benwys/SparrowHawk/hardware/Frame-5in/renders/render_top.png

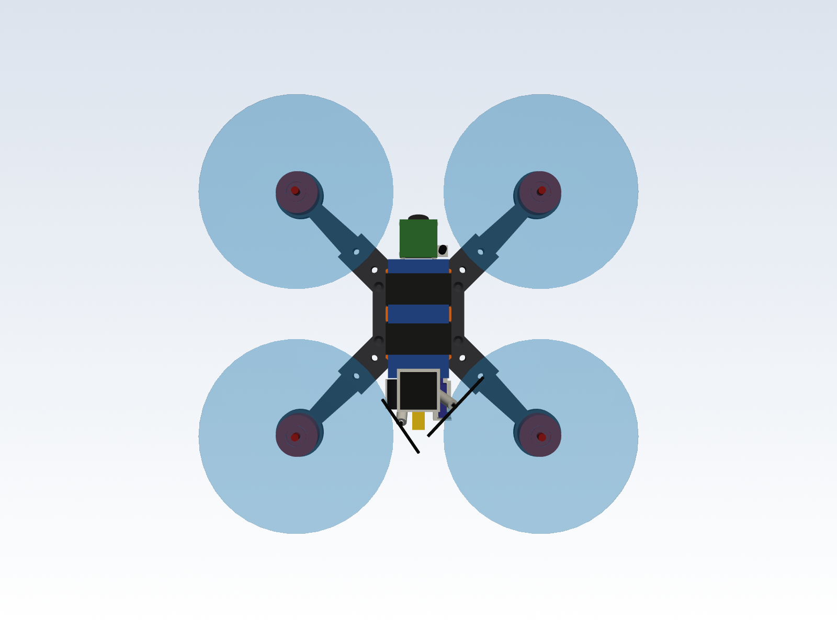
hardware/Frame-5in/renders/render_top.png
