benwys/SparrowHawk/hardware/Frame-5in/renders/render_iso.png

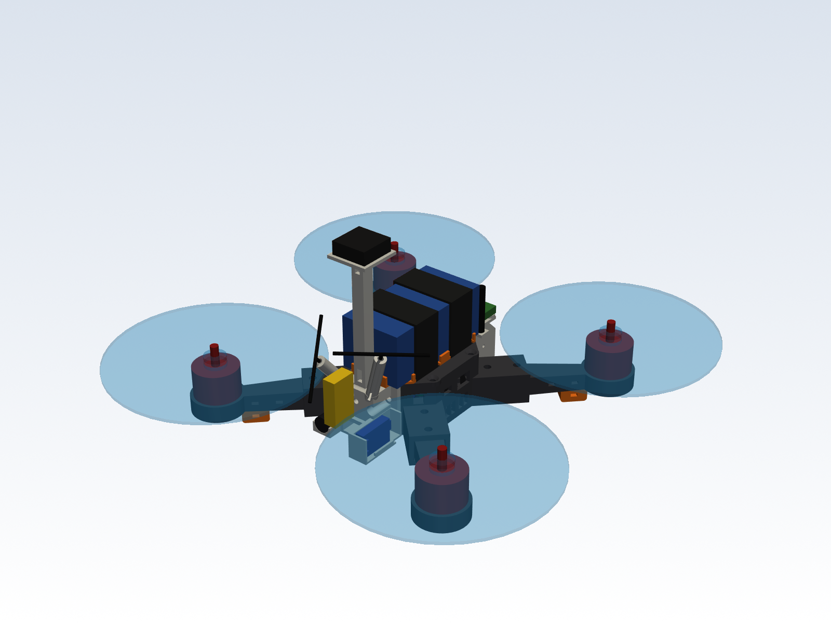
hardware/Frame-5in/renders/render_iso.png
