benwys/SparrowHawk/hardware/Sparrow-III/README.md

# Sparrow-III

Projekt KiCad: **Flight Controller.kicad_pro**.

- [Dokumentacja i stan prac](../../docs/Sparrow-III/README.md)
- [Backlog](../../docs/Sparrow-III/BACKLOG.md)
- [Raport kontroli](../../docs/Sparrow-III/REVIEW.md)
- [Skrypty](../../tools/Sparrow-III/README.md)

Biblioteki są lokalne w `Libraries/`; tabele używają `${KIPRJMOD}`.
Etap: placement, przed pełnym routingiem.

[Wspólna próba trasowania](attempts/placement-closure-20260912/Flight%20Controller.kicad_pro) jest osobnym projektem z miedzią. Główny placement pozostaje bez routingu.
