benwys/SparrowHawk/hardware/Sparrow-III/Production/paczka-report.md

# Pakiet produkcyjny — Flight_Controller-III-order-20261003

Status: **clear** (błędy: 0, ostrzeżenia: 1, informacje: 1).

Źródło: `/tmp/claude-1000/-home-benio-Desktop-SparrowHawk/64d008f5-8a54-4878-97ff-b0f477662982/scratchpad/cand` / `Flight Controller.kicad_pcb` + `Flight Controller.kicad_sch`; KiCad 10.0.6; rewizja: III-order-20261003

Paczka nie jest zgodą na zamówienie. Przed zamówieniem obejrzyj warstwy i obroty w podglądzie producenta i przejrzyj otwarte punkty.

## Ostrzeżenia

- [jlcpcb] montaż na spodzie: obroty i położenie elementów strony Bottom sprawdź w podglądzie producenta

## Informacje

- [assembly] na płytce, ale poza BOM: H_MNT1, H_MNT2, H_MNT3, H_MNT4, JP_BOOT0, J_BAT1, J_RX1, J_SWD1, J_VTX2, TP_IMU_INT_0, TP_VBAT_ADC_0 — nie trafią do montażu

## Ograniczenia

- brak zarejestrowanych

## Pliki

- `assembly/Flight_Controller-III-order-20261003-assembly-bottom.pdf`
- `assembly/Flight_Controller-III-order-20261003-assembly-top.pdf`
- `assembly/Flight_Controller-III-order-20261003-bom.csv`
- `assembly/Flight_Controller-III-order-20261003-pos.csv`
- `assembly/jlcpcb/Flight_Controller-III-order-20261003-bom-jlcpcb.csv`
- `assembly/jlcpcb/Flight_Controller-III-order-20261003-cpl-jlcpcb.csv`
- `checks/bom-flat.csv`
- `checks/drc.json`
- `checks/erc.json`
- `checks/netlist.net`
- `checks/stats.json`
- `fab/Flight_Controller-III-order-20261003-gerbers.zip`
- `fab/Flight_Controller-III-order-20261003.d356`
- `fab/gerber/Flight Controller-B_Cu.gbl`
- `fab/gerber/Flight Controller-B_Mask.gbs`
- `fab/gerber/Flight Controller-B_Paste.gbp`
- `fab/gerber/Flight Controller-B_Silkscreen.gbo`
- `fab/gerber/Flight Controller-Edge_Cuts.gm1`
- `fab/gerber/Flight Controller-F_Cu.gtl`
- `fab/gerber/Flight Controller-F_Mask.gts`
- `fab/gerber/Flight Controller-F_Paste.gtp`
- `fab/gerber/Flight Controller-F_Silkscreen.gto`
- `fab/gerber/Flight Controller-In1_Cu.g1`
- `fab/gerber/Flight Controller-In2_Cu.g2`
- `fab/gerber/Flight Controller-NPTH-drl_map.pdf`
- `fab/gerber/Flight Controller-NPTH.drl`
- `fab/gerber/Flight Controller-PTH-drl_map.pdf`
- `fab/gerber/Flight Controller-PTH.drl`
- `fab/gerber/Flight Controller-job.gbrjob`
- `mech/Flight_Controller-III-order-20261003.step`
- `preview/Flight_Controller-III-order-20261003-bottom.png`
- `preview/Flight_Controller-III-order-20261003-top.png`

Pełne dane: `manifest.json`; polecenia i ich wyjście: `logs/`.
