benwys/SparrowHawk/hardware/Sparrow-III/attempts/placement-closure-20260912/README.md

# Wspólna próba trasowania Sparrow-III

Otwórz **Flight Controller.kicad_pro**. To odebrana lokalna próba z miedzią z 12.09.2026; główny projekt dwa poziomy wyżej pozostaje nieroutowany. Biblioteki i tabele są lokalne.

Wynik: 47/47 wymaganych grup połączeń, 0 nieoczekiwanych DRC, 0 parity. Pozostaje 47 jawnych portów i 101 niepołączonych pozycji poza zakresem próby. Nie jest to kompletny routing produkcyjny.

[Raport i kontrole](../../../../docs/Sparrow-III/review/placement-closure-20260912/REPORT.md) · [Skrypty odtworzenia](../../../../tools/Sparrow-III/placement-closure-20260912/README.md)
