benwys/SparrowHawk/hardware/ESC-MicoAir-AM32-55A/MicoAir_AM32_4in1_55A.png

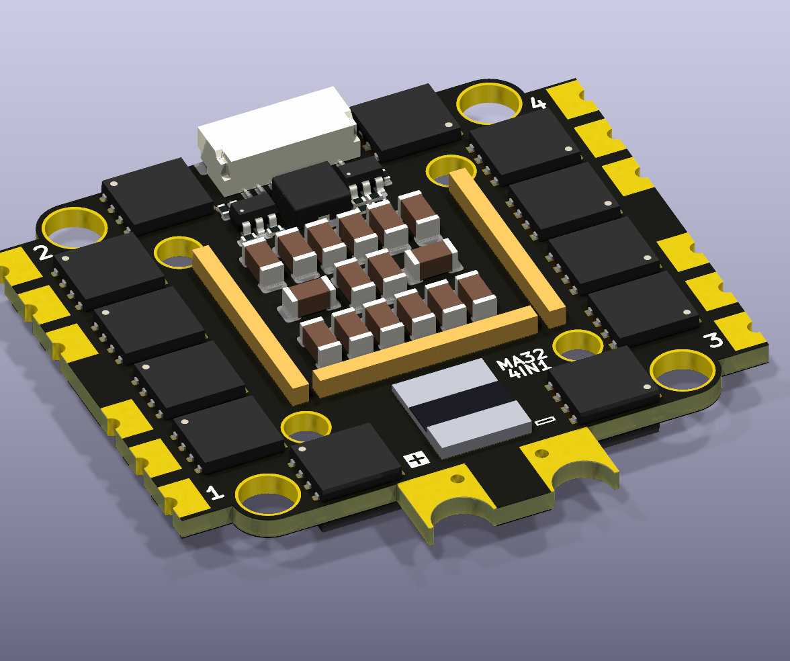
hardware/ESC-MicoAir-AM32-55A/MicoAir_AM32_4in1_55A.png
