benwys/SparrowHawk/hardware/Frame-5in/renders/render_bottom.png

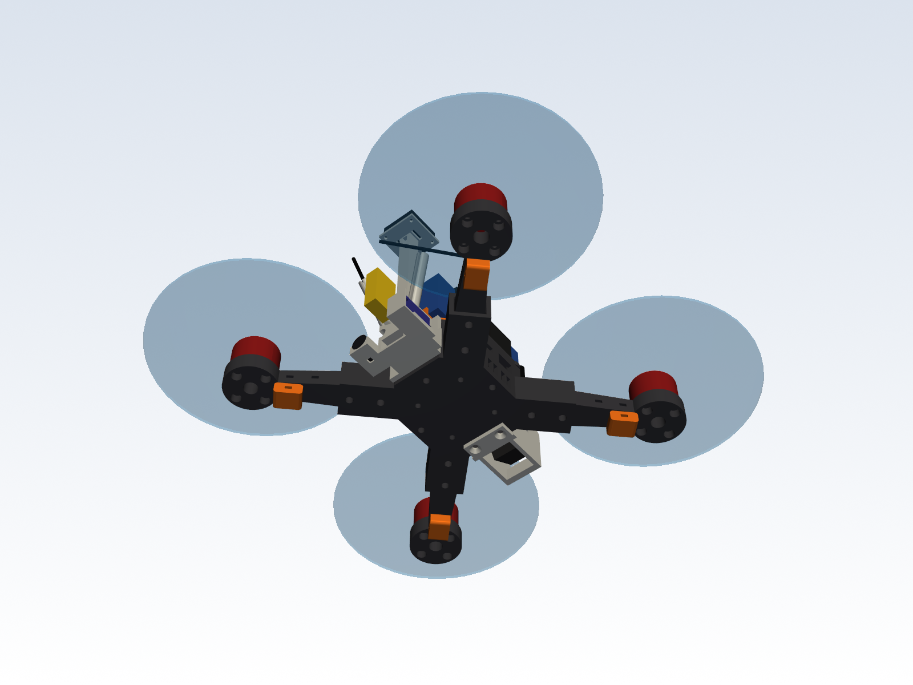
hardware/Frame-5in/renders/render_bottom.png
