benwys/SparrowHawk/hardware/Frame-5in/renders/render_front.png

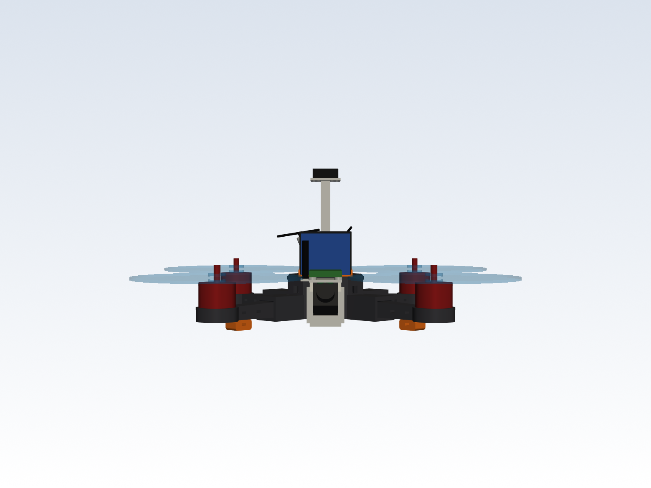
hardware/Frame-5in/renders/render_front.png
