benwys/SparrowHawk/hardware/Frame-5in/renders/render_open.png

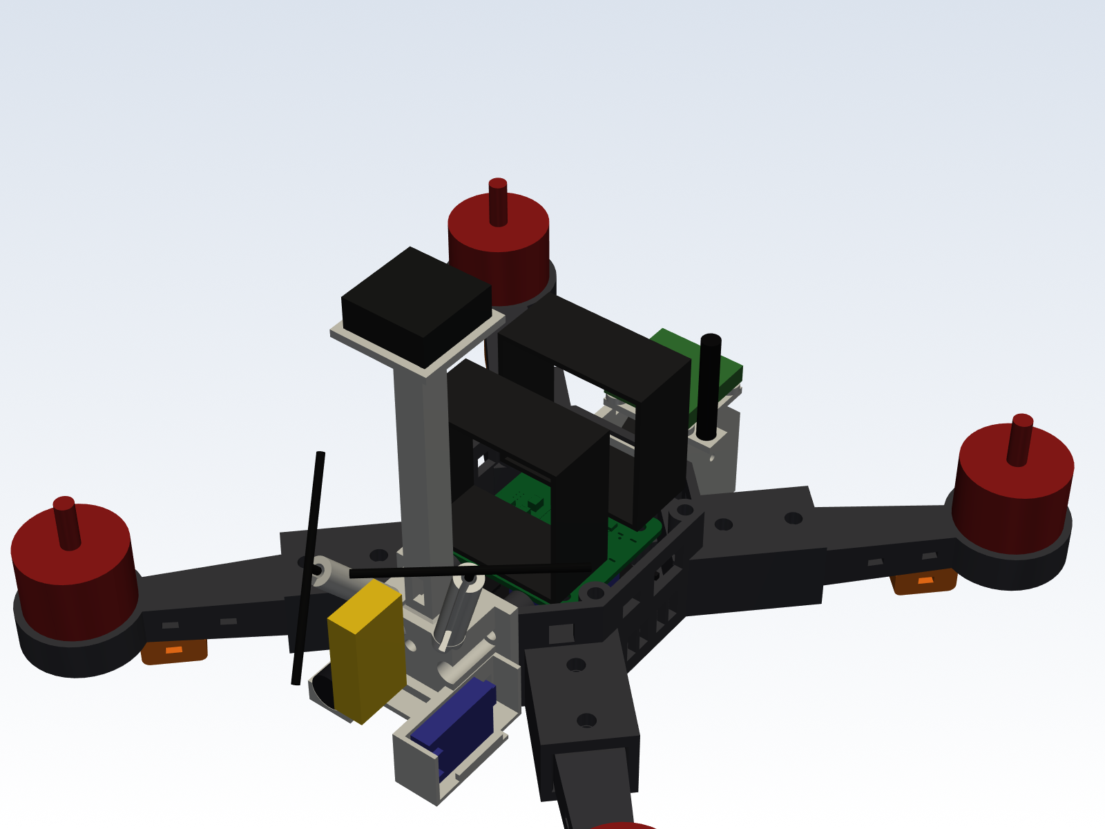
hardware/Frame-5in/renders/render_open.png
