benwys/SparrowHawk/docs/BOM.csv

Reference | Value | Footprint | MPN | Manufacturer | Voltage | Note | Quantity | LCSC
C_3V3_BULK1 | 10uF | Capacitor_SMD:C_0603_1608Metric | CL10A106MO8NQNC | Samsung Electro-Mechanics | 16V | 10uF +/-20%, X5R, 16V, 0603; supplemental bulk. Replaces TDK C1608X5R1C106M080AB (JLC stock 4, 2026-10-03). | 1 | C92487
C_5V_BULK1 | 10uF | Capacitor_SMD:C_0603_1608Metric | CL10A106MO8NQNC | Samsung Electro-Mechanics | 16V | 10uF +/-20%, X5R, 16V, 0603; supplemental bulk. Replaces TDK C1608X5R1C106M080AB (JLC stock 4, 2026-10-03). | 1 | C92487
C_B1 | 47uF | SparrowHawk:CP_Elec_6.3x5.8 | EEE-FT1H470AP | Panasonic | 50V | C_B1 + C_B5 parallel: 94uF / 50V, ESR approx. 340mOhm; 6.3x5.8mm each | 1 | C92059
C_B5 | 47uF | SparrowHawk:CP_Elec_6.3x5.8 | EEE-FT1H470AP | Panasonic | 50V | Parallel with C_B1: 94uF / 50V total, nominal parallel ESR 340mOhm, case height 5.8 +/-0.3mm | 1 | C92059
C_BARO1 | 100nF | Capacitor_SMD:C_0402_1005Metric | GRM155R71H104KE14D | Murata | 50V | 100nF +/-10%, X7R, 50V, 0402. Manufacturer reference sheet archived in docs/Datasheets; nominal value is not a measured effective capacitance. | 1 | C77020
C_BARO2 | 100nF | Capacitor_SMD:C_0402_1005Metric | GRM155R71H104KE14D | Murata | 50V | 100nF +/-10%, X7R, 50V, 0402. Manufacturer reference sheet archived in docs/Datasheets; nominal value is not a measured effective capacitance. | 1 | C77020
C_BUCK_BOOT1 | 100nF | Capacitor_SMD:C_0402_1005Metric | GRM155R71H104KE14D | Murata | 50V | 100nF +/-10%, X7R, 50V, 0402. Manufacturer reference sheet archived in docs/Datasheets; nominal value is not a measured effective capacitance. | 1 | C77020
C_BUCK_IN1 | 4.7uF | Capacitor_SMD:C_1210_3225Metric | C3225X7S2A475KT000N | TDK | 100V | 4.7uF +/-10%, X7S, 100V, 1210; buck input. Same TDK C3225 X7S 100V product under the older ordering code (JLC stock). | 1 | C342614
C_BUCK_IN2 | 4.7uF | Capacitor_SMD:C_1210_3225Metric | C3225X7S2A475KT000N | TDK | 100V | 4.7uF +/-10%, X7S, 100V, 1210; buck input. Same TDK C3225 X7S 100V product under the older ordering code (JLC stock). | 1 | C342614
C_BUCK_IN3 | 100nF | Capacitor_SMD:C_0603_1608Metric | GRM188R72A104KA35D | Murata | 100V | 100nF +/-10%, X7R, 100V, 0603; local high-frequency VIN bypass. | 1 | C77058
C_BUCK_OUT1 | 100uF | Capacitor_SMD:C_1210_3225Metric | EMK325ABJ107MM-T | Taiyo Yuden | 16V | 100uF +/-20%, X5R, 16V, 1210; buck output. 16V rating keeps more capacitance at 5V bias than the 10V TDK it replaces; LMR14030 SNVSA81B 7.2.2.4 sets only minimum COUT. | 1 | C394395
C_BUCK_SS1 | 22nF | Capacitor_SMD:C_0402_1005Metric | GRM155R71C223KA01D | Murata | 16V | 22nF +/-10%, X7R, 16V, 0402; soft-start timing. | 1 | C77010
C_CURR_F1 | 1uF | Capacitor_SMD:C_0402_1005Metric | C0402C105K4PACTU | KEMET | 16V | 1uF +/-10%, X5R, 16V, 0402. Selected in-stock procurement part; qualify ADC settling and VDDA noise on prototype. | 1 | C172740
C_FLASH1 | 100nF | Capacitor_SMD:C_0402_1005Metric | GRM155R71H104KE14D | Murata | 50V | 100nF +/-10%, X7R, 50V, 0402. Manufacturer reference sheet archived in docs/Datasheets; nominal value is not a measured effective capacitance. | 1 | C77020
C_HSE1 | 12pF | Capacitor_SMD:C_0402_1005Metric | GRM1555C1H120GA01D | Murata | 50V | 12pF +/-2%, C0G/NP0, 50V, 0402. Prototype starting loads; effective CL=6pF+stray; verify startup margin/frequency/drive with actual crystal. | 1 | C161527
C_HSE2 | 12pF | Capacitor_SMD:C_0402_1005Metric | GRM1555C1H120GA01D | Murata | 50V | 12pF +/-2%, C0G/NP0, 50V, 0402. Prototype starting loads; effective CL=6pF+stray; verify startup margin/frequency/drive with actual crystal. | 1 | C161527
C_IMU_VDD1 | 2.2uF | Capacitor_SMD:C_0402_1005Metric | GRM155R61C225KE11D | Murata | 16V | 2.2uF +/-10%, X5R, 16V, 0402; local IMU decoupling; nominal capacitance is not guaranteed biased capacitance. | 1 | C88944
C_IMU_VDD2 | 100nF | Capacitor_SMD:C_0402_1005Metric | GRM155R71H104KE14D | Murata | 50V | 100nF +/-10%, X7R, 50V, 0402. Manufacturer reference sheet archived in docs/Datasheets; nominal value is not a measured effective capacitance. | 1 | C77020
C_IMU_VIO1 | 100nF | Capacitor_SMD:C_0402_1005Metric | GRM155R71H104KE14D | Murata | 50V | 100nF +/-10%, X7R, 50V, 0402. Manufacturer reference sheet archived in docs/Datasheets; nominal value is not a measured effective capacitance. | 1 | C77020
C_IMU_VIO2 | 10nF | Capacitor_SMD:C_0402_1005Metric | GRM155R71C103KA01D | Murata | 16V | 10nF +/-10%, X7R, 16V, 0402; IMU VDDIO high-frequency decoupling. | 1 | C85735
C_LDO_IN1 | 2.2uF | Capacitor_SMD:C_0603_1608Metric | GRM188Z71E225KE43D | Murata | 25V | 2.2uF +/-10%, X7R, 25V, 0603; LDO in/out. TLV755P SBVS320D requires >0.47uF effective. Replaces TDK X7S (not at JLC). | 1 | C415535
C_LDO_OUT1 | 2.2uF | Capacitor_SMD:C_0603_1608Metric | GRM188Z71E225KE43D | Murata | 25V | 2.2uF +/-10%, X7R, 25V, 0603; LDO in/out. TLV755P SBVS320D requires >0.47uF effective. Replaces TDK X7S (not at JLC). | 1 | C415535
C_MAG_BULK1 | 22uF | Capacitor_SMD:C_0805_2012Metric | CL21A226MOQNNNE | Samsung Electro-Mechanics | 16V | 22uF +/-20%, X5R, 16V, 0805; LIS2MDL local bulk. | 1 | C98190
C_MAG_SET1 | 220nF | Capacitor_SMD:C_0402_1005Metric | CL05B224KO5NNNC | Samsung Electro-Mechanics | 16V | 220nF +/-10%, X7R, 16V, 0402; LIS2MDL C1 set/reset capacitor. JLC basic part. | 1 | C16772
C_MAG_VDD1 | 100nF | Capacitor_SMD:C_0402_1005Metric | GRM155R71H104KE14D | Murata | 50V | 100nF +/-10%, X7R, 50V, 0402. Manufacturer reference sheet archived in docs/Datasheets; nominal value is not a measured effective capacitance. | 1 | C77020
C_MAG_VIO1 | 100nF | Capacitor_SMD:C_0402_1005Metric | GRM155R71H104KE14D | Murata | 50V | 100nF +/-10%, X7R, 50V, 0402. Manufacturer reference sheet archived in docs/Datasheets; nominal value is not a measured effective capacitance. | 1 | C77020
C_NRST1 | 100nF | Capacitor_SMD:C_0402_1005Metric | GRM155R71H104KE14D | Murata | 50V | 100nF +/-10%, X7R, 50V, 0402. Manufacturer reference sheet archived in docs/Datasheets; nominal value is not a measured effective capacitance. | 1 | C77020
C_VBAT_ADC1 | 100nF | Capacitor_SMD:C_0402_1005Metric | GRM155R71H104KE14D | Murata | 50V | 100nF +/-10%, X7R, 50V, 0402. Manufacturer reference sheet archived in docs/Datasheets; nominal value is not a measured effective capacitance. | 1 | C77020
C_VCAP1 | 4.7uF | Capacitor_SMD:C_0805_2012Metric | CL21B475KPFNNNE | Samsung Electro-Mechanics | 10V | 4.7uF +/-10%, X7R, 10V, 0805; VCAP. Branch ESR set by R_VCAP_ESR1 0.15R (DS11853 table 19: 0.1-0.2 ohm). | 1 | C87998
C_VDD1 | 100nF | Capacitor_SMD:C_0402_1005Metric | GRM155R71H104KE14D | Murata | 50V | 100nF +/-10%, X7R, 50V, 0402. Manufacturer reference sheet archived in docs/Datasheets; nominal value is not a measured effective capacitance. | 1 | C77020
C_VDD2 | 100nF | Capacitor_SMD:C_0402_1005Metric | GRM155R71H104KE14D | Murata | 50V | 100nF +/-10%, X7R, 50V, 0402. Manufacturer reference sheet archived in docs/Datasheets; nominal value is not a measured effective capacitance. | 1 | C77020
C_VDD3 | 100nF | Capacitor_SMD:C_0402_1005Metric | GRM155R71H104KE14D | Murata | 50V | 100nF +/-10%, X7R, 50V, 0402. Manufacturer reference sheet archived in docs/Datasheets; nominal value is not a measured effective capacitance. | 1 | C77020
C_VDD4 | 100nF | Capacitor_SMD:C_0402_1005Metric | GRM155R71H104KE14D | Murata | 50V | 100nF +/-10%, X7R, 50V, 0402. Manufacturer reference sheet archived in docs/Datasheets; nominal value is not a measured effective capacitance. | 1 | C77020
C_VDDA1 | 1uF | Capacitor_SMD:C_0402_1005Metric | C0402C105K4PACTU | KEMET | 16V | 1uF +/-10%, X5R, 16V, 0402. Selected in-stock procurement part; qualify ADC settling and VDDA noise on prototype. | 1 | C172740
C_VDDA_HF1 | 100nF | Capacitor_SMD:C_0402_1005Metric | GRM155R71H104KE14D | Murata | 50V | 100nF +/-10%, X7R, 50V, 0402. Manufacturer reference sheet archived in docs/Datasheets; nominal value is not a measured effective capacitance. | 1 | C77020
C_VDD_BULK1 | 4.7uF | Capacitor_SMD:C_0603_1608Metric | GRM188R61C475KE11D | Murata | 16V | 4.7uF +/-10%, X5R, 16V, 0603; supplementary MCU bulk. | 1 | C77045
D_BUCK1 | STPS3H100U | SparrowHawk:D_SMB | STPS3H100U | STMicroelectronics |  | 100V / 3A; SMB; cathode pad 1 = SW, anode pad 2 = GND | 1 | C283521
D_TVS1 | SMAJ26A | Diode_SMD:D_SMA | SMAJ26A | Littelfuse |  | 4S-6S conventional LiPo only, max steady input 25.2V. Vwm=26V; Vc=42.1V at 9.5A (10/1000us). Verify VIN overshoot and surge energy; not a guaranteed 44V clamp. | 1 | C148225
D_USB_VBUS1 | PMEG2010AEH | Diode_SMD:D_SOD-123F | PMEG2010AEH,115 | Nexperia |  |  | 1 | C110921
FB_IMU1 | 600R @ 100MHz | Inductor_SMD:L_0402_1005Metric | BLM15AG601SN1D | Murata |  | 600ohm +/-25% at100MHz, 0402, rated300mA, DCR max0.52ohm. Low-current IMU branch; test rail noise. | 1 | C76884
FB_VDDA1 | 100R @ 100MHz | Inductor_SMD:L_0402_1005Metric | HCB1005KF-101T10 | TAI-TECH |  | 100ohm +/-25% at 100MHz, 0402, 1A, DCR 0.2ohm; VDDA filter. Replaces TE 1-2176742-6 (not at LCSC/JLC). | 1 | C356953
J_ESC1 | BM08B-SRSS-TB_LF__SN_ | SparrowHawk:JST_BM08B-SRSS-TB_LF__SN_ | BM08B-SRSS-TB(LF)(SN) | JST Sales |  | FC pinout fixed; custom harness must map selected ESC signals. Do not assume1:1 cable. With J_BAT input, omit ESC VBAT conductor; retain common GND. | 1 | C160394
J_GPS1 | BM06B-SRSS-TB_LF__SN_ | SparrowHawk:JST_BM06B-SRSS-TB_LF__SN_ | BM06B-SRSS-TB(LF)(SN) | JST Sales |  |  | 1 | C160392
J_USB1 | DX07S016JA1R1500 | SparrowHawk:USB_C_Receptacle_JAE_DX07S016JA1R1500 | DX07S016JA1R1500 | JAE |  |  | 1 | C3197885
LED_PWR1 | LED Green 0603 | LED_SMD:LED_0603_1608Metric | LTST-C190KGKT | Lite-On |  | 0603 green indicator; KiCad pad1=cathode, pad2=anode. Verify cathode mark during assembly. Existing1k series resistor retained; brightness at board current must be checked. | 1 | C125094
LED_STAT1 | LED Blue 0603 | LED_SMD:LED_0603_1608Metric | LTST-C190TBKT | Lite-On |  | 0603 blue indicator; KiCad pad1=cathode, pad2=anode. Verify cathode mark during assembly. Existing1k series resistor retained; brightness at board current must be checked. | 1 | C125096
LED_STAT2 | LED Red 0603 | LED_SMD:LED_0603_1608Metric | LTST-C190KRKT | Lite-On |  | 0603 red indicator; KiCad pad1=cathode, pad2=anode. Verify cathode mark during assembly. Existing1k series resistor retained; brightness at board current must be checked. | 1 | C94869
L_BUCK1 | 6.8uH | SparrowHawk:L_Vishay_IHLP-2525CZ-01 | IHLP2525CZER6R8M01 | Vishay |  | 6.8uH +/-20%; Isat typ8A at 20% L drop/25C; heat rating typ4.5A; DCR max60mohm; h<=3mm. Replaces Sunlord2.6A. Buck ILIM max6.6A; hot/start/short validation still required. System5V design budget1A. | 1 | C506575
R_BOOT0 | 10k | Resistor_SMD:R_0402_1005Metric | RC0402FR-0710KL | YAGEO |  | 0402 thick-film, +/-1%, 0.063W. Voltage/power derating applies. | 1 | C60490
R_BUCK_FB1 | 100k | Resistor_SMD:R_0402_1005Metric | RC0402FR-07100KL | YAGEO |  | 0402 thick-film, +/-1%, 0.063W. Voltage/power derating applies. | 1 | C60491
R_BUCK_FB2 | 17.8k | Resistor_SMD:R_0402_1005Metric | RC0402FR-0717K8L | YAGEO |  | 0402 thick-film, +/-1%, 0.063W. Voltage/power derating applies. | 1 | C185458
R_BUCK_RT1 | 49.9k | Resistor_SMD:R_0402_1005Metric | CR0402-FX-4992GLF | Bourns |  | 49.9k +/-1%, 0402, 0.063W; selected in-stock part for buck switching-frequency resistor. | 1 | C2076619
R_CC1 | 5.1k | Resistor_SMD:R_0402_1005Metric | RC0402FR-075K1L | YAGEO |  | 0402 thick-film, +/-1%, 0.063W. Voltage/power derating applies. | 1 | C105872
R_CC2 | 5.1k | Resistor_SMD:R_0402_1005Metric | RC0402FR-075K1L | YAGEO |  | 0402 thick-film, +/-1%, 0.063W. Voltage/power derating applies. | 1 | C105872
R_CURR_F1 | 1k | Resistor_SMD:R_0402_1005Metric | RC0402FR-071KL | YAGEO |  | 0402 thick-film, +/-1%, 0.063W. Voltage/power derating applies. | 1 | C106235
R_FLASH_CS1 | 10k | Resistor_SMD:R_0402_1005Metric | RC0402FR-0710KL | YAGEO |  | 0402 thick-film, +/-1%, 0.063W. Voltage/power derating applies. | 1 | C60490
R_FLASH_HD1 | 10k | Resistor_SMD:R_0402_1005Metric | RC0402FR-0710KL | YAGEO |  | 0402 thick-film, +/-1%, 0.063W. Voltage/power derating applies. | 1 | C60490
R_FLASH_WP1 | 10k | Resistor_SMD:R_0402_1005Metric | RC0402FR-0710KL | YAGEO |  | 0402 thick-film, +/-1%, 0.063W. Voltage/power derating applies. | 1 | C60490
R_HSE2 | 0R | Resistor_SMD:R_0402_1005Metric | ERJ-2GE0R00X | Panasonic |  | 0ohm jumper, 0402; series HSE tuning position, initially populated. | 1 | C242160
R_I2C_SCL1 | 4.7k | Resistor_SMD:R_0402_1005Metric | RC0402FR-074K7L | YAGEO |  | 0402 thick-film, +/-1%, 0.063W. Voltage/power derating applies. | 1 | C105871
R_I2C_SDA1 | 4.7k | Resistor_SMD:R_0402_1005Metric | RC0402FR-074K7L | YAGEO |  | 0402 thick-film, +/-1%, 0.063W. Voltage/power derating applies. | 1 | C105871
R_LED1 | 1k | Resistor_SMD:R_0402_1005Metric | RC0402FR-071KL | YAGEO |  | 0402 thick-film, +/-1%, 0.063W. Voltage/power derating applies. | 1 | C106235
R_LED2 | 1k | Resistor_SMD:R_0402_1005Metric | RC0402FR-071KL | YAGEO |  | 0402 thick-film, +/-1%, 0.063W. Voltage/power derating applies. | 1 | C106235
R_LED3 | 1k | Resistor_SMD:R_0402_1005Metric | RC0402FR-071KL | YAGEO |  | 0402 thick-film, +/-1%, 0.063W. Voltage/power derating applies. | 1 | C106235
R_USB_SH1 | 0R | Resistor_SMD:R_0402_1005Metric | ERJ-2GE0R00X | Panasonic |  | 0ohm jumper, 0402; direct USB shield-to-GND connection. | 1 | C242160
R_VBAT_D1 | 100k | Resistor_SMD:R_0402_1005Metric | RC0402FR-07100KL | YAGEO |  | 0402 thick-film, +/-1%, 0.063W. Voltage/power derating applies. | 1 | C60491
R_VBAT_D2 | 10k | Resistor_SMD:R_0402_1005Metric | RC0402FR-0710KL | YAGEO |  | 0402 thick-film, +/-1%, 0.063W. Voltage/power derating applies. | 1 | C60490
R_VCAP_ESR1 | 0.15R | SparrowHawk:R_0603_1608Metric | 0603WAF150LT5E | UNI-ROYAL |  | 0.15ohm +/-1%, 0.1W, 0603, TCR 800ppm/K; VCAP series ESR, branch stays within 0.1-0.2 ohm over temperature. | 1 | C45879
U_BARO1 | DPS368 | SparrowHawk:XDCR_DPS310 | DPS368XTSA1 | Infineon Technologies |  | Baro: DPS310XTSA1 discontinued at LCSC/JLC. DPS368 has the same 2.0x2.5mm LGA-8 pinout (height 1.1mm) and DPS3xx register interface; firmware must accept DPS368. | 1 | C3232508
U_BUCK1 | LMR14030SDDAR | SparrowHawk:SOIC127P600X170-9N_SparrowIII | LMR14030SDDAR | Texas Instruments |  |  | 1 | C182078
U_ESD1 | USBLC6-2SC6 | Package_TO_SOT_SMD:SOT-23-6 | USBLC6-2SC6 | STMicroelectronics |  |  | 1 | C7519
U_FLASH1 | W25Q128JVPIQ | SparrowHawk:WSON-8-1EP_6x5mm_P1.27mm_EP3.4x4.3mm | W25Q128JVPIQ | Winbond |  | Package P, WSON 6x5mm. EP pad 9 tied to GND; pinout 1-8 unchanged. | 1 | C190862
U_IMU1 | ICM-42688-P | SparrowHawk:PQFN50P300X250X97-14N | ICM-42688-P | TDK InvenSense |  |  | 1 | C1850418
U_LDO1 | TLV75533PDYDR | SparrowHawk:SOT-23-5_ThermalPad_TI_DYD0005A | TLV75533PDYDR | Texas Instruments |  | 300mA board design budget; VIN<=5.5V. Thermal pad6 to GND with short thermal vias. Qualify actual board temperature; catalog RthetaJA is not a PCB measurement. | 1 | C28642215
U_MAG1 | LIS2MDLTR | SparrowHawk:LGA-12_2x2mm_P0.5mm | LIS2MDLTR | STMicroelectronics |  | LIS2MDLTR, I2C1 address 0x1E, Betaflight LIS2MDL driver. Distributor stock unresolved on 2026-09-10; GPS compass address must differ | 1 | C919695
U_MCU1 | STM32F722RETx | Package_QFP:LQFP-64_10x10mm_P0.5mm | STM32F722RET6 | STMicroelectronics |  |  | 1 | C118207
Y_HSE1 | 8MHz | Crystal:Crystal_SMD_3225-4Pin_3.2x2.5mm | X32258MOB4SI | YXC |  | 8MHz, CL 12pF, ESR max 180ohm, +/-10ppm/+/-20ppm, 3225-4P, -40..+85C. gm_crit ~0.41mA/V < 1mA/V (STM32F722 Gm_crit_max). Replaces Abracon custom code not stocked by distributors. | 1 | C2682775
