benwys/SparrowHawk/hardware/Frame-5in/renders/render_parts.png

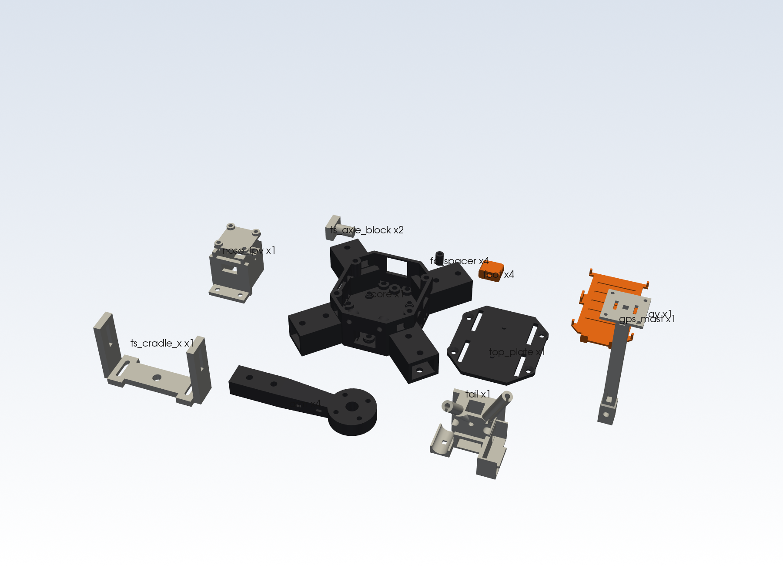
hardware/Frame-5in/renders/render_parts.png
