benwys/SparrowHawk/hardware/Sparrow-III/Production/Flight_Controller-III-order-20261003-bottom.png

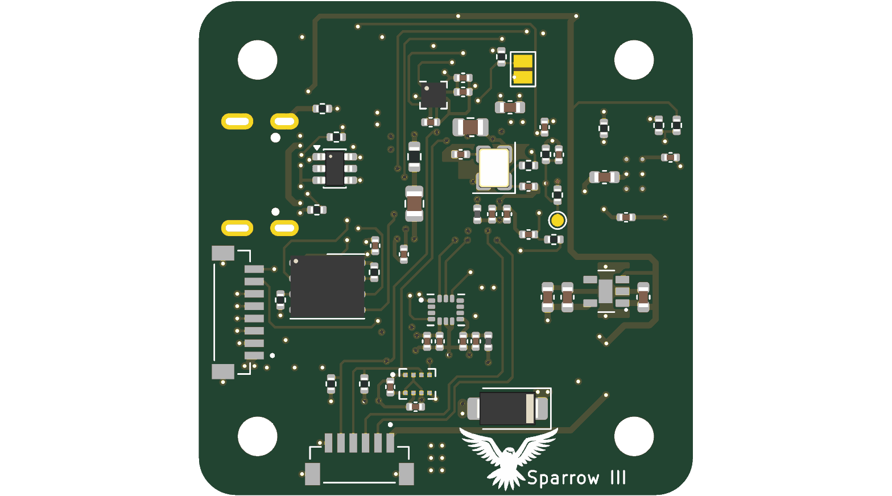
hardware/Sparrow-III/Production/Flight_Controller-III-order-20261003-bottom.png
