benwys/SparrowHawk/hardware/Frame-5in/Frame-5in_assembly.step

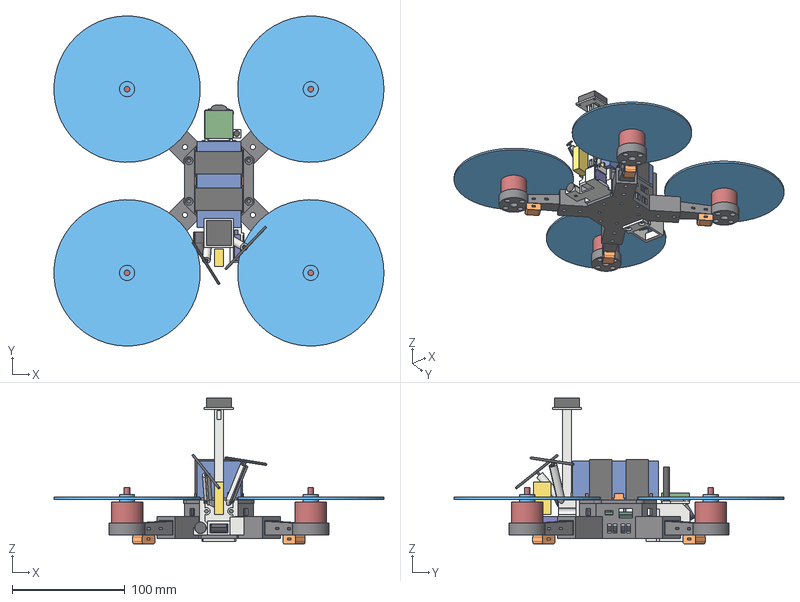
[picture p9: CAD file, 2026-10-11]
hardware/Frame-5in/Frame-5in_assembly.step
292.1 x 292.1 x 129.2 mm
core
top_plate
battery_tray
tail
arm1
foot1
arm2
foot2
arm3
foot3
arm4
foot4
fc_spacer1
fc_spacer2
fc_spacer3
fc_spacer4
nose_fpv
gps_mast
esc
fc
esc_sh_plug
motor1
prop1
motor2
prop2
motor3
prop3
motor4
prop4
battery
strap_front
strap_rear
xt60
capacitor
battery_leads
receiver
rx_sh
rx_ipex1
rx_ipex2
rx_ant_L
rx_ant_R
camera
vtx
vtx_ant
gps
