benwys/SparrowHawk/hardware/Frame-5in/step/coupon_socket_full.step

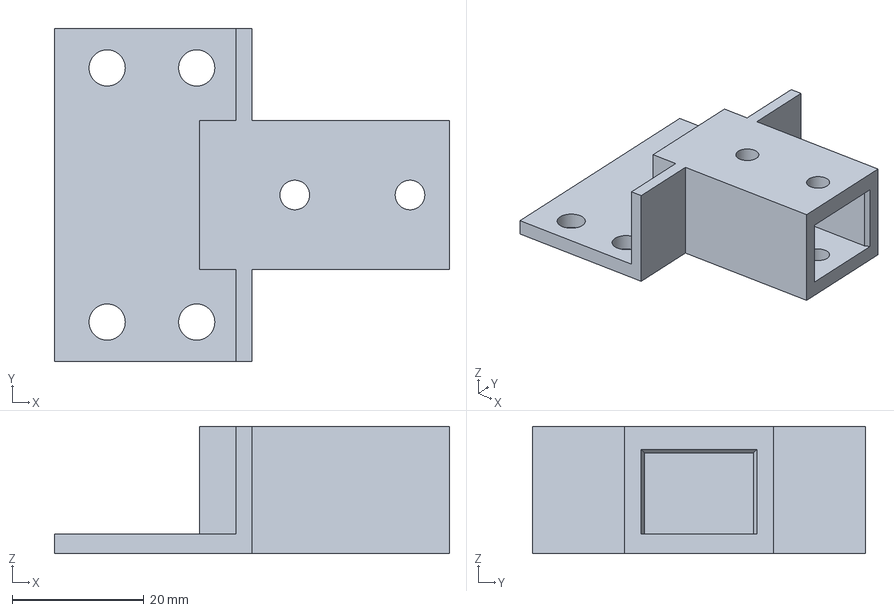
[picture p10: CAD file, 2026-10-08]
hardware/Frame-5in/step/coupon_socket_full.step
60.0 x 50.6 x 19.3 mm
