benwys/SparrowHawk/hardware/ESC-MicoAir-AM32-55A/3d/BusBar_1.2x15.9x1.5.step

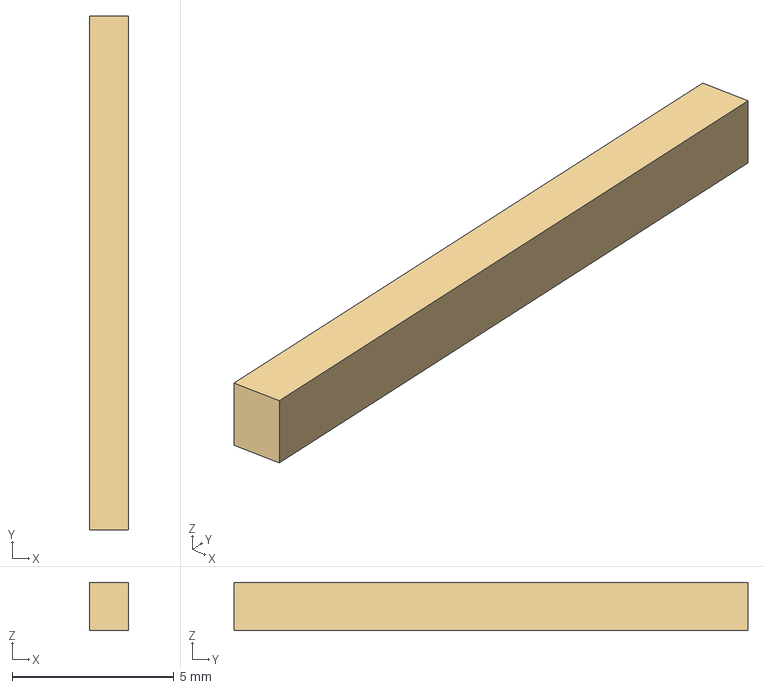
[picture p11: CAD file, 2026-10-06]
hardware/ESC-MicoAir-AM32-55A/3d/BusBar_1.2x15.9x1.5.step
1.20 x 15.9 x 1.50 mm
