benwys/SparrowHawk/hardware/ESC-MicoAir-AM32-55A/MicoAir_AM32_4in1_55A.step

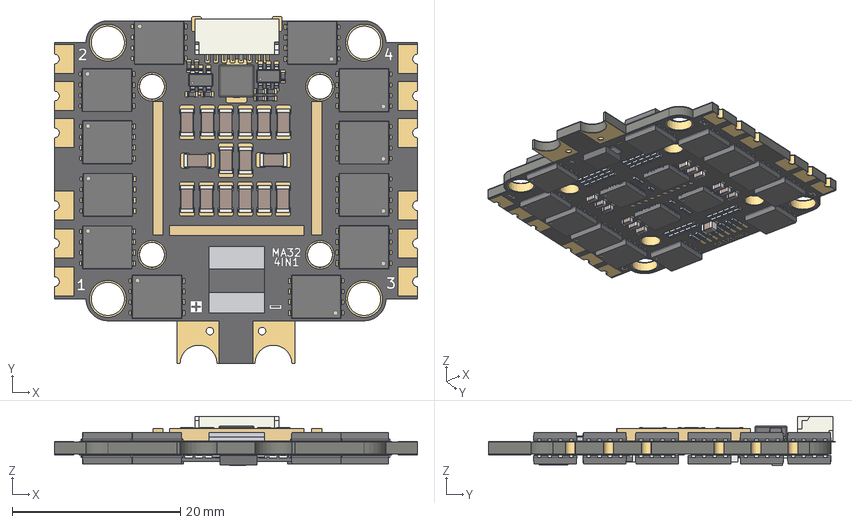
[picture p12: CAD file, 2026-10-06]
hardware/ESC-MicoAir-AM32-55A/MicoAir_AM32_4in1_55A.step
43.2 x 41.3 x 5.89 mm
C_1206_3216Metric x 16
BusBar_16.0x1.2x1.5
TDSON_8_1 x 24
BusBar_1.2x15.9x1.5 x 2
R_0402_1005Metric x 81
JST_SH_SM08B-SRSS-TB_1x08-1MP_P1.00mm_Horizontal
SOT-23-6 x 2
L_Changjiang_FXL0420
Shunt_0m25_6.6x7.9
C_0805_2012Metric
C_0603_1608Metric x 12
QFN-32-1EP_5x5mm_Pitch0.5mm x 4
TVS_SMBF
MicoAir_AM32_4in1_55A_pad
MicoAir_AM32_4in1_55A_silkscreen x 2
MicoAir_AM32_4in1_55A_soldermask x 2
MicoAir_AM32_4in1_55A_PCB
