benwys/SparrowHawk/hardware/Frame-5in/step/battery_tray.step

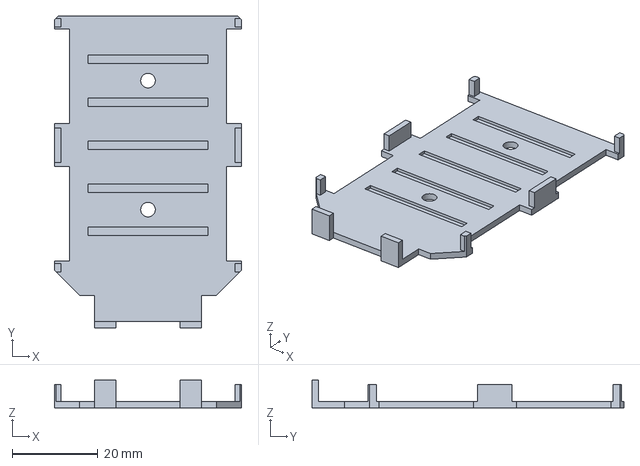
[picture p13: CAD file, 2026-10-08]
hardware/Frame-5in/step/battery_tray.step
43.5 x 72.5 x 6.50 mm
