benwys/SparrowHawk/hardware/Sparrow-II/Production/Flight Controller.step

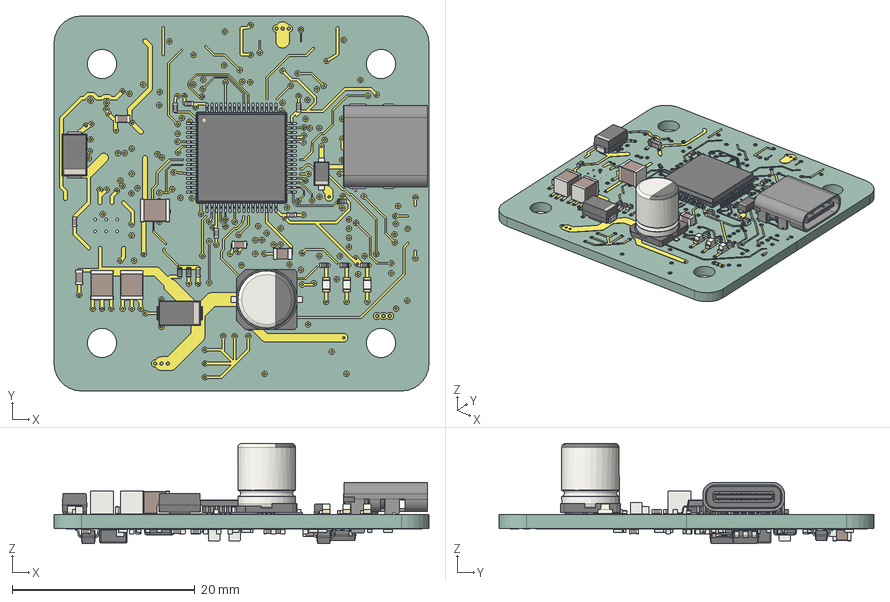
[picture p14: CAD file, 2026-08-25]
hardware/Sparrow-II/Production/Flight Controller.step
41.0 x 41.0 x 10.9 mm
C_0805_2012Metric x 4
C_0402_1005Metric x 29
LED_0603_1608Metric x 3
C_1210_3225Metric x 3
R_0402_1005Metric x 22
D_SMA x 2
D_SOD_123F
LQFP-64_10x10mm_P0.5mm
USB_C_Receptacle_GCT_USB4085
CP_Elec_63x77
C_0603_1608Metric x 5
Crystal_SMD_3225-4Pin_3.2x2.5mm x 2
SOT-23
L_0402_1005Metric x 2
SOT-23-6
SOT-23-5
a65073d4-8551-11ed-a139-00155d22e2d7_part
a650750a-8551-11ed-a139-00155d22e2d7_part
a650758c-8551-11ed-a139-00155d22e2d7_part
Flight Controller_copper
Flight Controller_via
Flight Controller_PCB
