benwys/SparrowHawk/hardware/ESC-MicoAir-AM32-55A/3d/BusBar_16.0x1.2x1.5.step

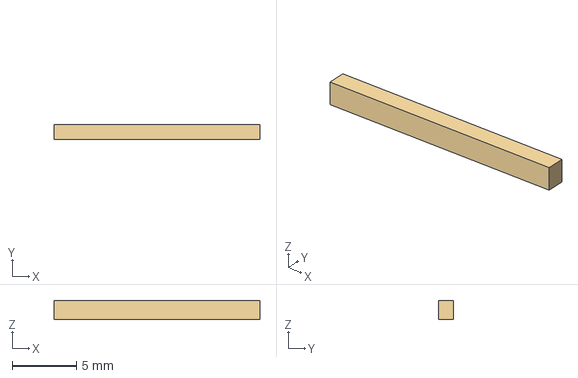
[picture p15: CAD file, 2026-10-06]
hardware/ESC-MicoAir-AM32-55A/3d/BusBar_16.0x1.2x1.5.step
16.0 x 1.20 x 1.50 mm
