benwys/SparrowHawk/hardware/Frame-5in/step/ts_cradle_x.step

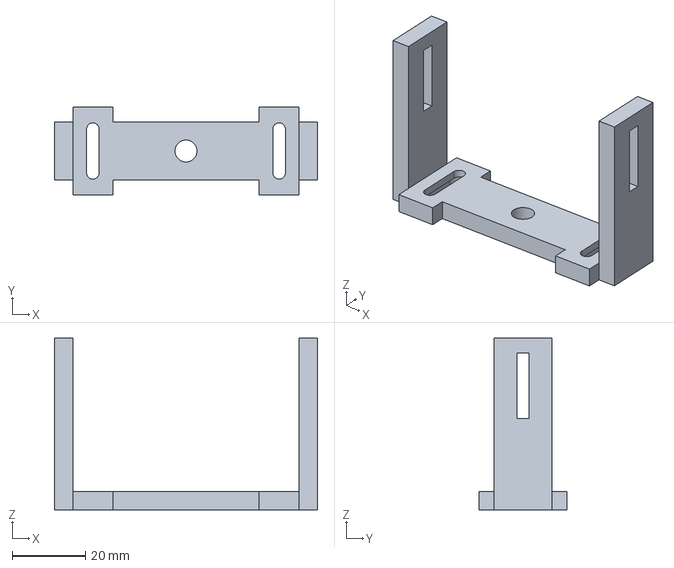
[picture p16: CAD file, 2026-10-08]
hardware/Frame-5in/step/ts_cradle_x.step
72.0 x 24.0 x 47.0 mm
