benwys/SparrowHawk/hardware/ESC-MicoAir-AM32-55A/3d/TVS_SMBF.step

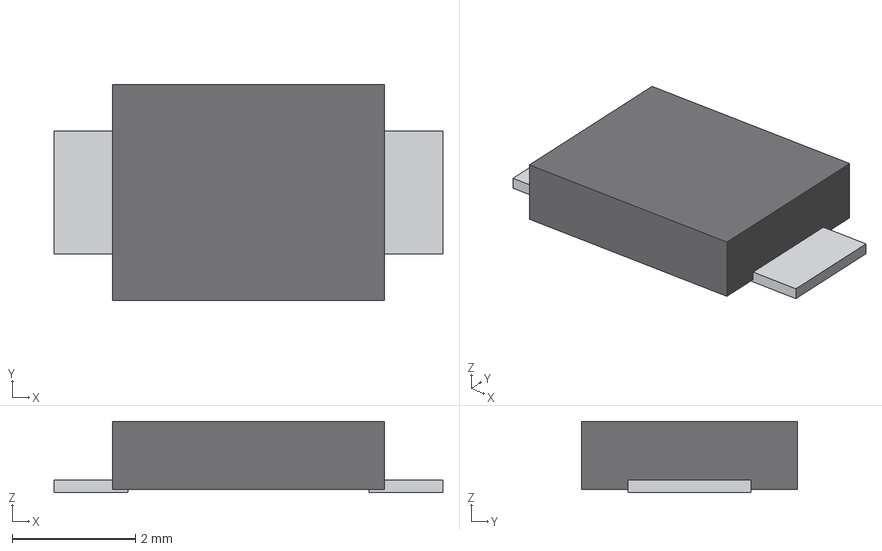
[picture p17: CAD file, 2026-10-06]
hardware/ESC-MicoAir-AM32-55A/3d/TVS_SMBF.step
6.30 x 3.50 x 1.15 mm
