benwys/SparrowHawk/hardware/Frame-5in/step/foot.step

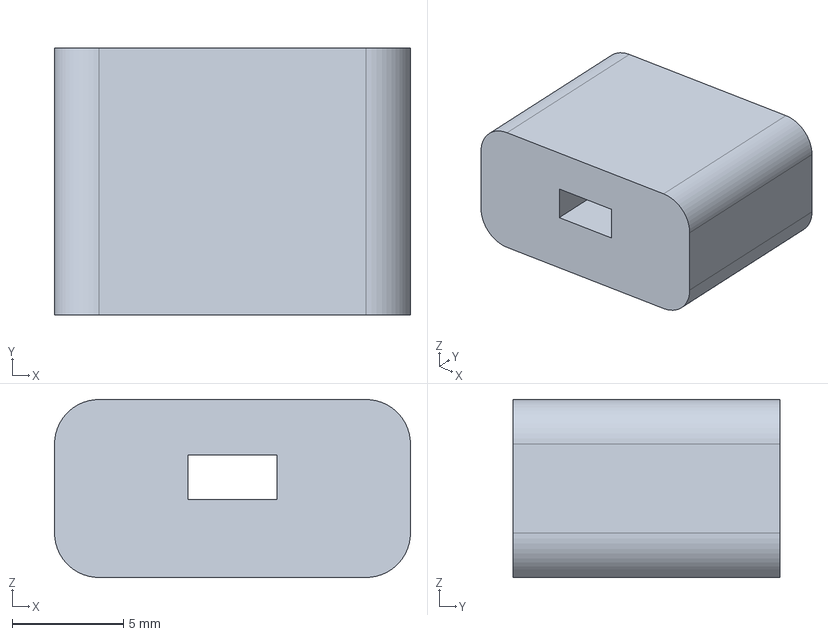
[picture p18: CAD file, 2026-10-08]
hardware/Frame-5in/step/foot.step
16.0 x 12.0 x 8.00 mm
