benwys/SparrowHawk/hardware/ESC-MicoAir-AM32-55A/3d/Shunt_0m25_6.6x7.9.step

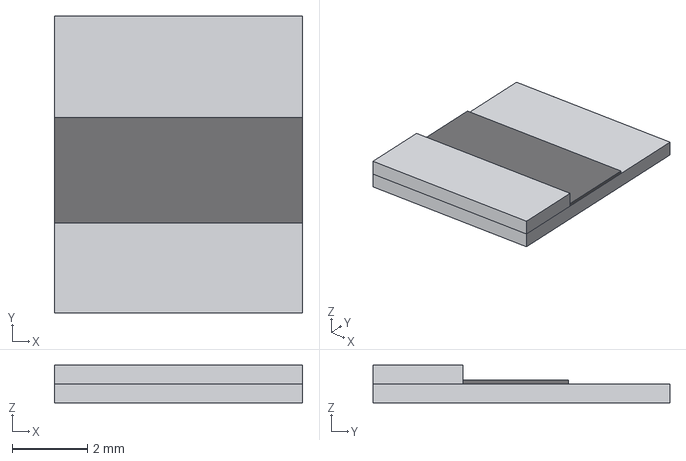
[picture p19: CAD file, 2026-10-06]
hardware/ESC-MicoAir-AM32-55A/3d/Shunt_0m25_6.6x7.9.step
6.60 x 7.90 x 1.00 mm
