benwys/SparrowHawk/hardware/Frame-5in/step/top_plate.step

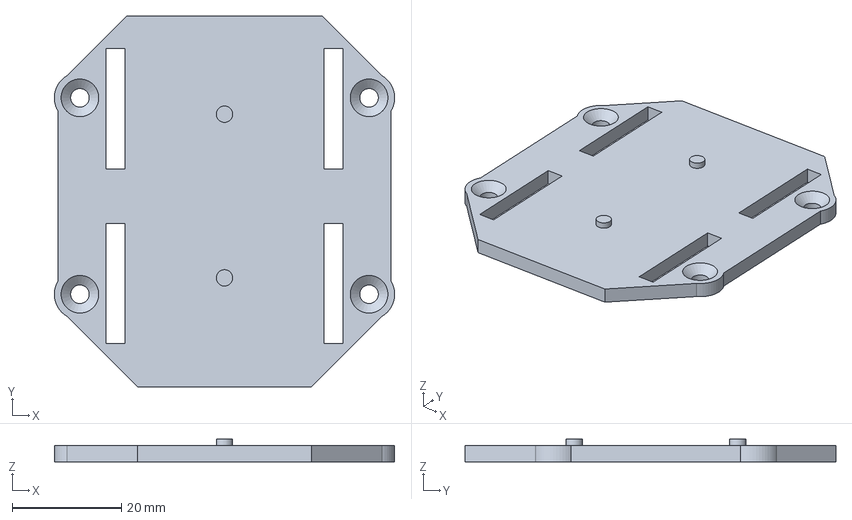
[picture p20: CAD file, 2026-10-08]
hardware/Frame-5in/step/top_plate.step
62.4 x 68.0 x 4.20 mm
