benwys/SparrowHawk/hardware/Frame-5in/step/core.step

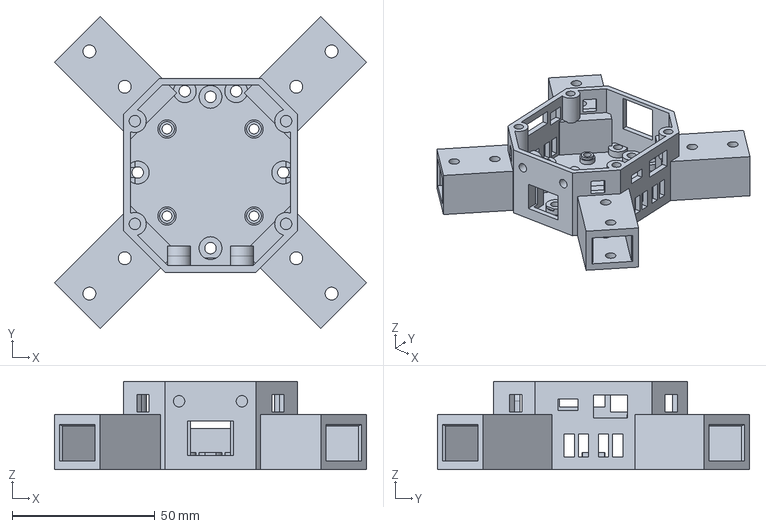
[picture p21: CAD file, 2026-10-08]
hardware/Frame-5in/step/core.step
109.3 x 109.3 x 31.0 mm
