benwys/SparrowHawk/hardware/Frame-5in/step/gps_mast_52.step

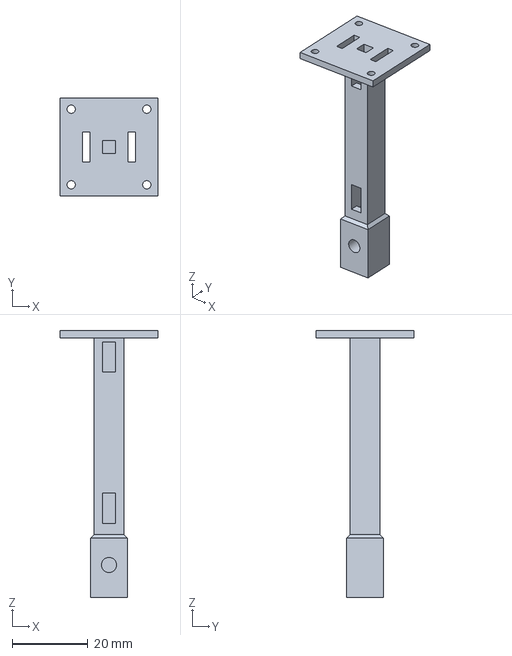
[picture p22: CAD file, 2026-10-08]
hardware/Frame-5in/step/gps_mast_52.step
26.0 x 26.0 x 70.6 mm
