benwys/SparrowHawk/hardware/Frame-5in/step/coupon_arm.step

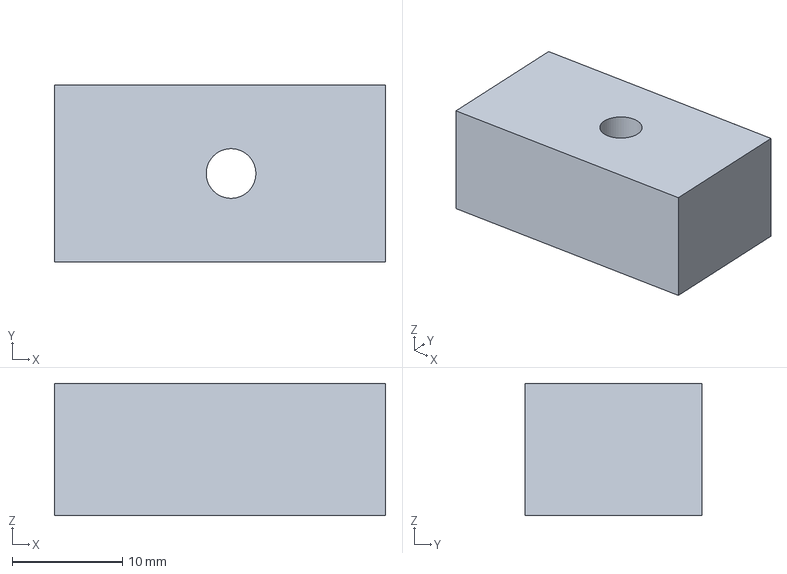
[picture p23: CAD file, 2026-10-08]
hardware/Frame-5in/step/coupon_arm.step
30.0 x 16.0 x 12.0 mm
