benwys/SparrowHawk/hardware/Frame-5in/step/gps_mast.step

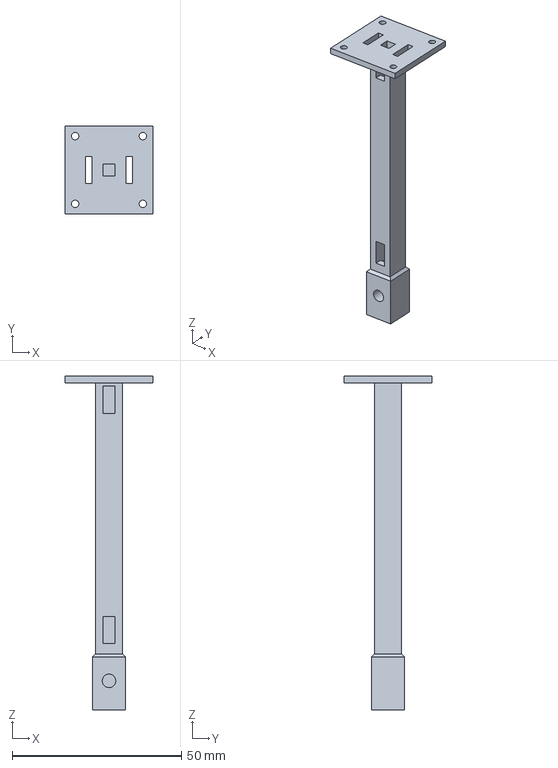
[picture p24: CAD file, 2026-10-08]
hardware/Frame-5in/step/gps_mast.step
26.0 x 26.0 x 98.6 mm
