benwys/SparrowHawk/hardware/Frame-5in/step/nose_fpv.step

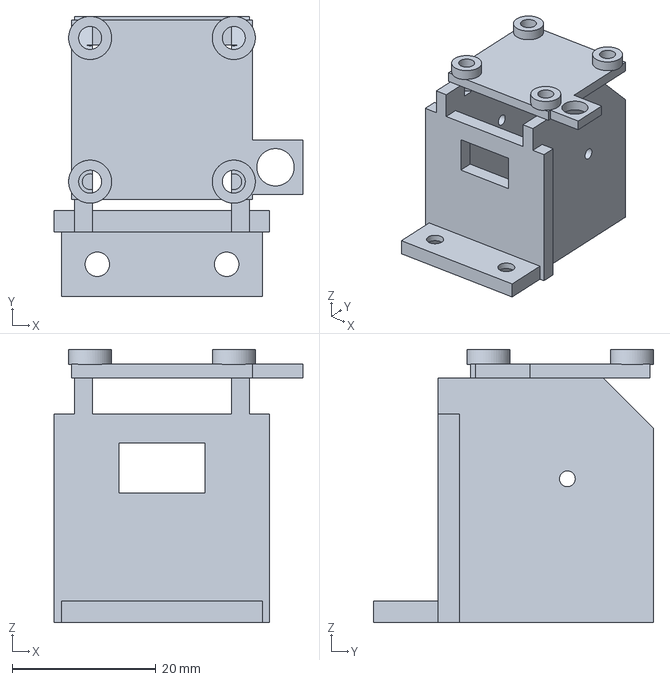
[picture p25: CAD file, 2026-10-08]
hardware/Frame-5in/step/nose_fpv.step
34.6 x 39.0 x 38.0 mm
