benwys/SparrowHawk/hardware/Frame-5in/step/arm.step

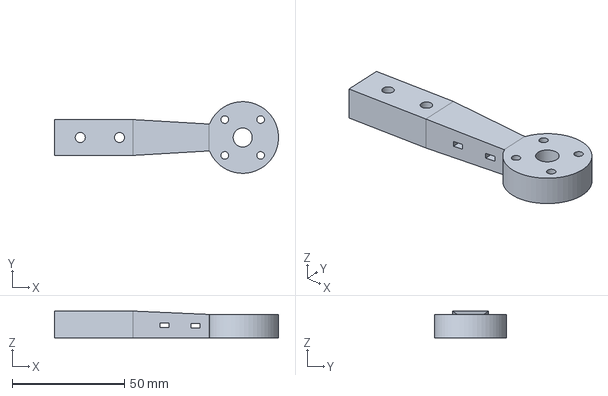
[picture p26: CAD file, 2026-10-08]
hardware/Frame-5in/step/arm.step
100.0 x 32.0 x 12.0 mm
