benwys/SparrowHawk/hardware/Frame-5in/step/coupon_stack.step

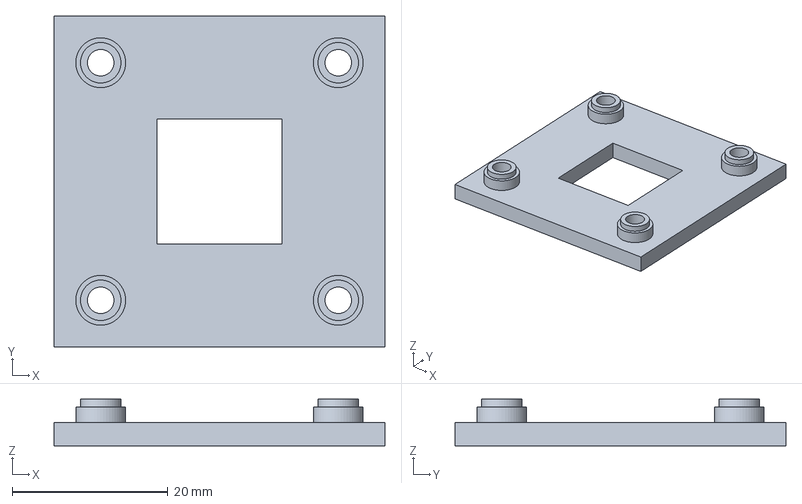
[picture p27: CAD file, 2026-10-08]
hardware/Frame-5in/step/coupon_stack.step
42.5 x 42.5 x 6.00 mm
