benwys/SparrowHawk/hardware/Frame-5in/step/coupon_socket.step

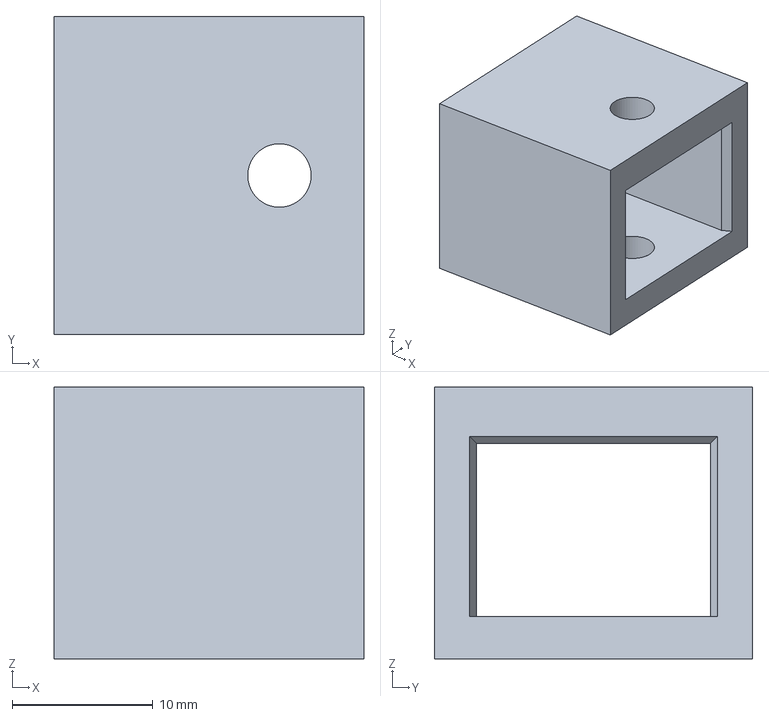
[picture p28: CAD file, 2026-10-08]
hardware/Frame-5in/step/coupon_socket.step
22.0 x 22.6 x 19.3 mm
