benwys/SparrowHawk/hardware/Frame-5in/step/ts_axle_block.step

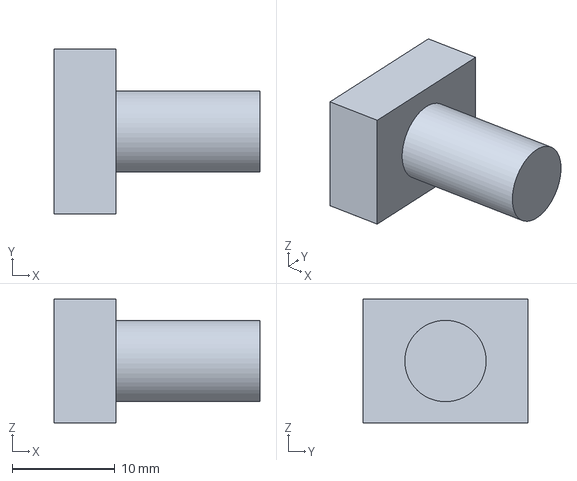
[picture p29: CAD file, 2026-10-08]
hardware/Frame-5in/step/ts_axle_block.step
20.0 x 16.0 x 12.0 mm
