benwys/SparrowHawk/hardware/Frame-5in/step/fc_spacer.step

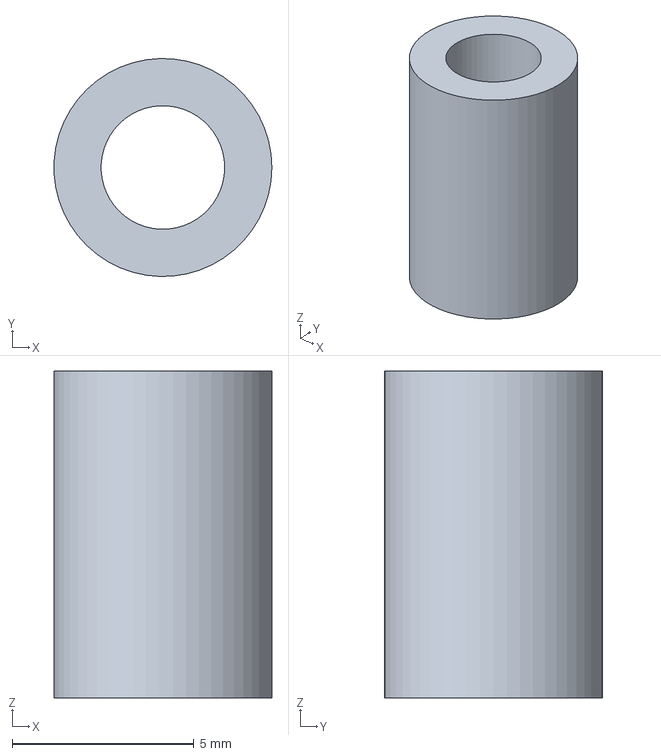
[picture p30: CAD file, 2026-10-08]
hardware/Frame-5in/step/fc_spacer.step
5.99 x 6.00 x 9.00 mm
