benwys/SparrowHawk/hardware/Frame-5in/step/ts_cradle_y.step

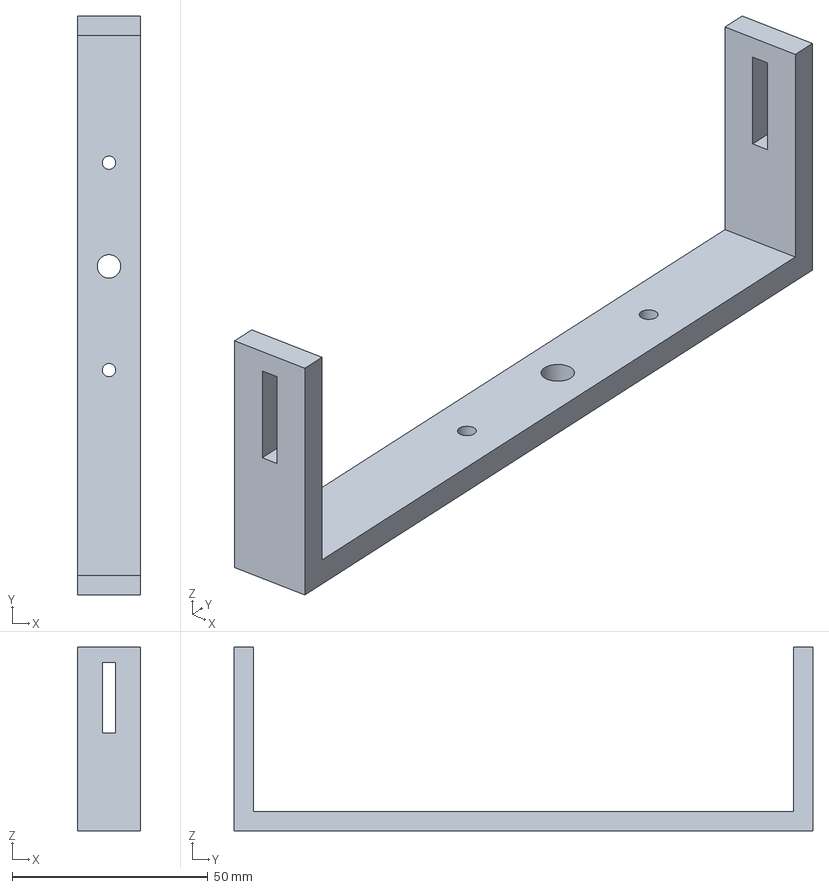
[picture p31: CAD file, 2026-10-08]
hardware/Frame-5in/step/ts_cradle_y.step
16.0 x 148.0 x 47.0 mm
