benwys/SparrowHawk/hardware/Frame-5in/step/tail.step

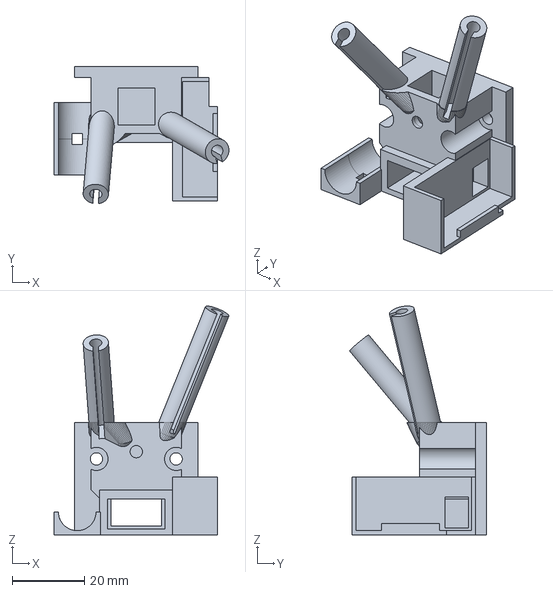
[picture p32: CAD file, 2026-10-08]
hardware/Frame-5in/step/tail.step
48.3 x 37.9 x 63.2 mm
