benwys/SparrowHawk/(list of files, cad)

Other CAD files:
hardware/Frame-5in/stl/arm.stl
hardware/Frame-5in/stl/battery_tray.stl
hardware/Frame-5in/stl/core.stl
hardware/Frame-5in/stl/coupon_arm.stl
hardware/Frame-5in/stl/coupon_socket.stl
hardware/Frame-5in/stl/coupon_socket_full.stl
hardware/Frame-5in/stl/coupon_stack.stl
hardware/Frame-5in/stl/fc_spacer.stl
hardware/Frame-5in/stl/foot.stl
hardware/Frame-5in/stl/gps_mast.stl
hardware/Frame-5in/stl/gps_mast_52.stl
hardware/Frame-5in/stl/nose_fpv.stl
hardware/Frame-5in/stl/tail.stl
hardware/Frame-5in/stl/top_plate.stl
hardware/Frame-5in/stl/ts_axle_block.stl
hardware/Frame-5in/stl/ts_cradle_x.stl
hardware/Frame-5in/stl/ts_cradle_y.stl
