benwys/SparrowHawk/hardware/Sparrow-III/Production/Flight_Controller-III-order-20261003-schematic.pdf

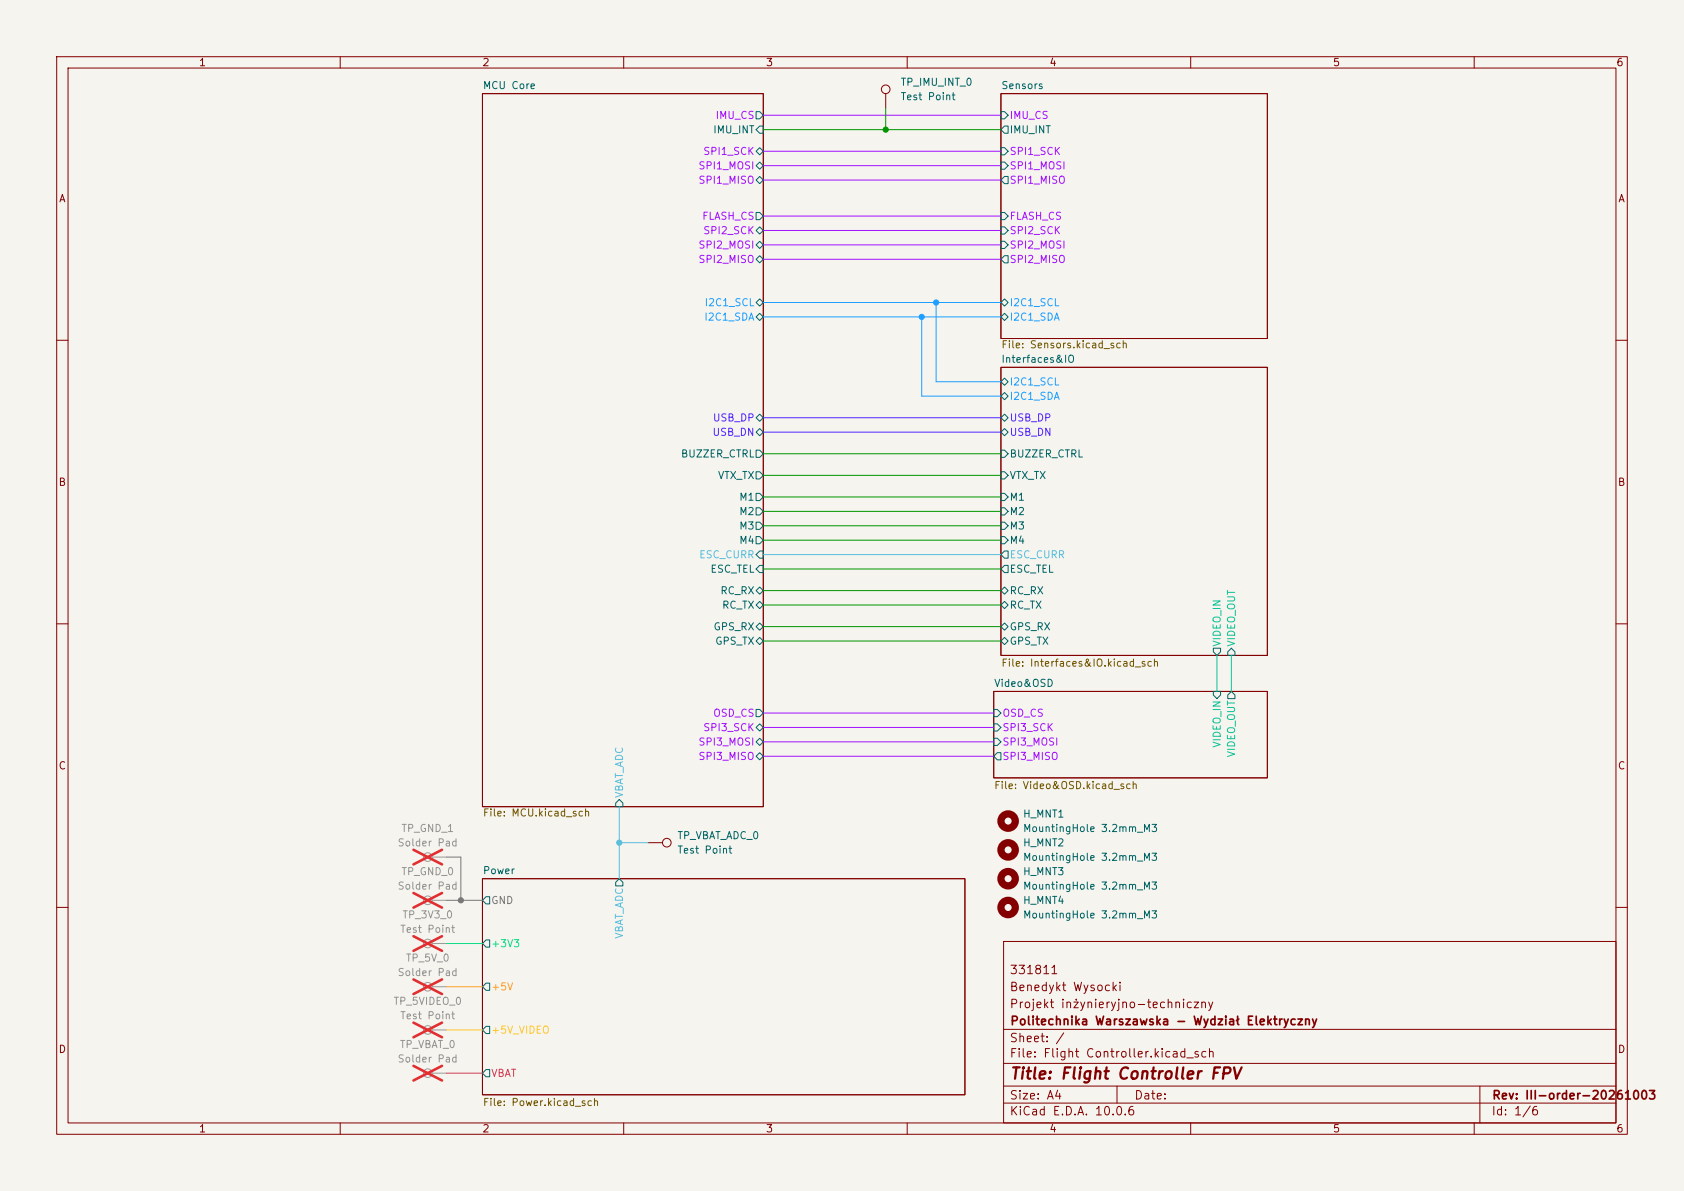
[picture p33: page 1]

File: Video&OSD.kicad_sch VBAT_ADC GND +3V3 +5V +5V_VIDEO

MountingHole 3.2mm_M3 H_MNT1 MountingHole 3.2mm_M3 H_MNT3 MountingHole 3.2mm_M3 H_MNT2 MountingHole 3.2mm_M3

Benedykt Wysocki
Projekt inżynieryjno-techniczny
Politechnika Warszawska - Wydział Elektryczny
Sheet: /
File: Flight Controller.kicad_sch
Title: Flight Controller FPV
KiCad E.D.A. 10.0.6

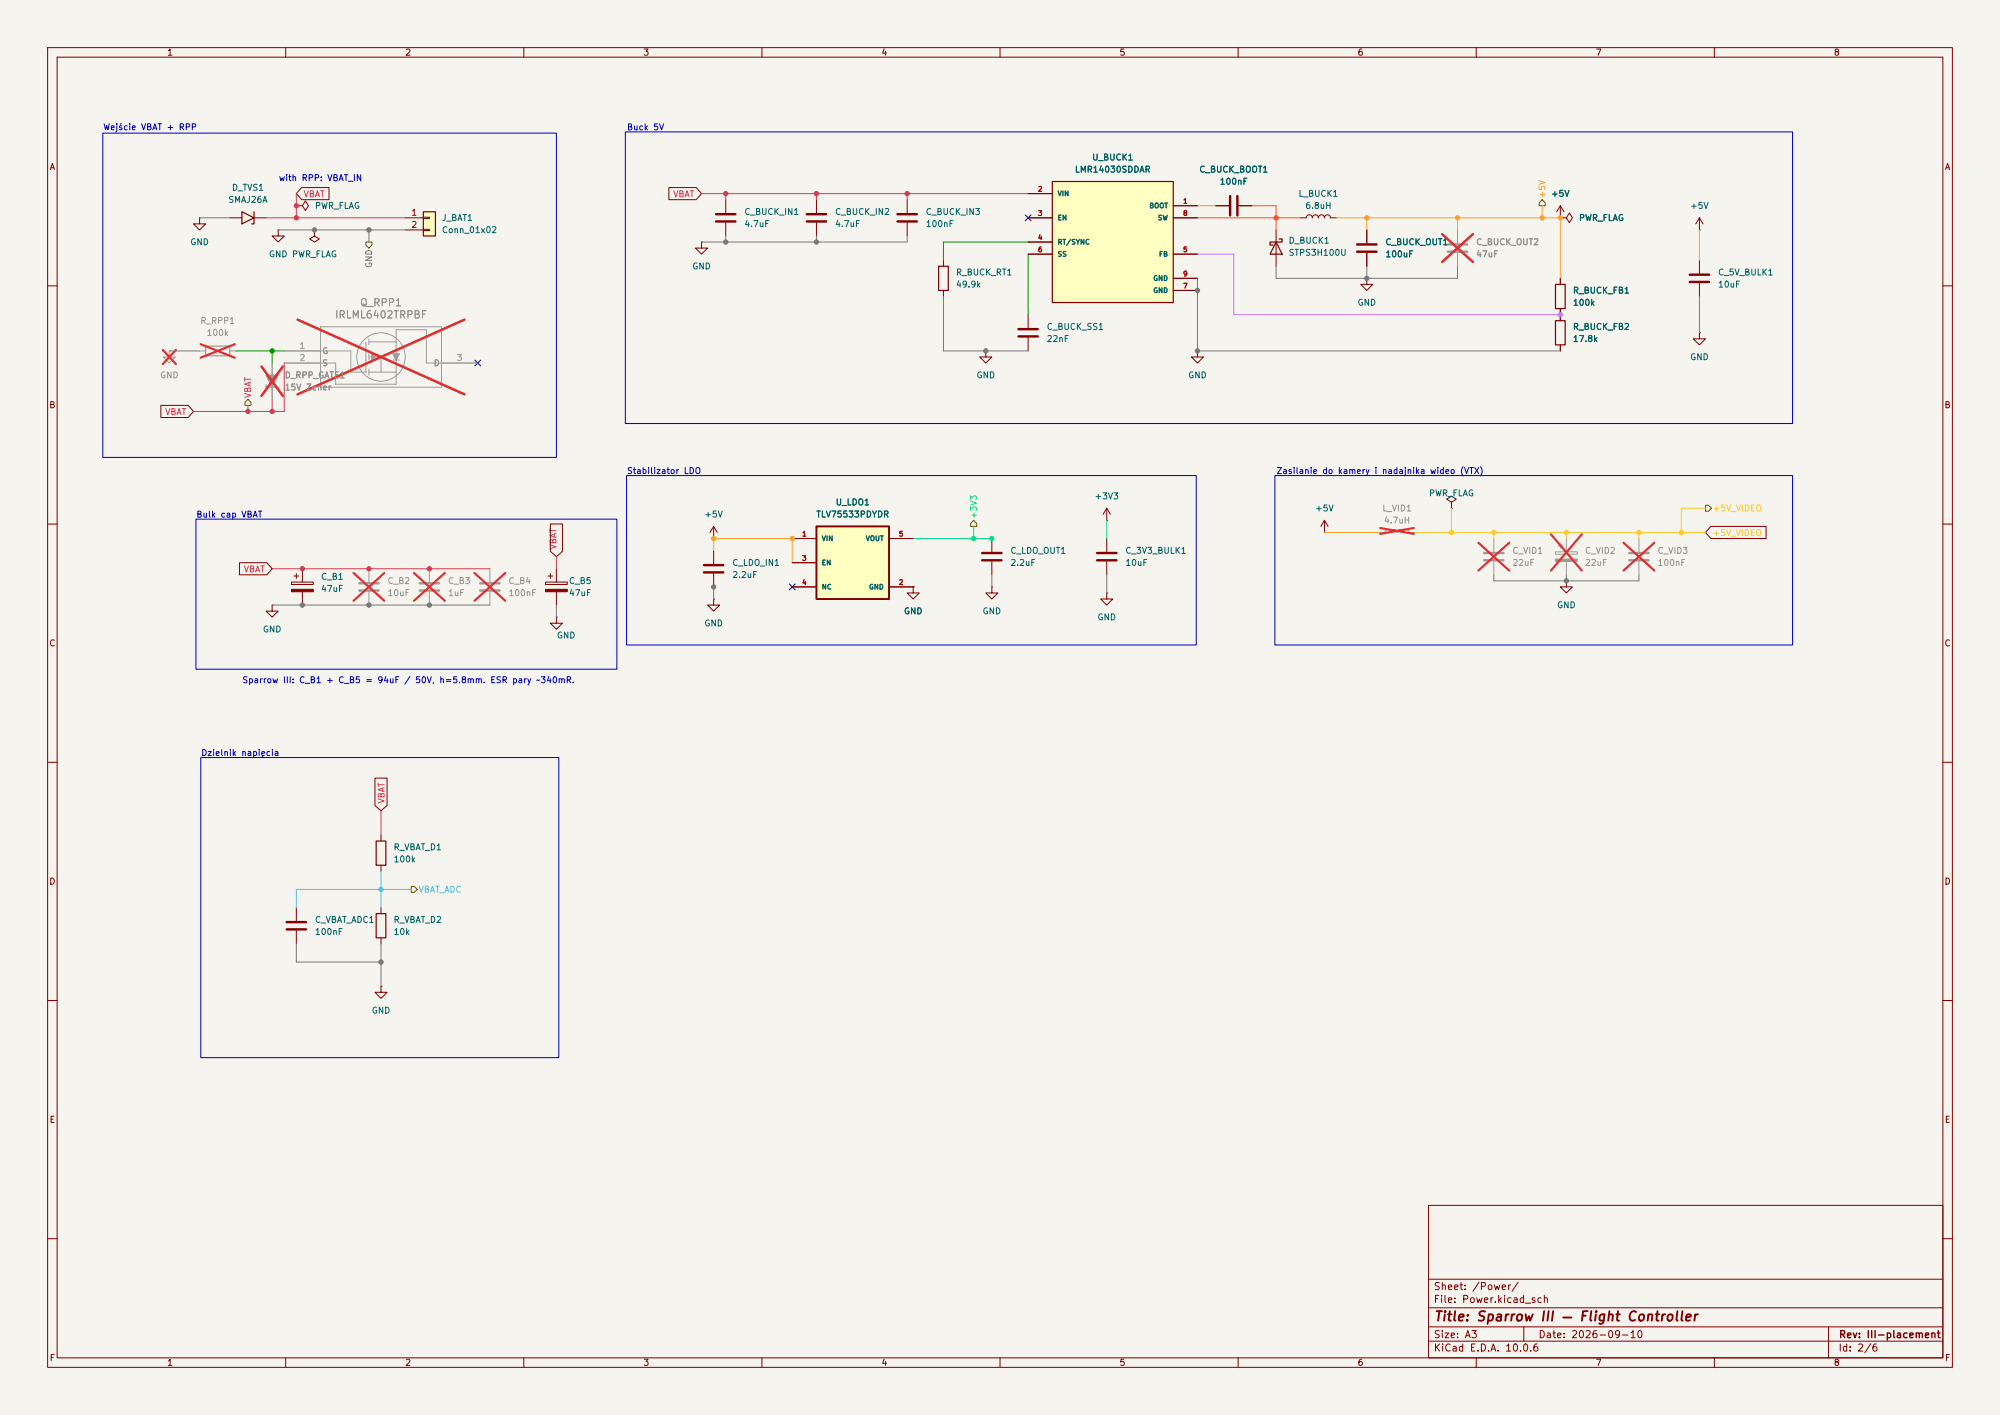
[picture p34: page 2]

Buck 5V Bulk cap VBAT Wejście VBAT + RPP

Zasilanie do kamery i nadajnika wideo (VTX) Dzielnik napięcia

Sparrow III: C_B1 + C_B5 = 94uF / 50V, h=5.8mm. ESR pary ~340mR.

Sheet: /Power/
File: Power.kicad_sch
Title: Sparrow III — Flight Controller

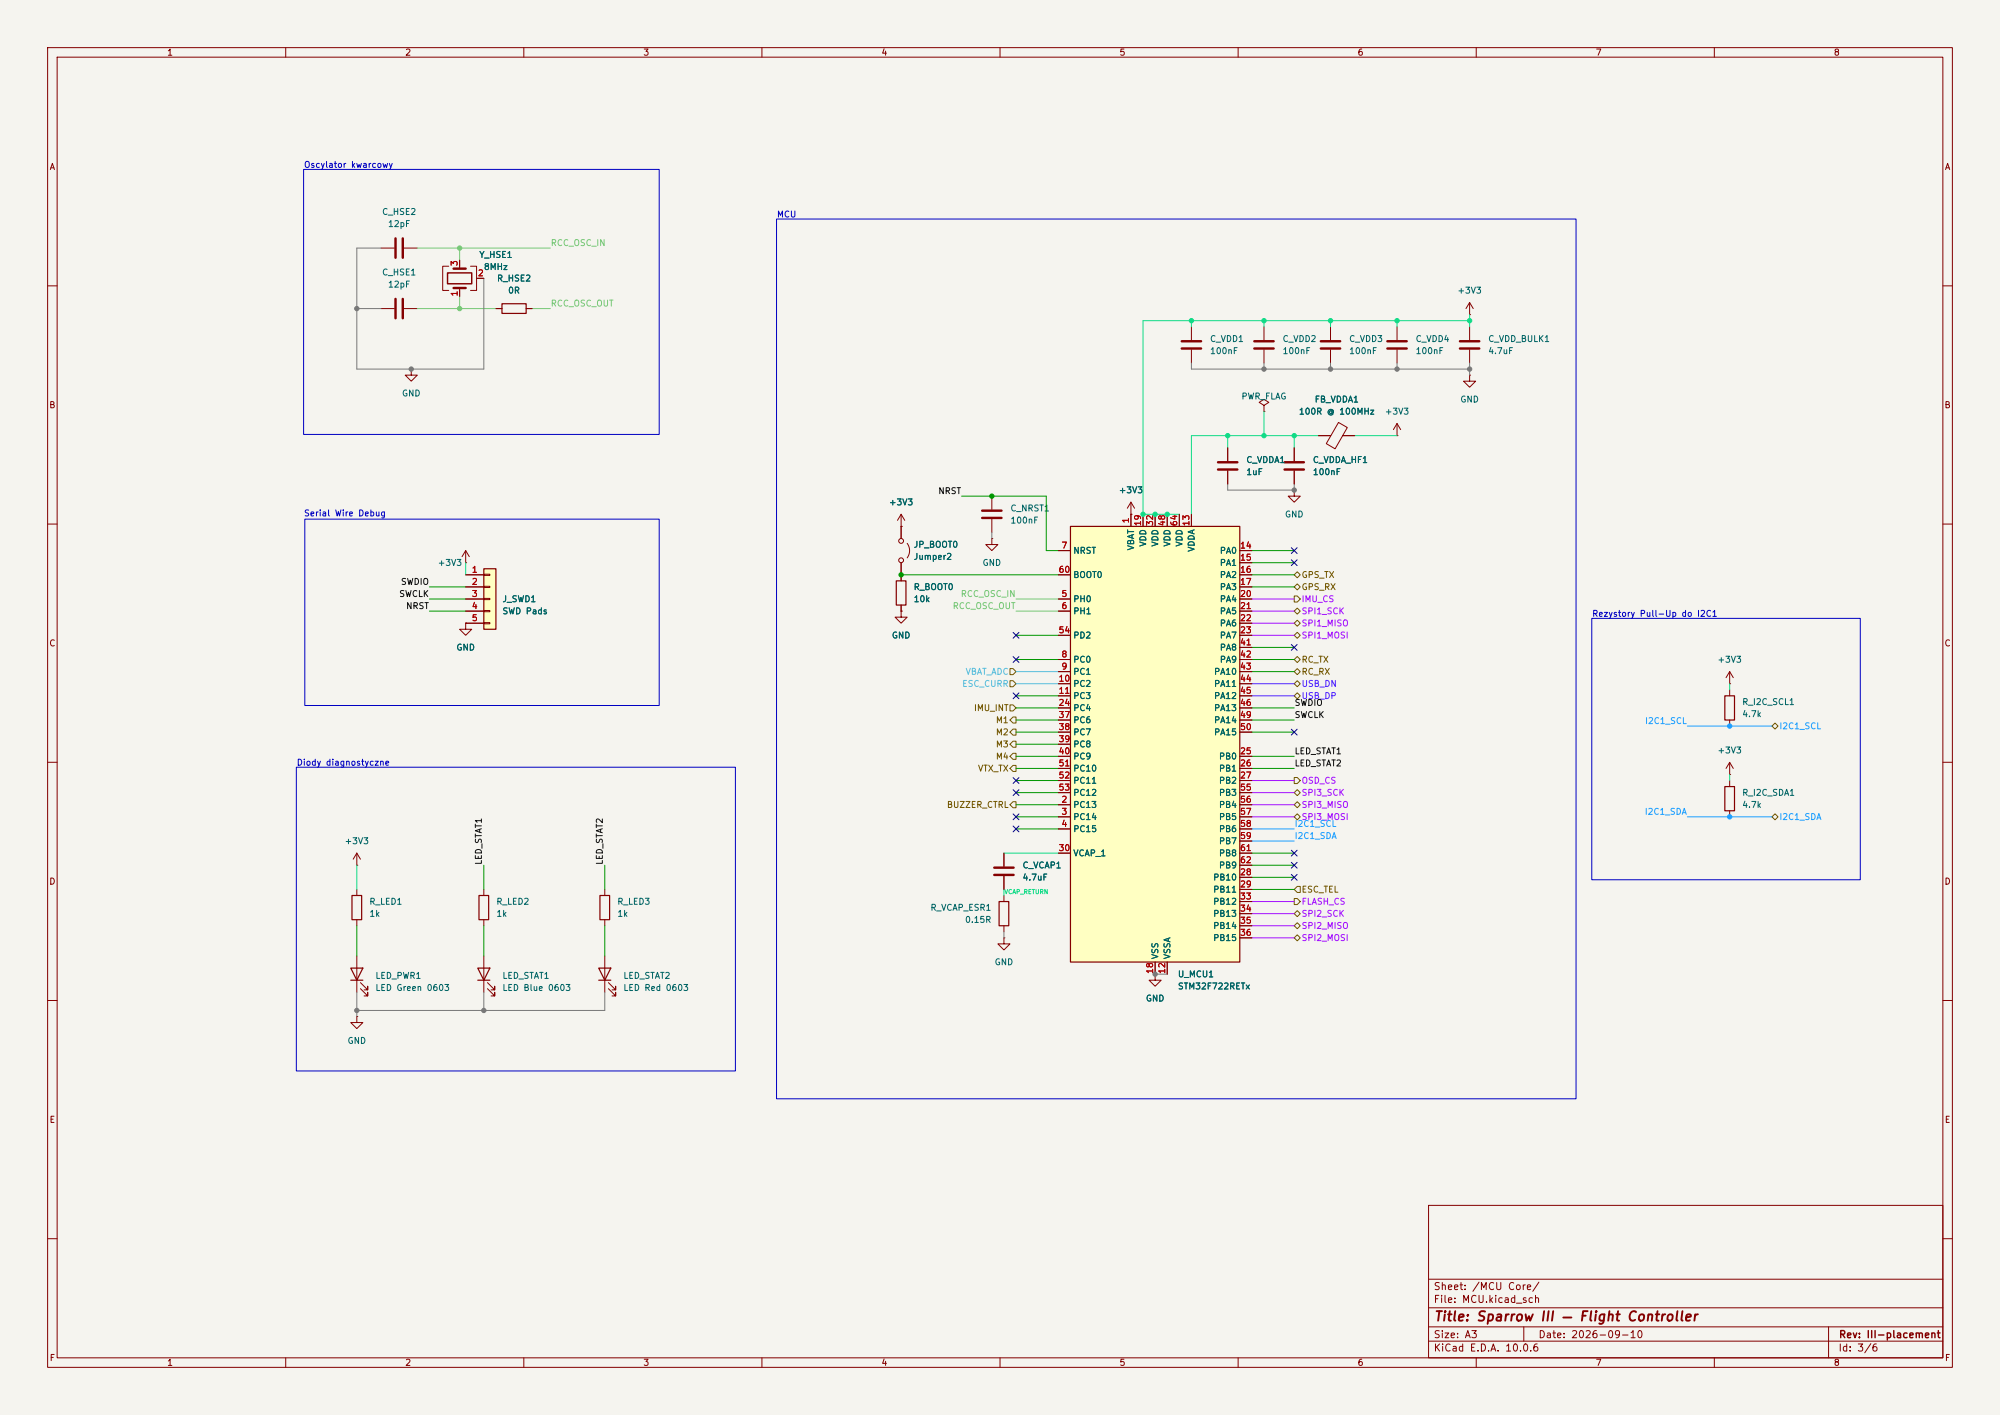
[picture p35: page 3]

Oscylator kwarcowy Serial Wire Debug

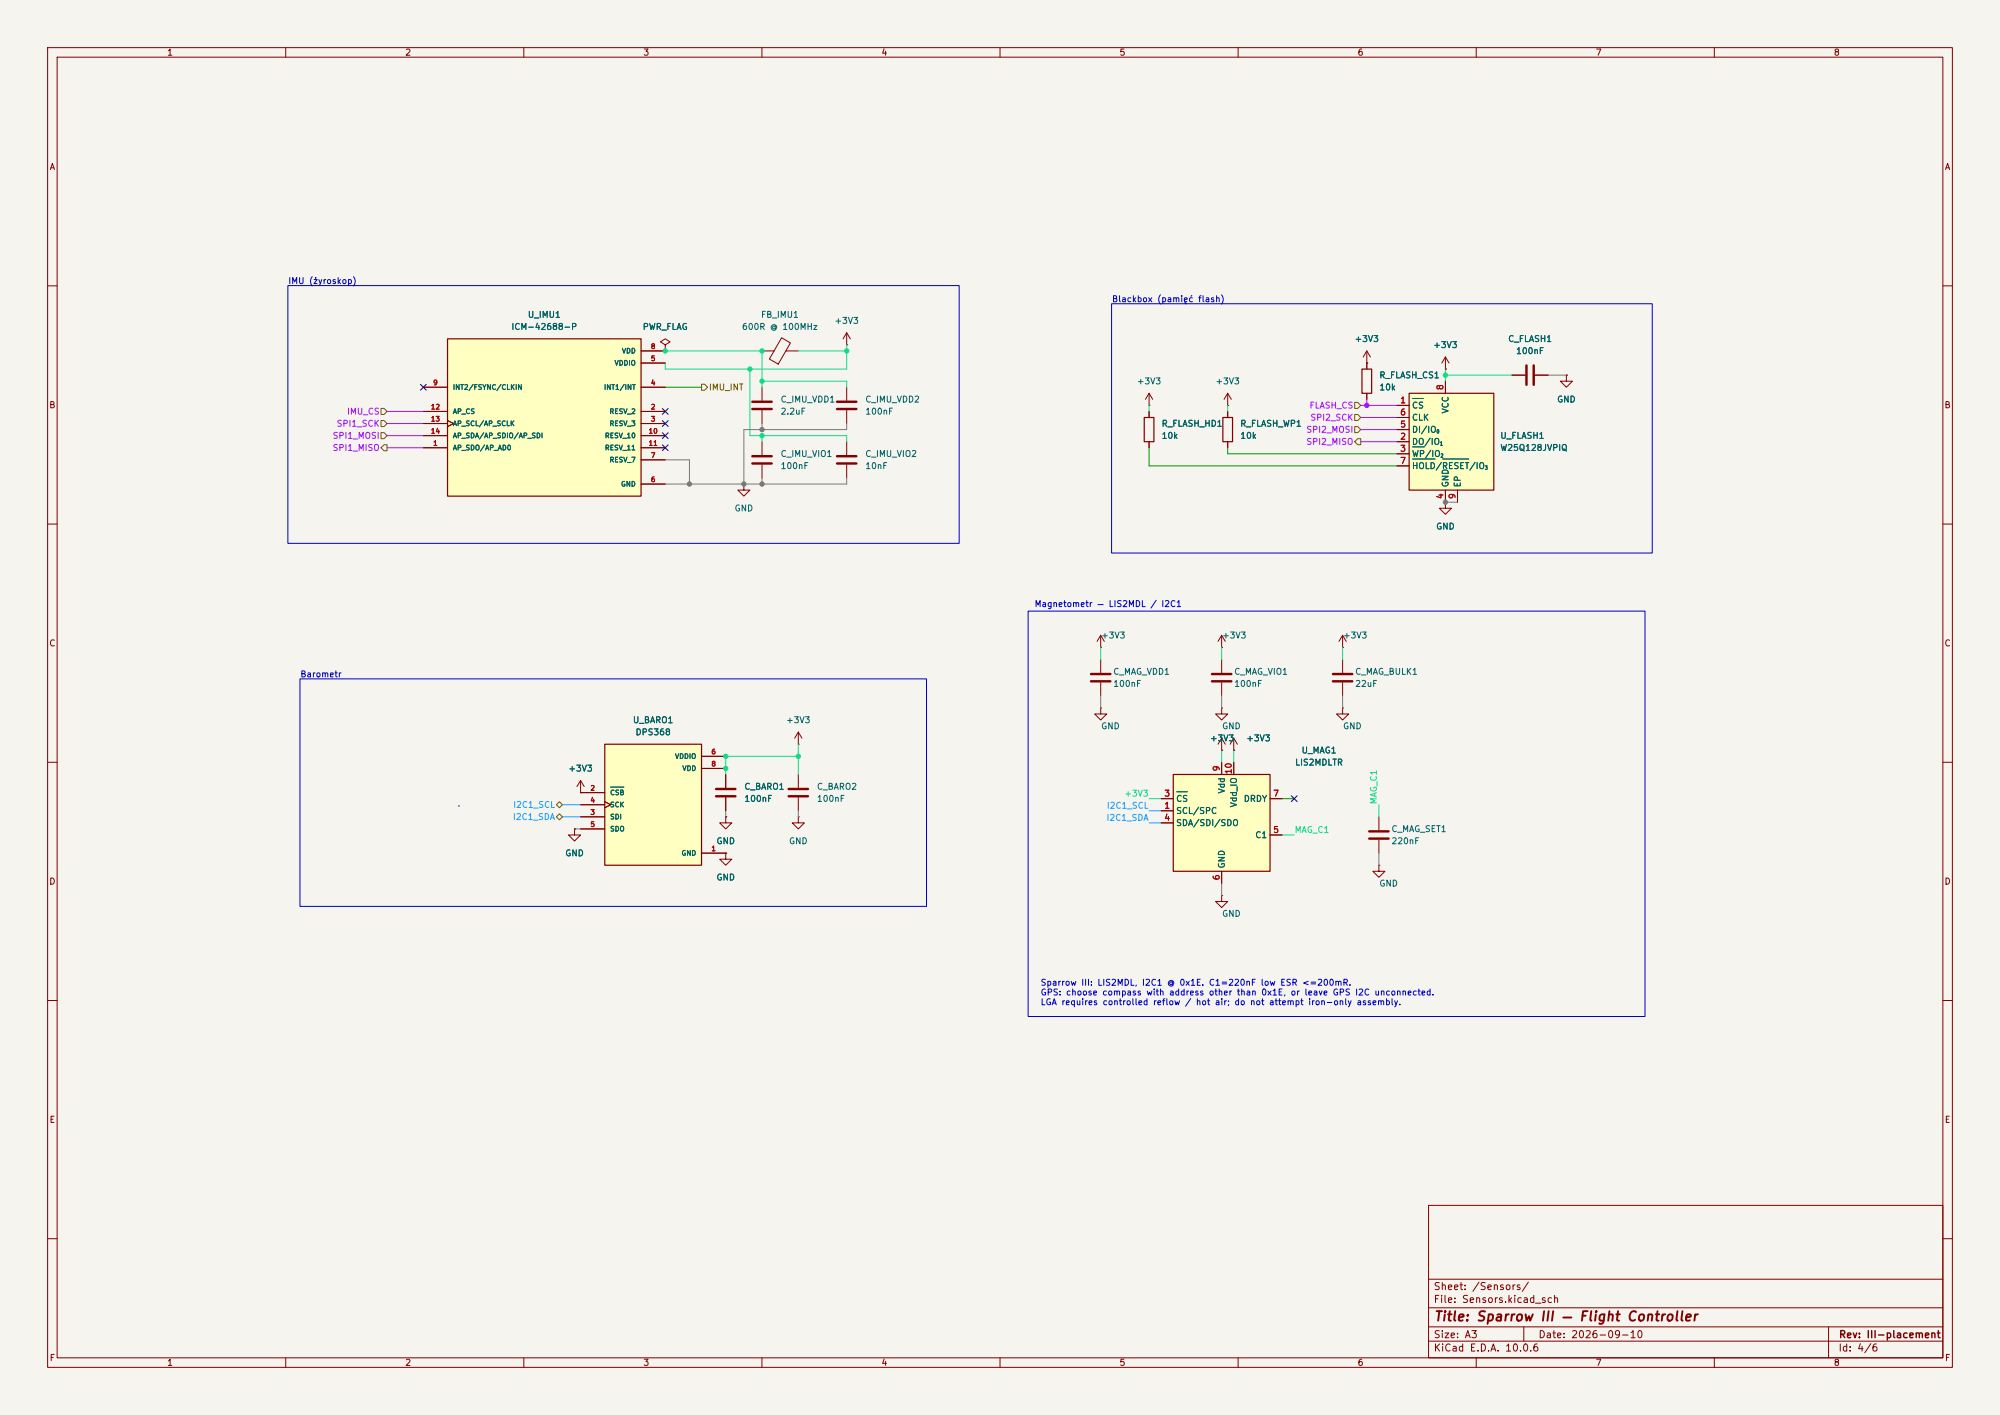
[picture p36: page 4]

4 DI/IO0 5 CLK 6 HOLD/RESET/IO3 7 VCC

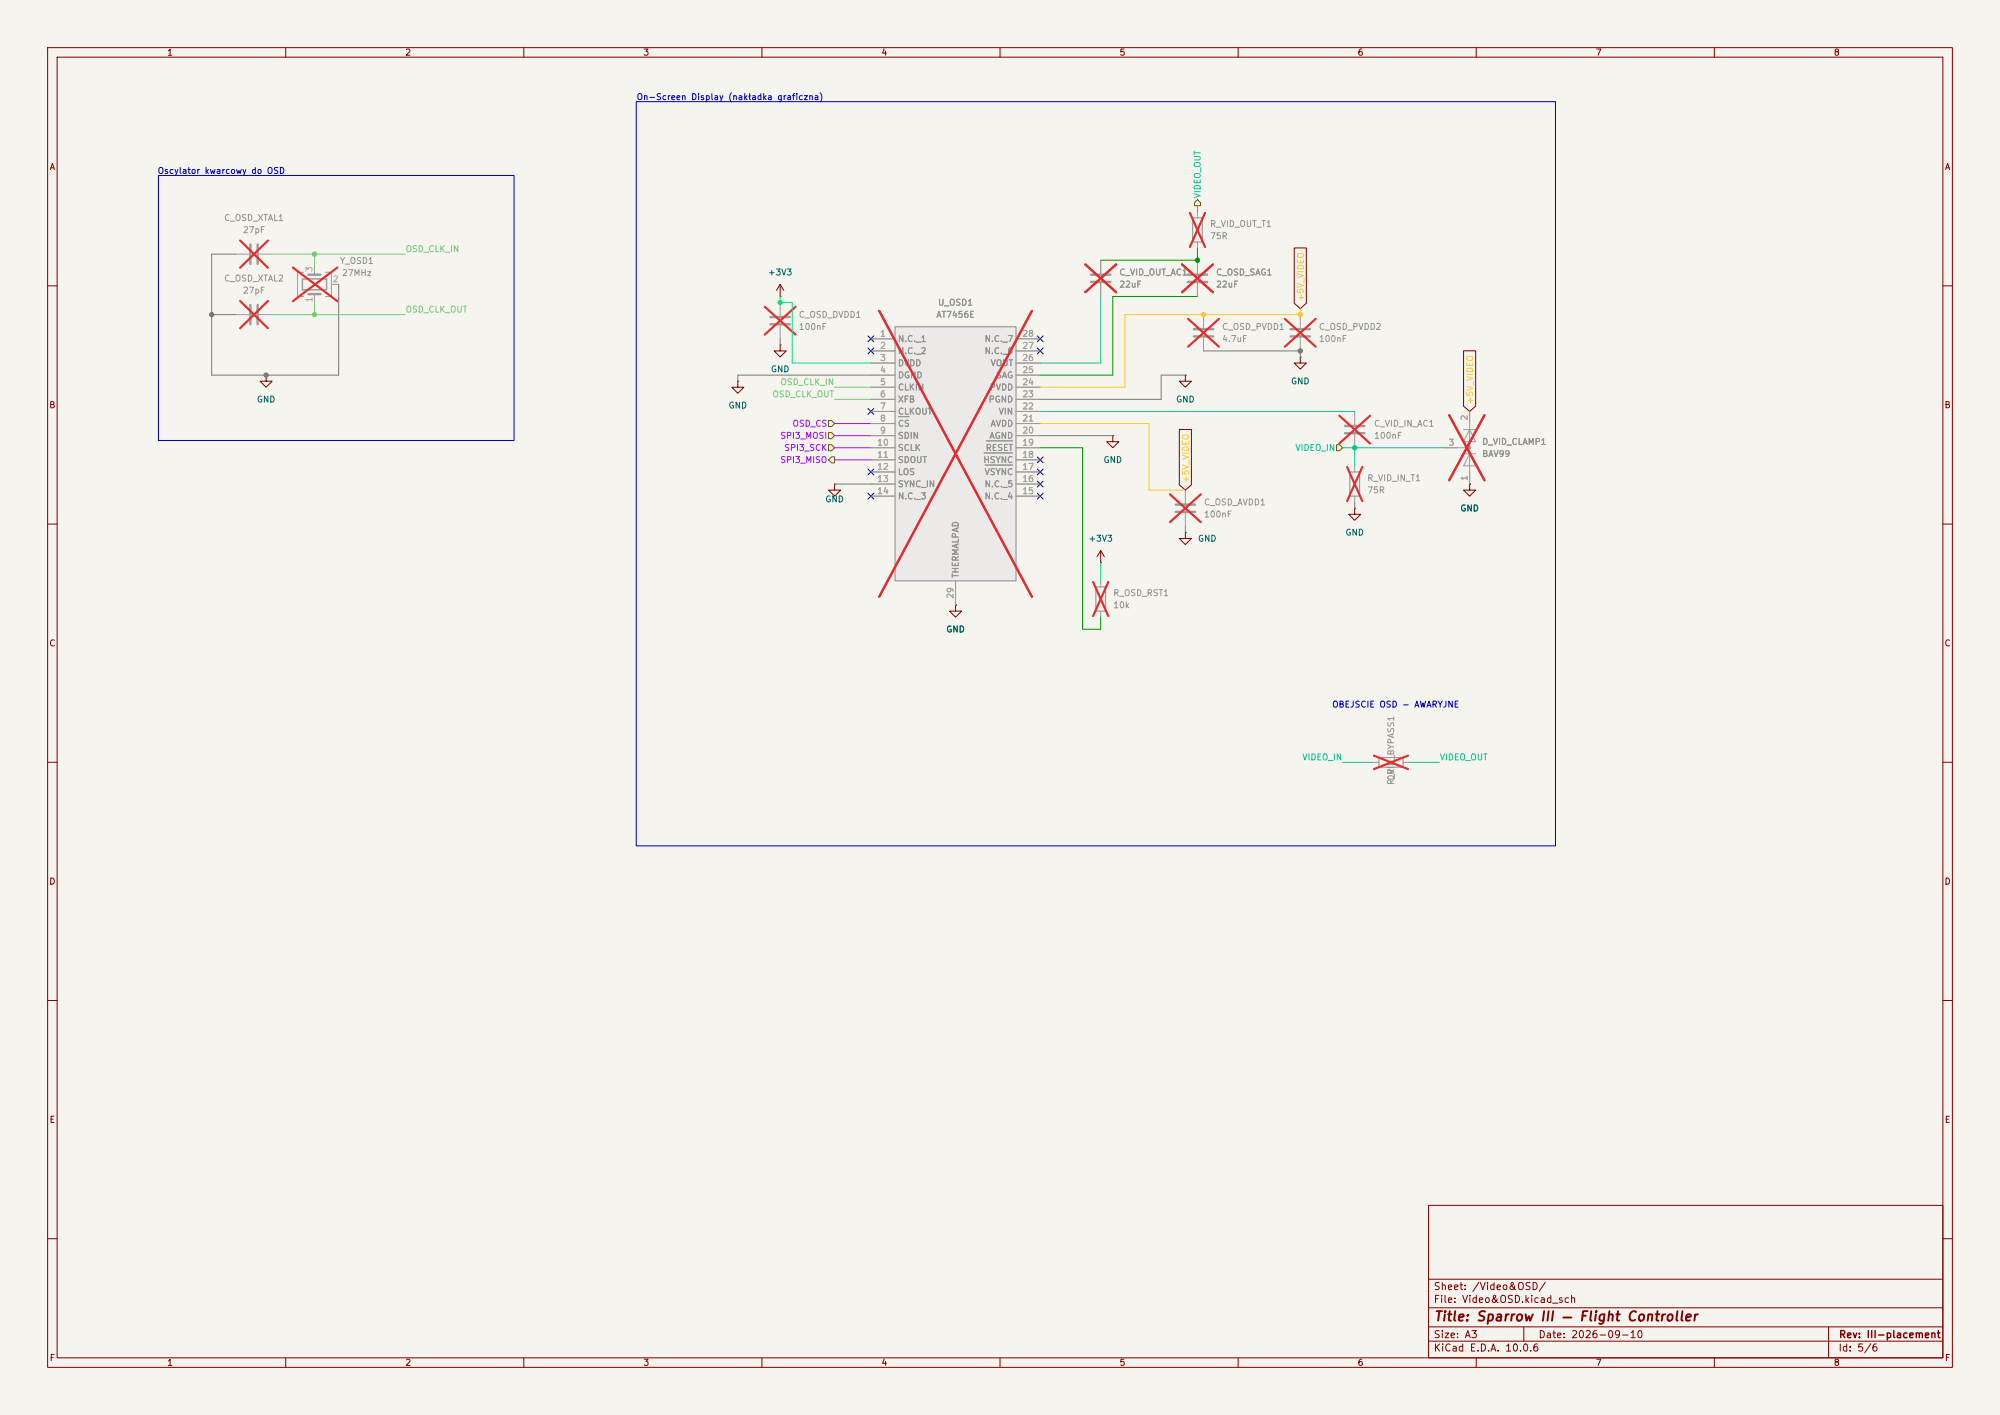
[picture p37: page 5]

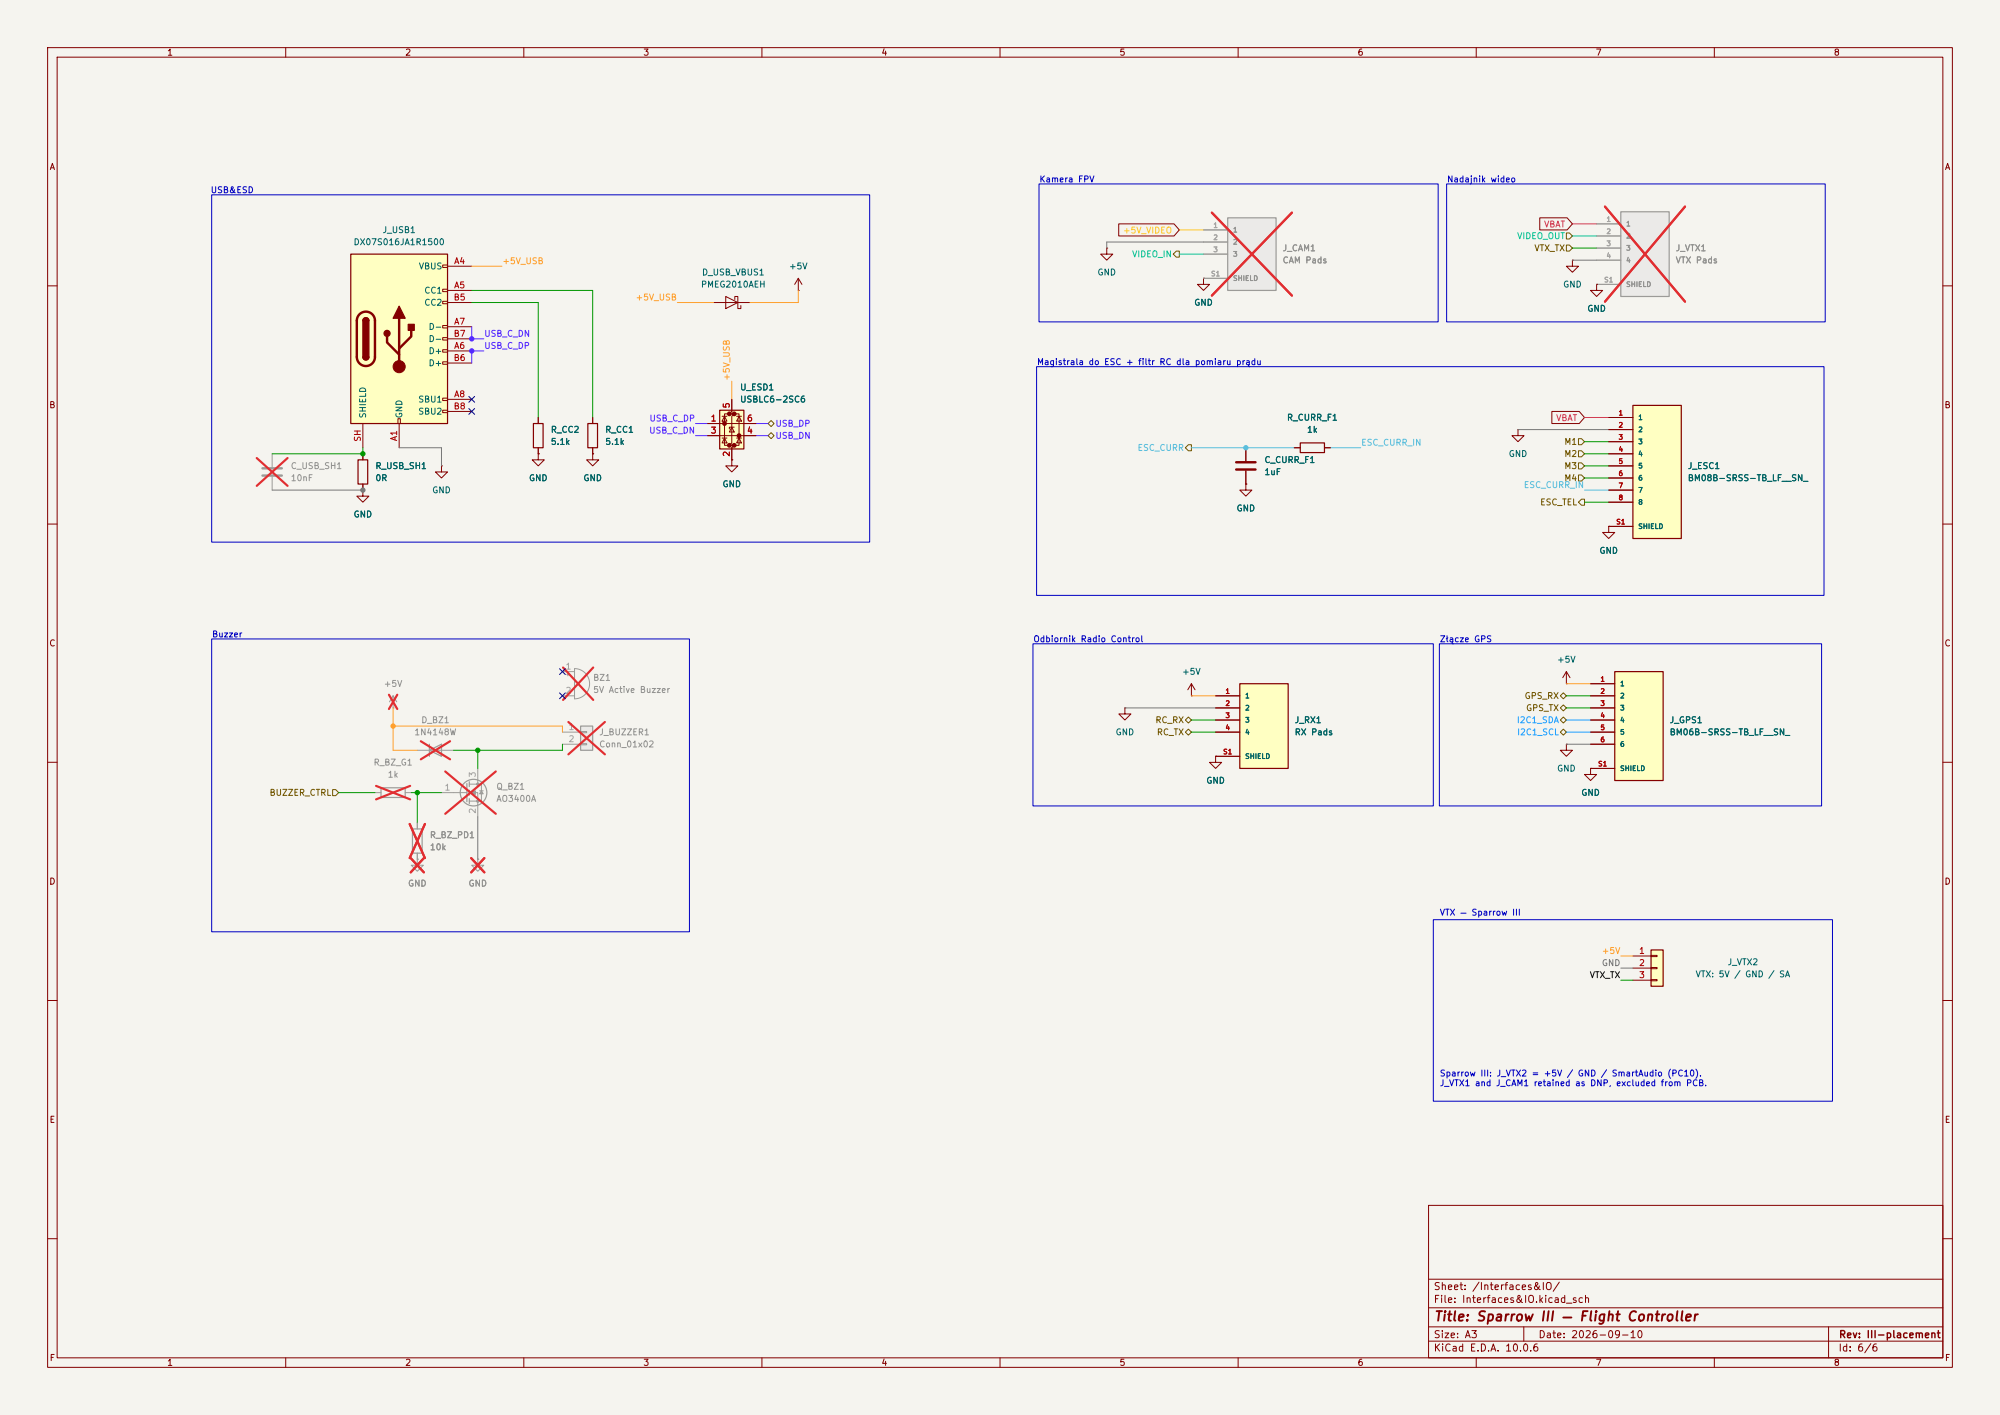
[picture p38: page 6]

Nadajnik wideo Magistrala do ESC + filtr RC dla pomiaru prądu
