benwys/SparrowHawk/hardware/Sparrow-II/Production/Flight Controller-schematic.pdf

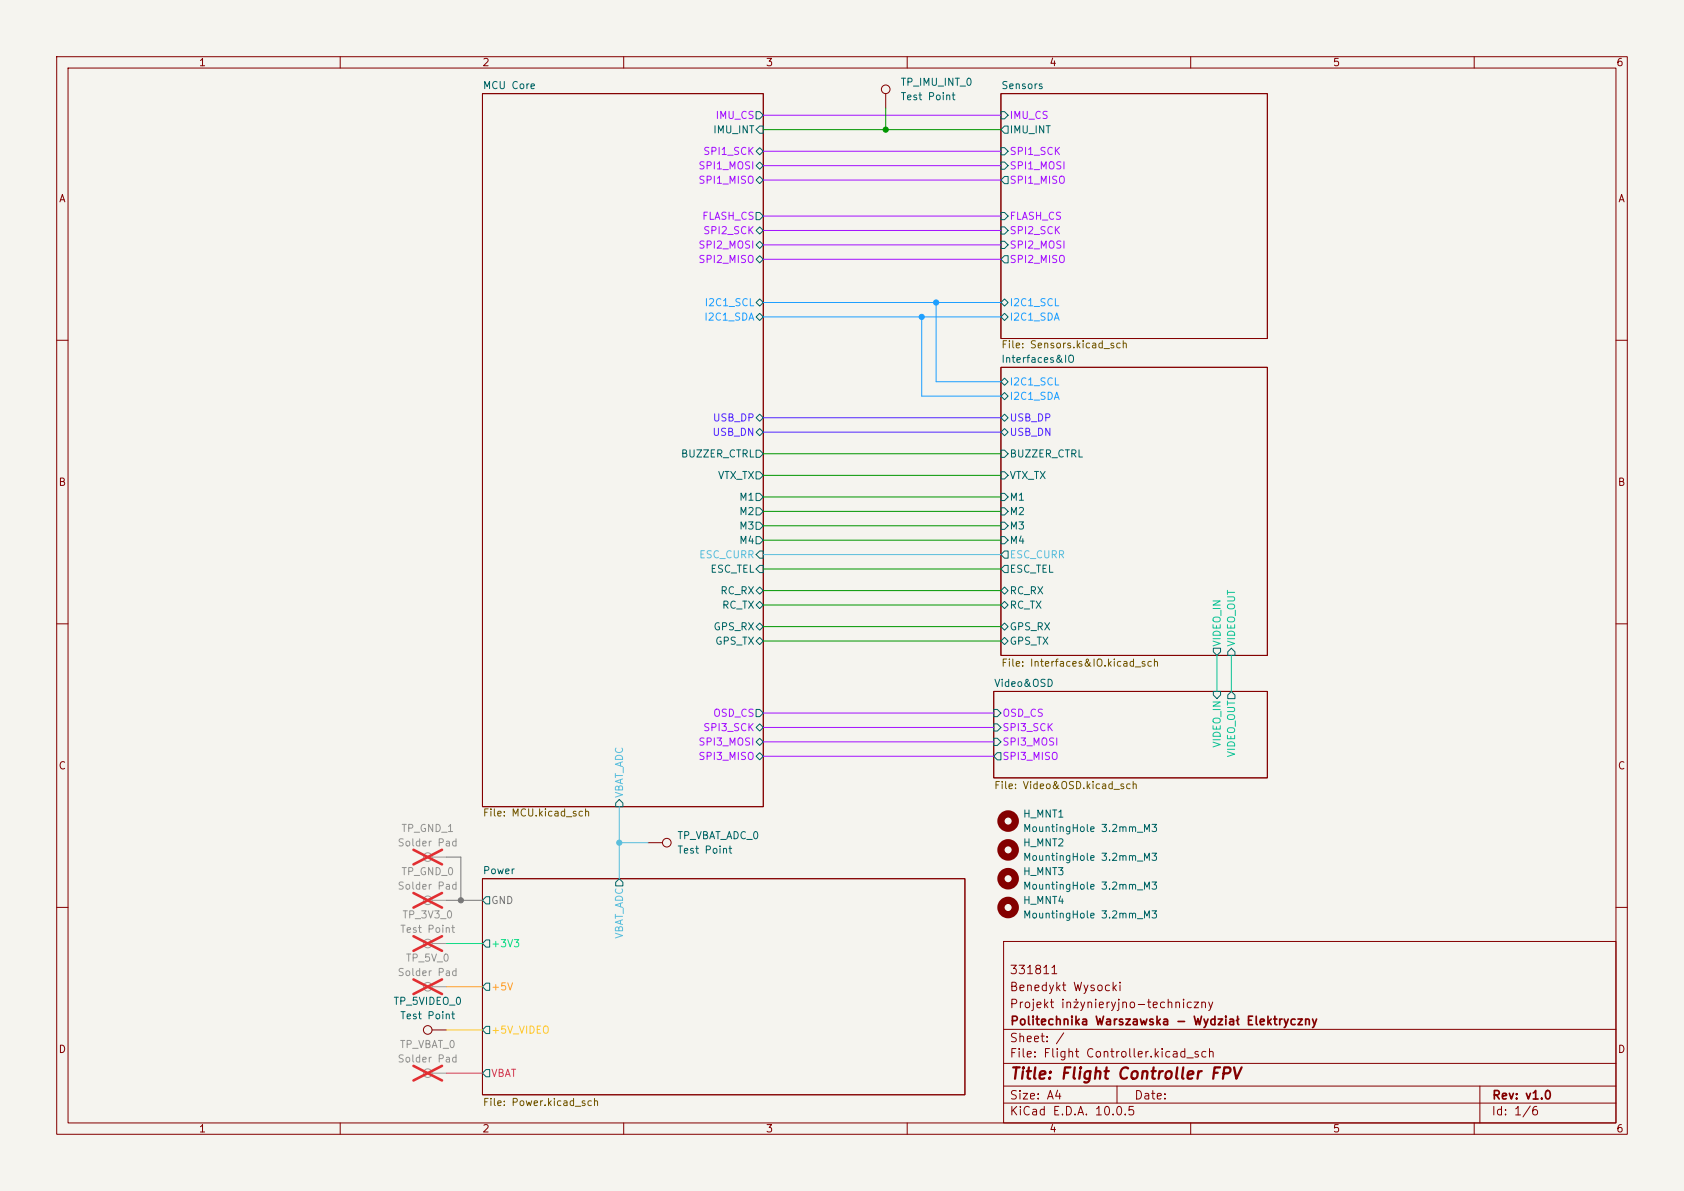
[picture p39: page 1]

File: Video&OSD.kicad_sch VBAT_ADC GND +3V3 +5V +5V_VIDEO

MountingHole 3.2mm_M3 H_MNT1 MountingHole 3.2mm_M3 H_MNT3 MountingHole 3.2mm_M3 H_MNT2 MountingHole 3.2mm_M3

Benedykt Wysocki
Projekt inżynieryjno-techniczny
Politechnika Warszawska - Wydział Elektryczny
Sheet: /
File: Flight Controller.kicad_sch
Title: Flight Controller FPV

Size: A4 | Rev: v1.0
KiCad E.D.A. 10.0.5 | Id: 1/6

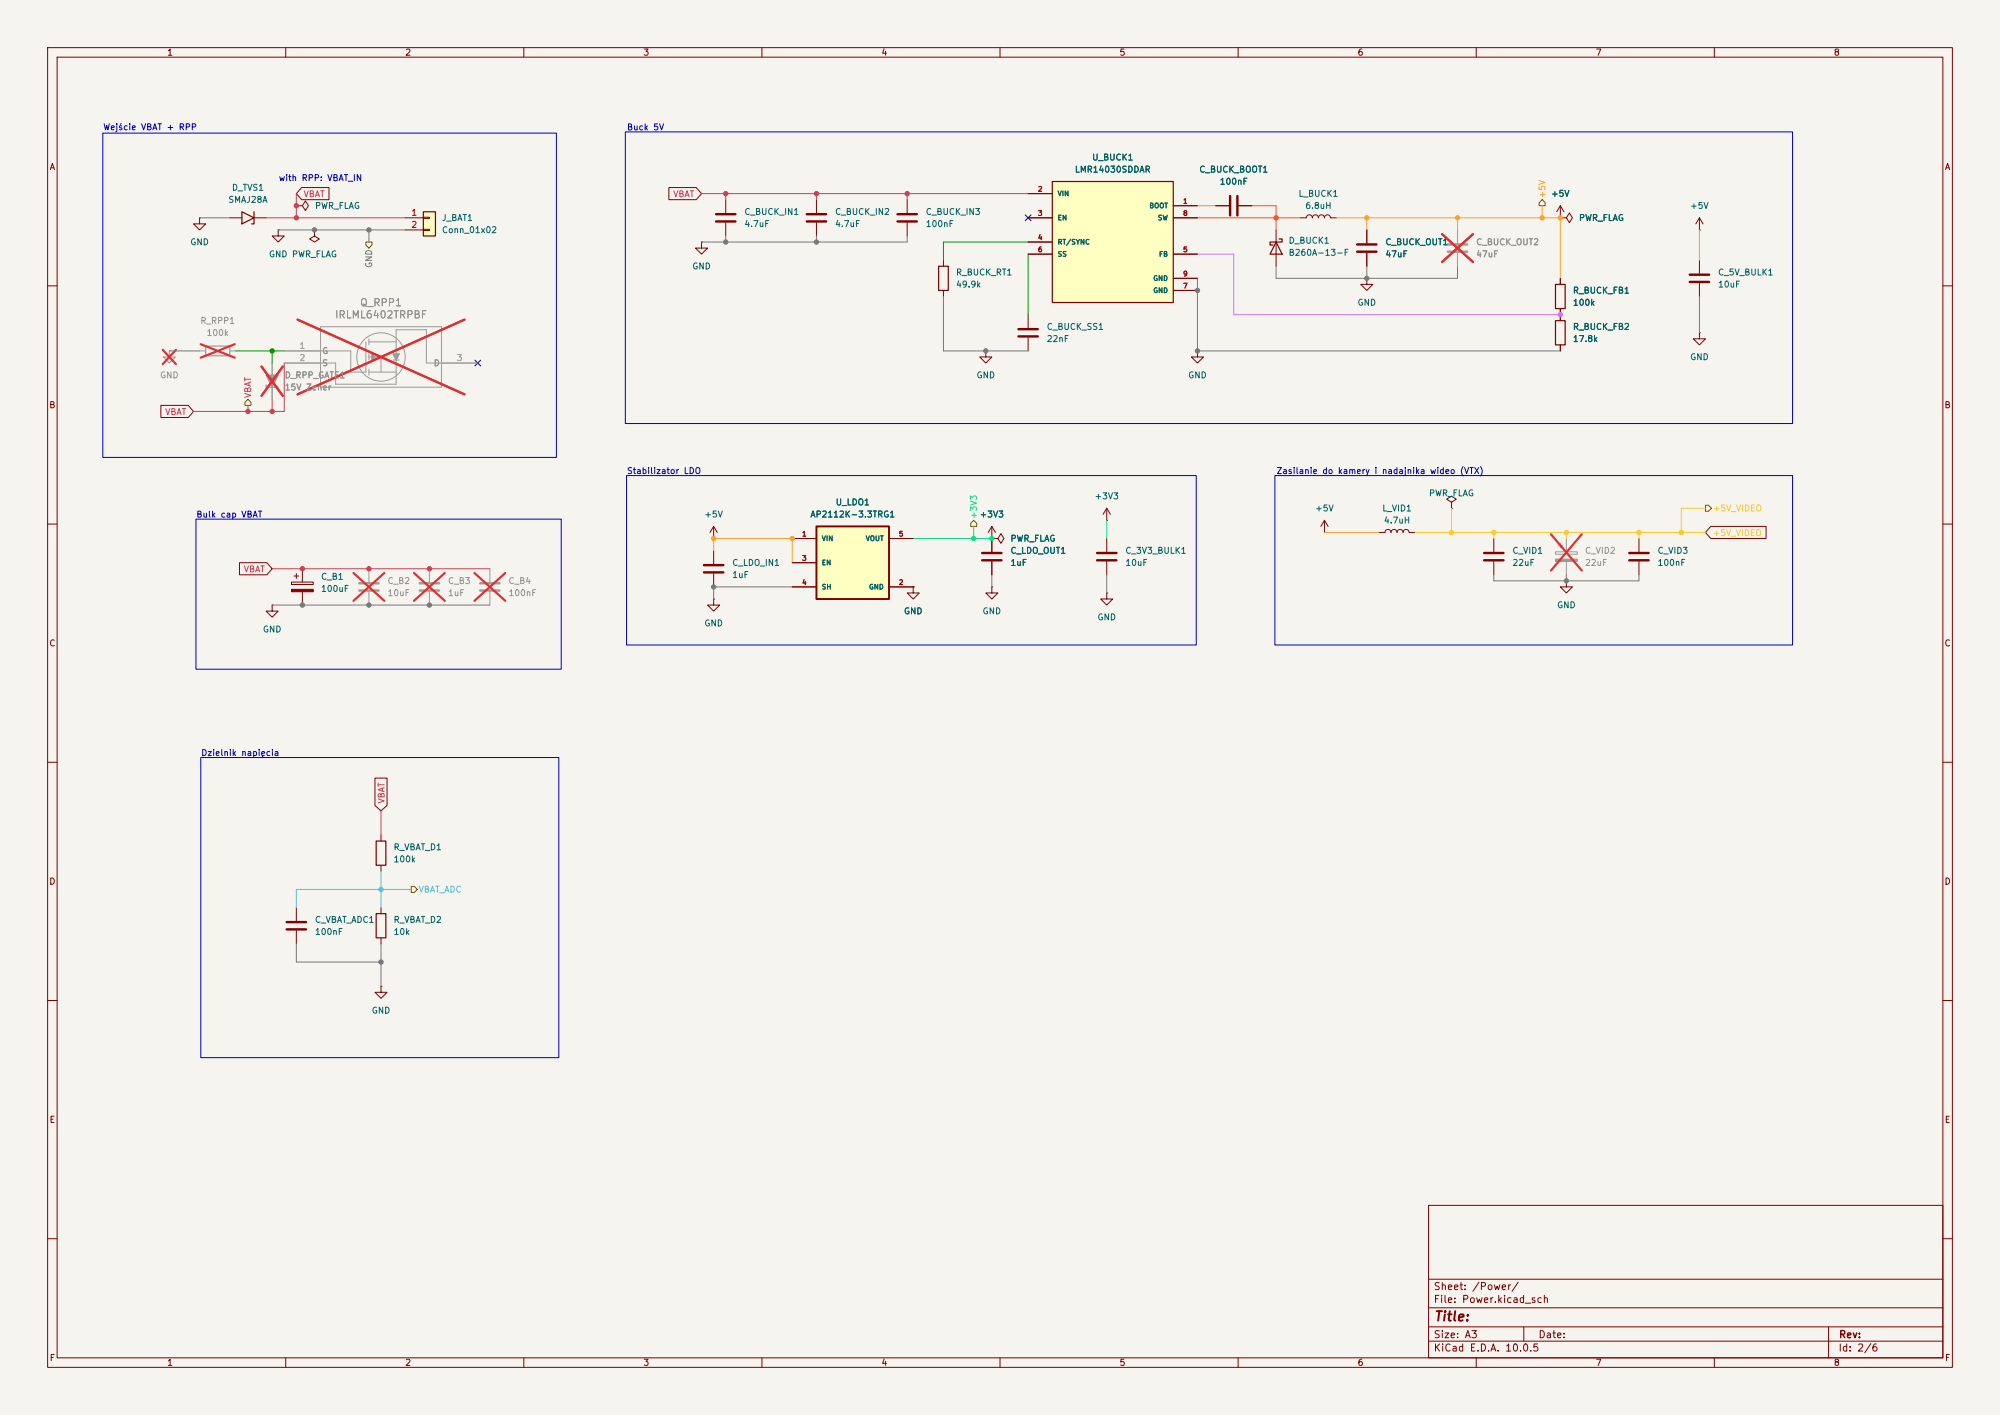
[picture p40: page 2]

Stabilizator LDO Wejście VBAT + RPP

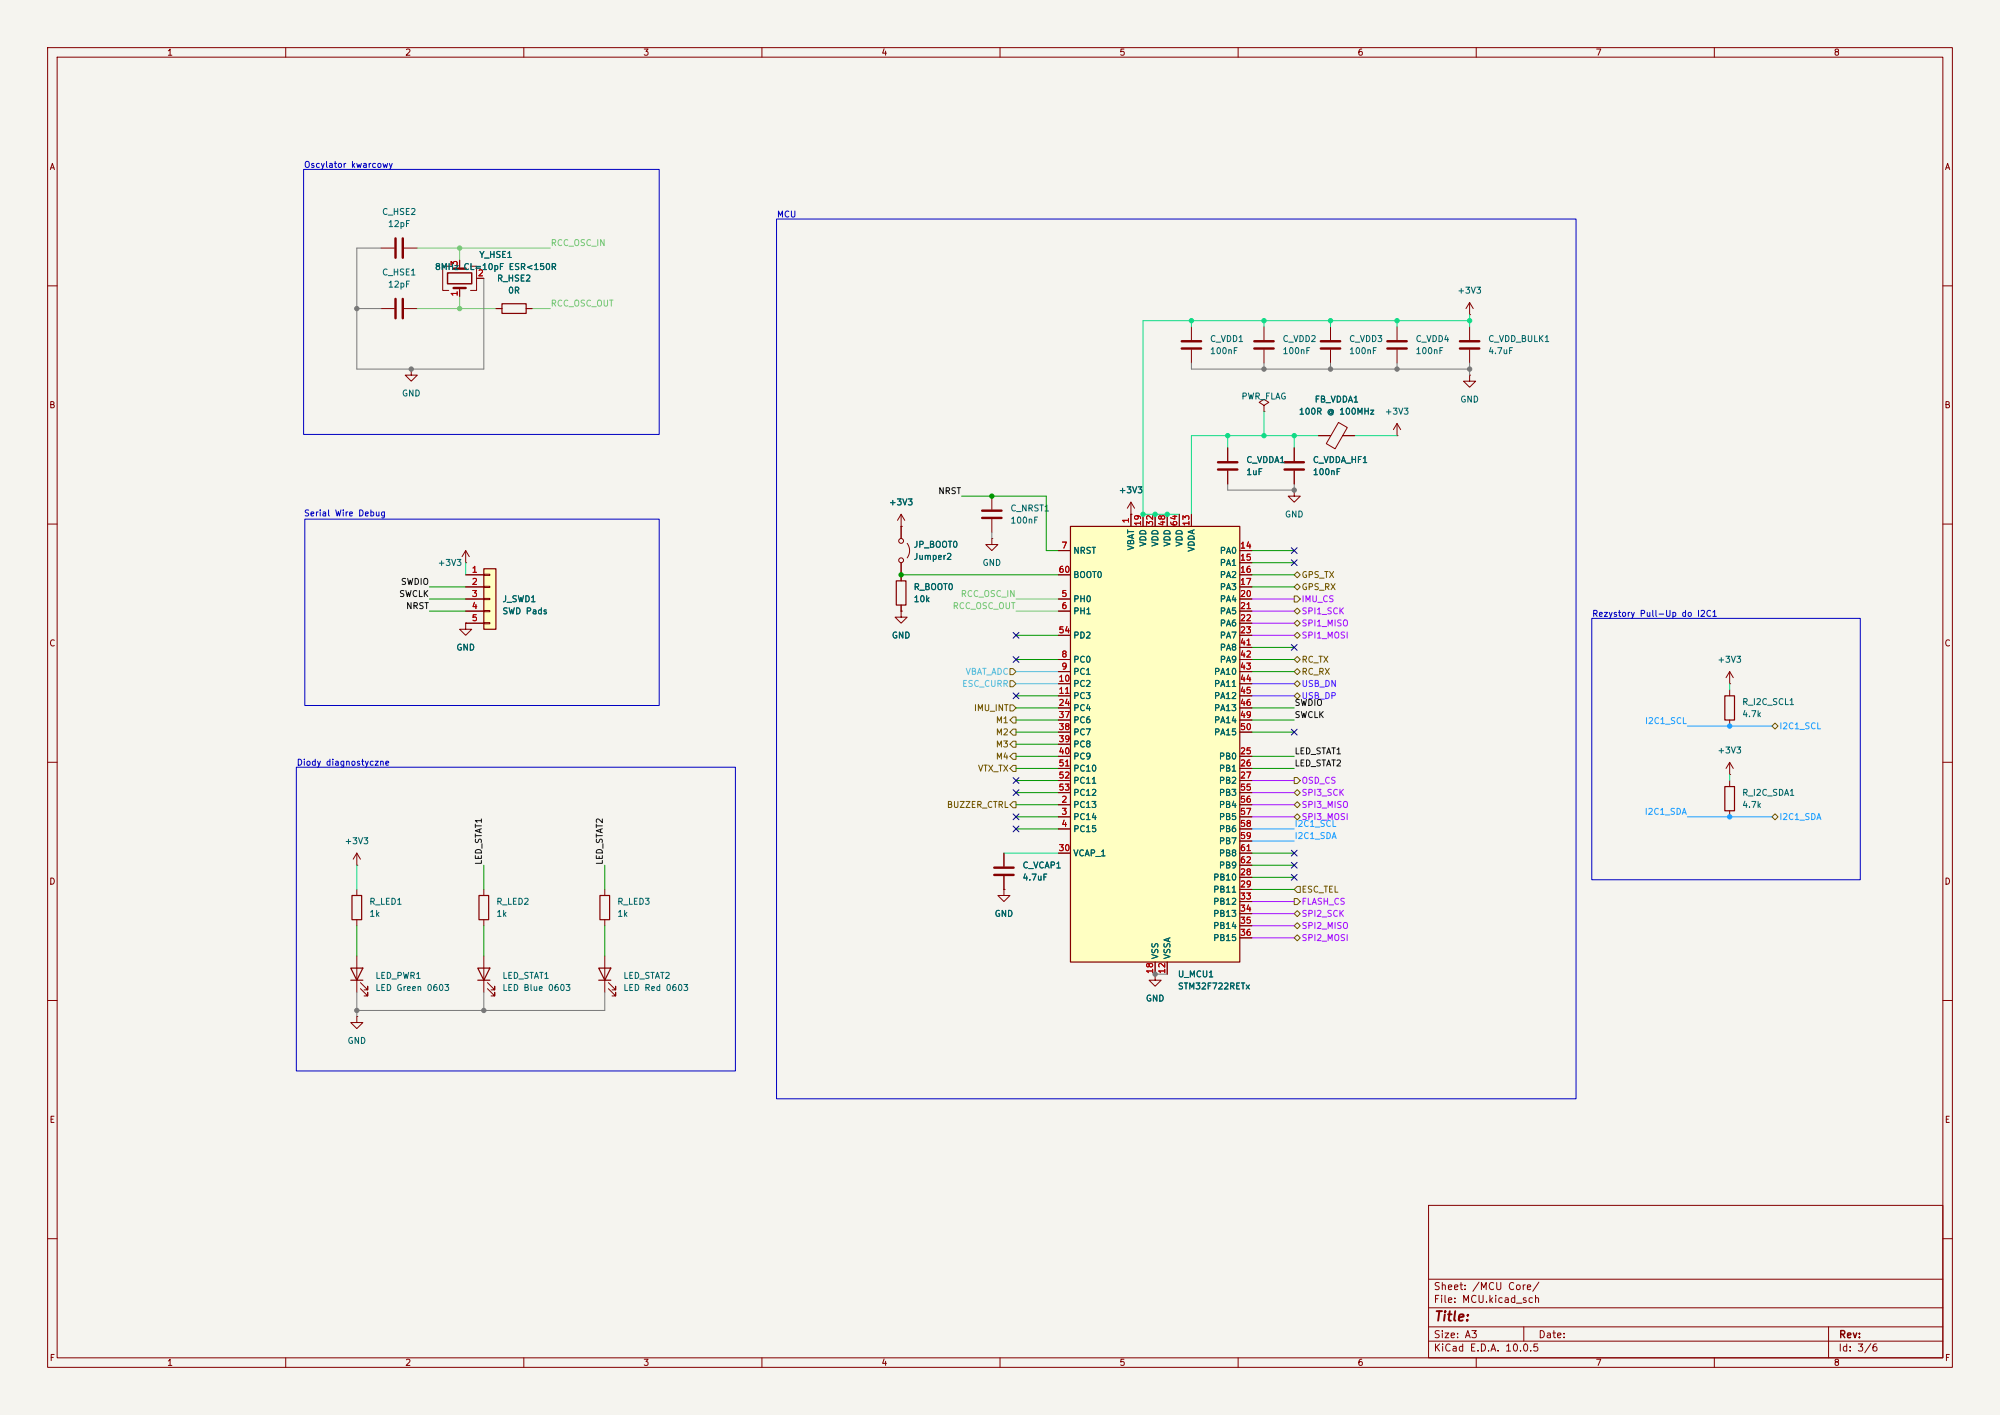
[picture p41: page 3]

Oscylator kwarcowy Serial Wire Debug

Rezystory Pull-Up do I2C1 MCU

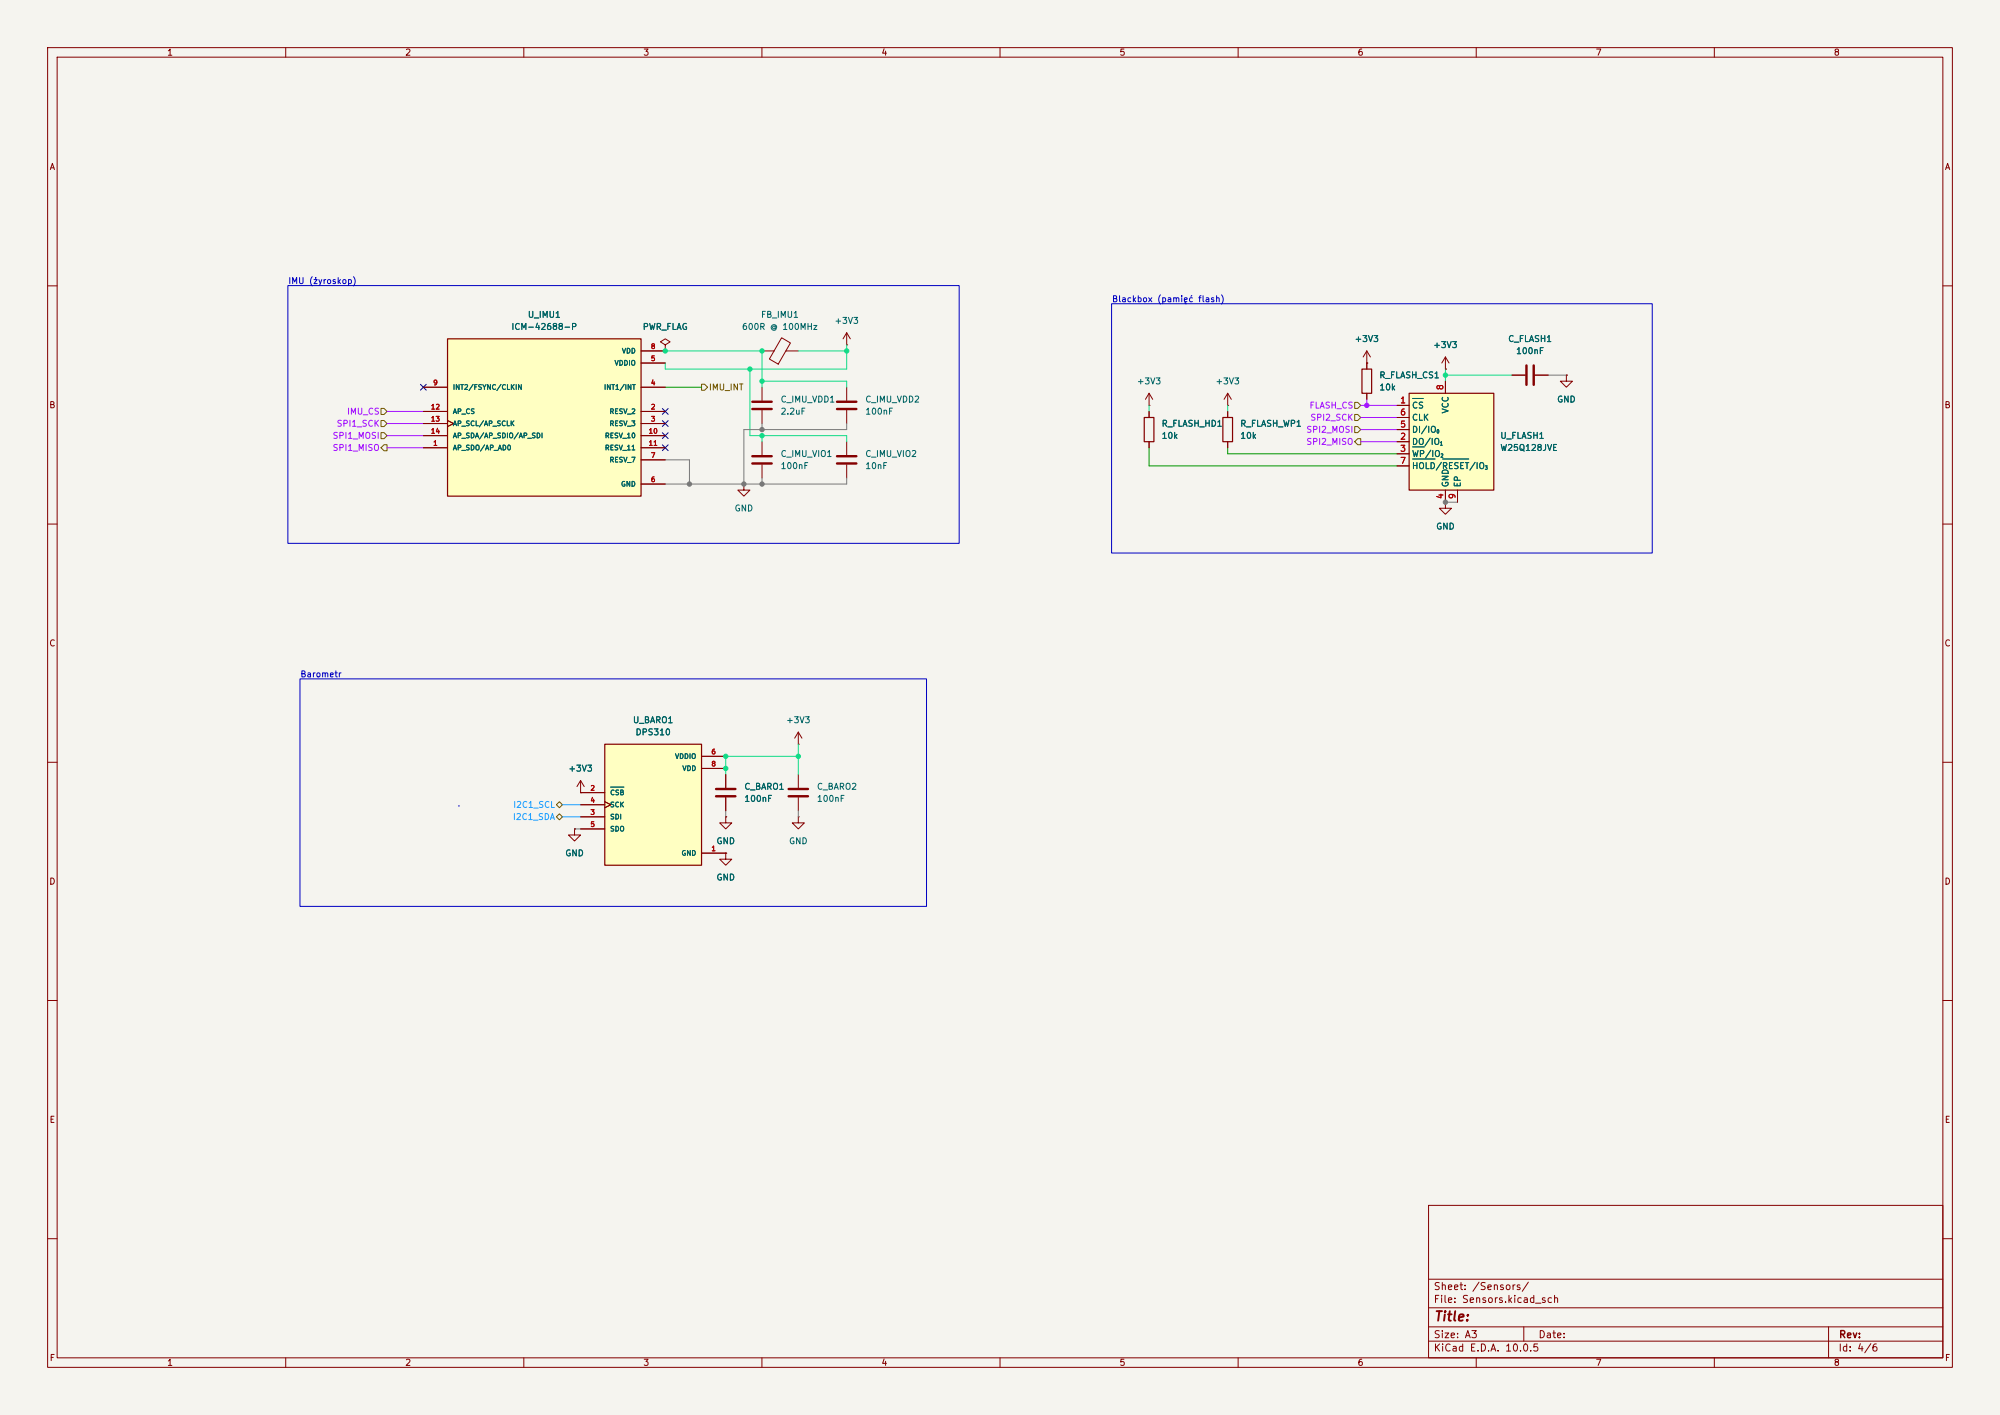
[picture p42: page 4]

4 DI/IO0 5 CLK 6 HOLD/RESET/IO3 7 VCC

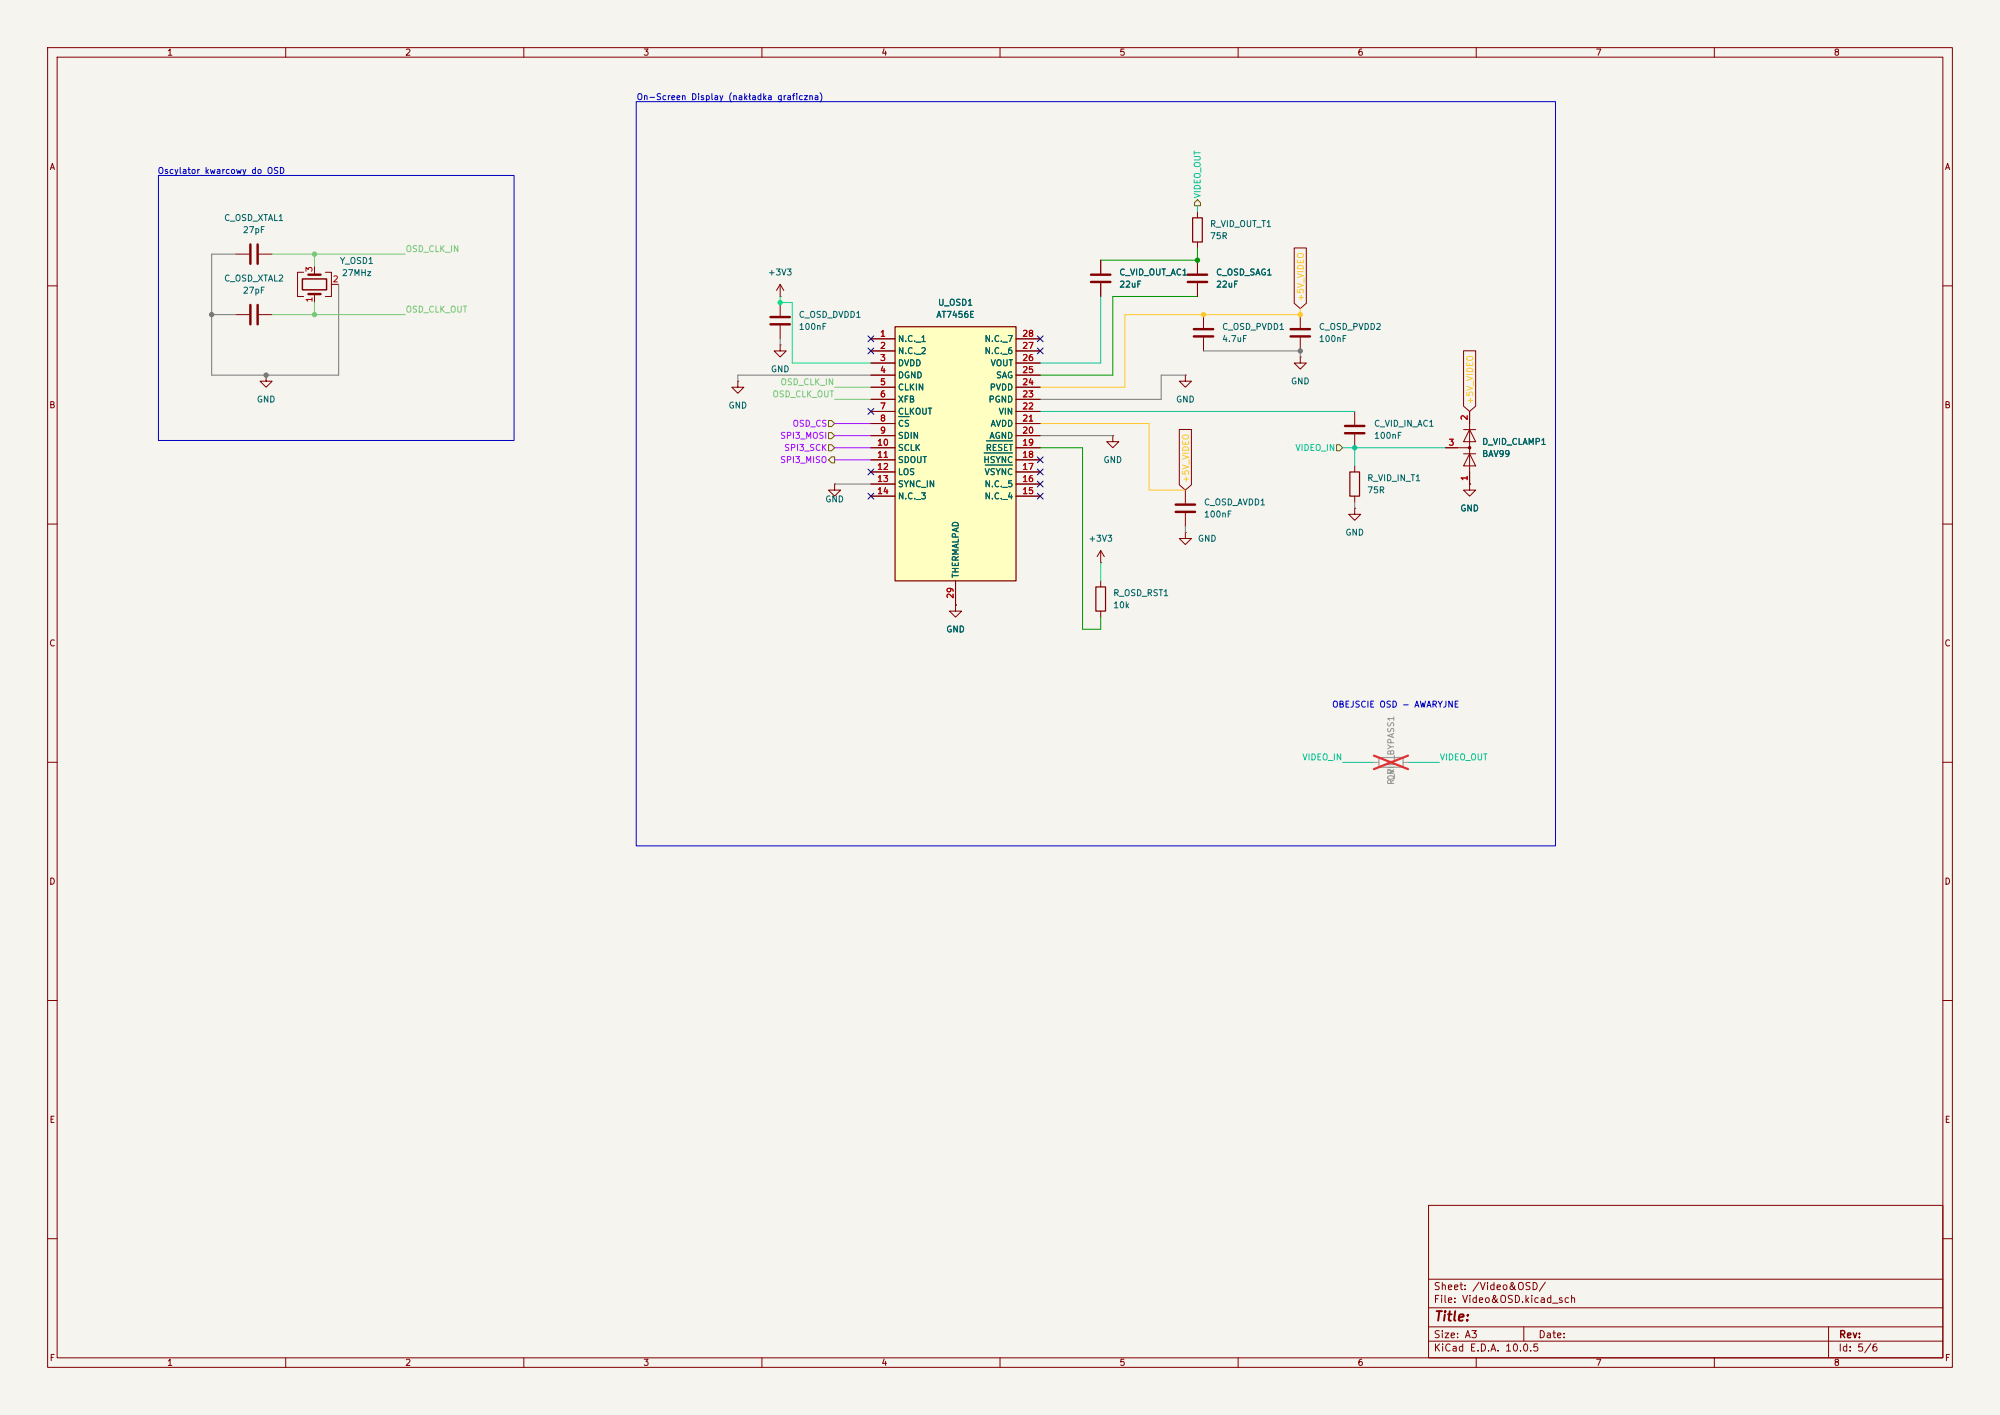
[picture p43: page 5]

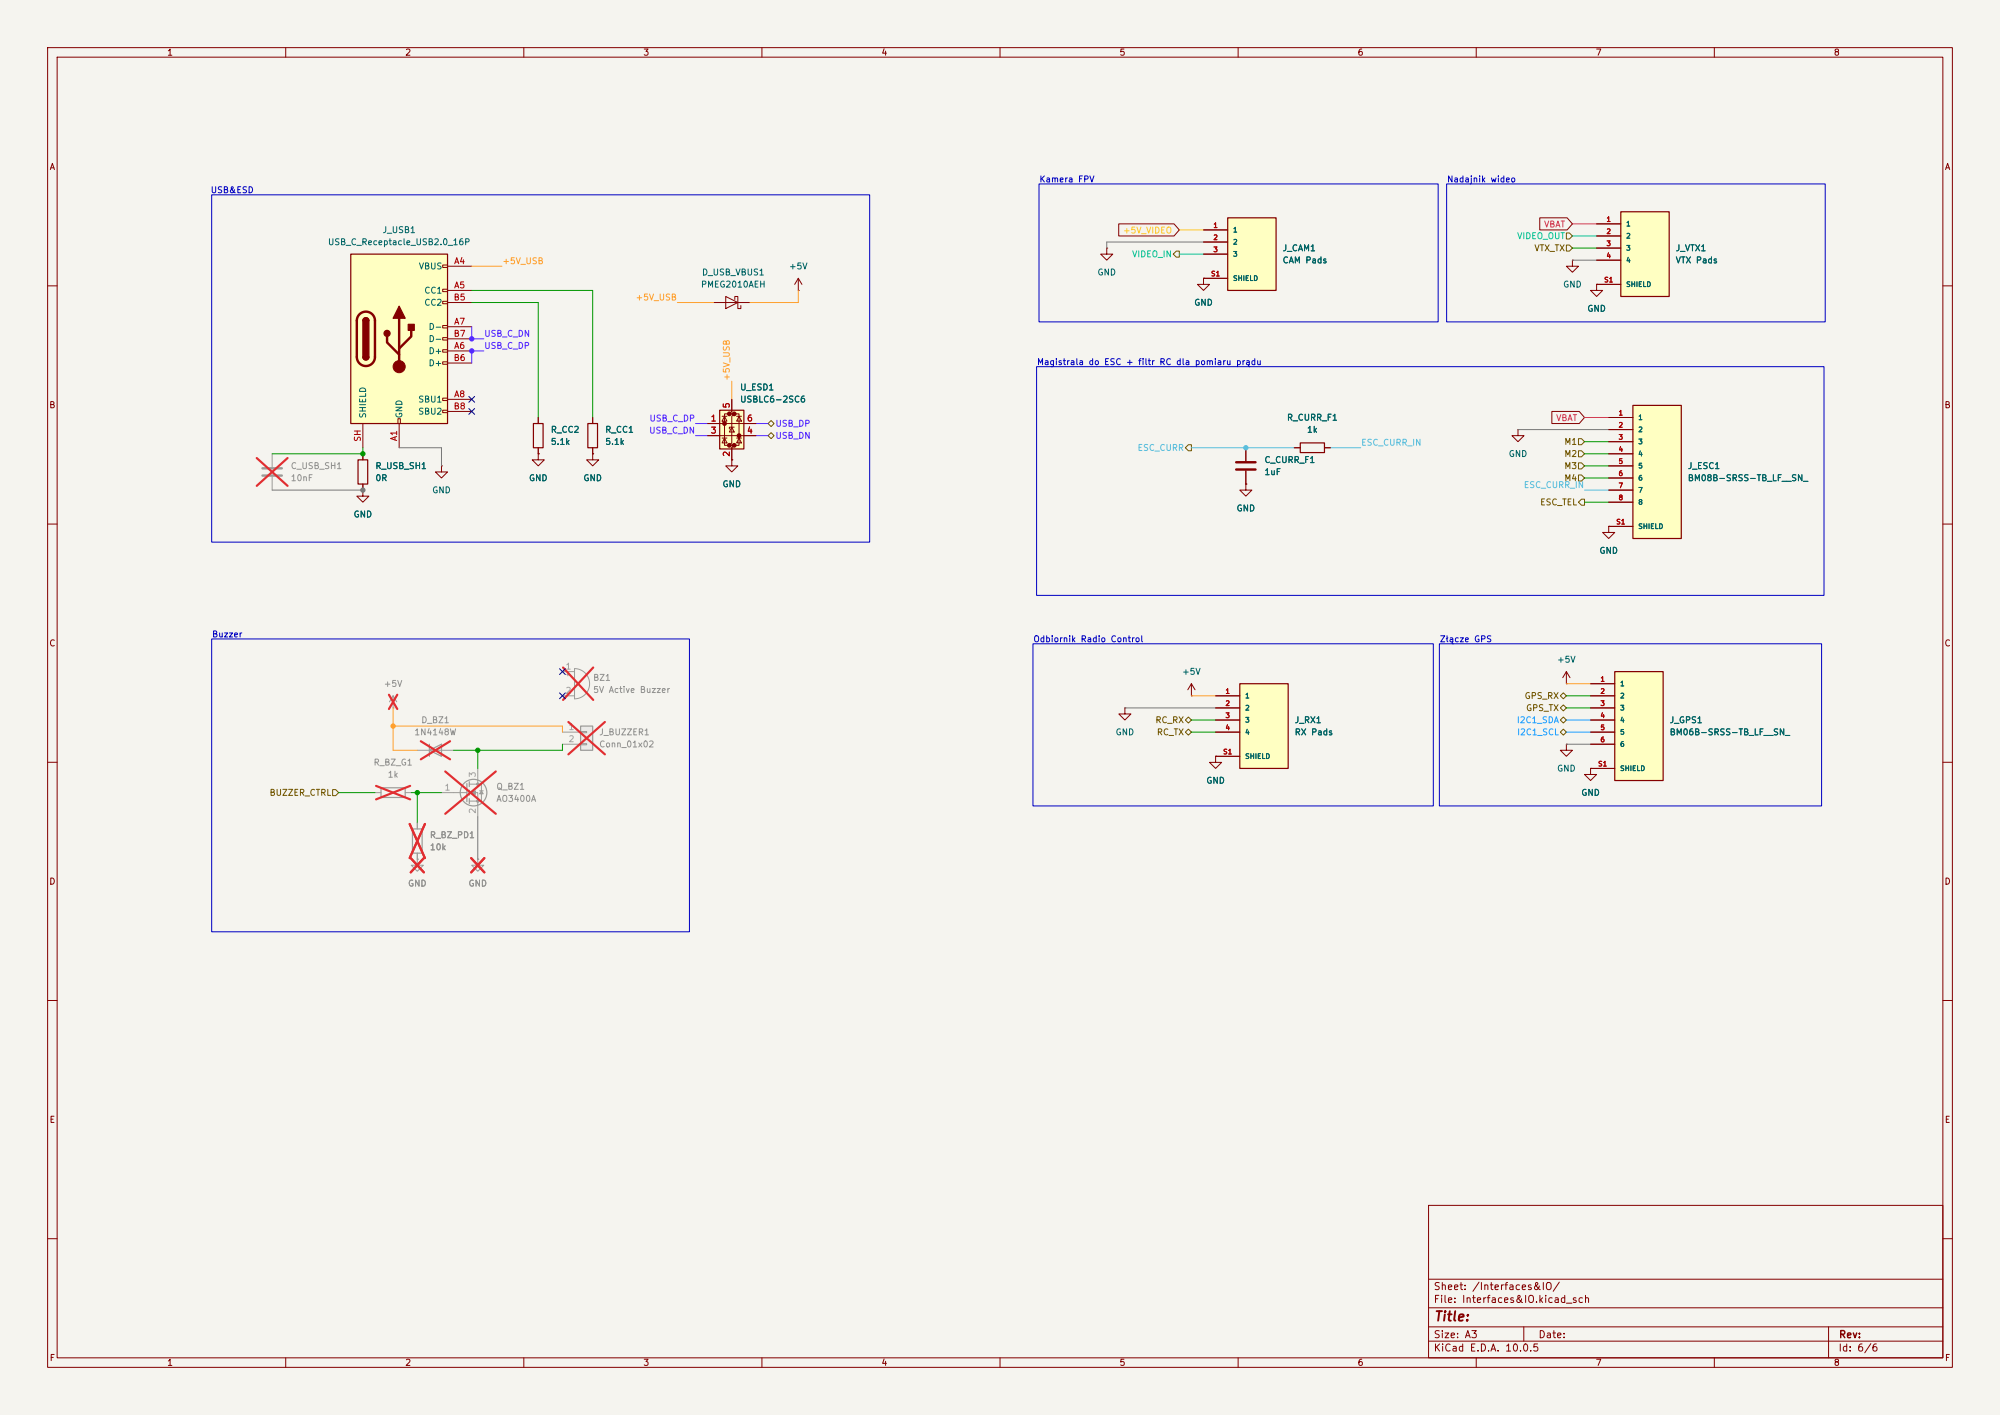
[picture p44: page 6]
