benwys/SparrowHawk/hardware/Sparrow-III/Production/Flight_Controller-III-order-20261003-assembly-top.pdf

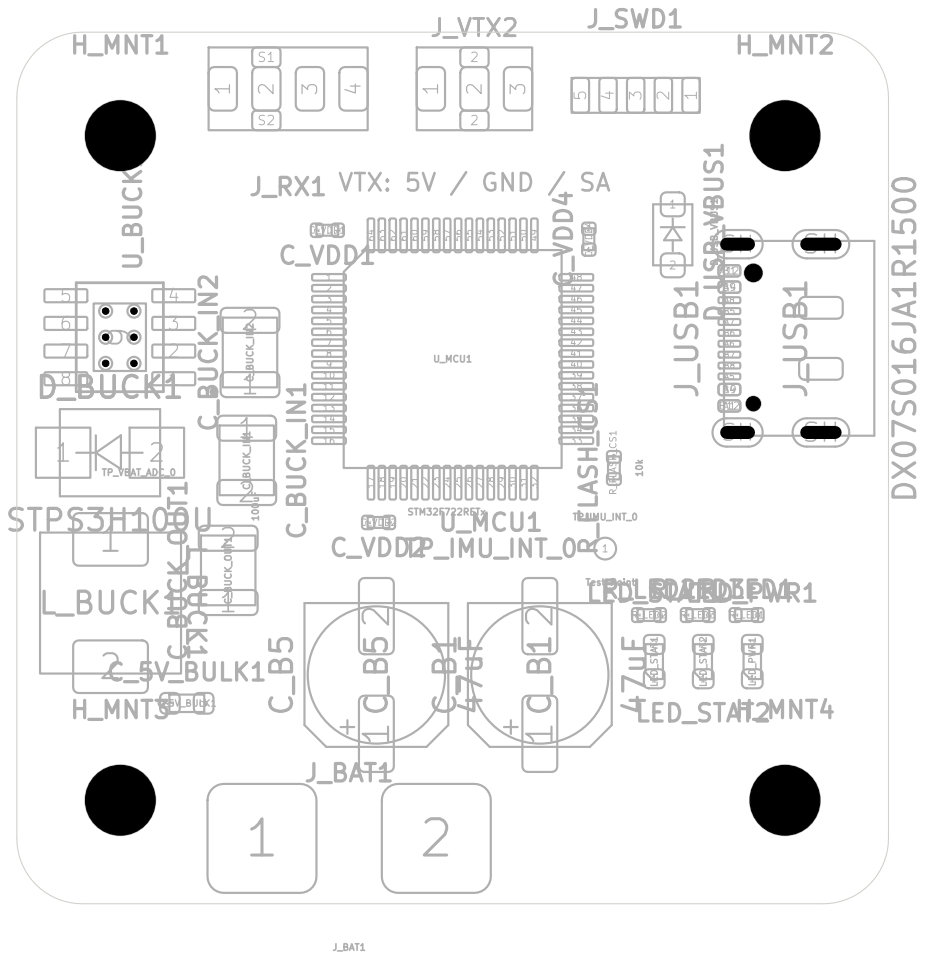
[picture p45: page 1]
