benwys/SparrowHawk/hardware/Sparrow-III/Flight Controller.kicad_pcb

## KiCad design hardware/Sparrow-III/Flight Controller.kicad_pcb (2026-10-04)

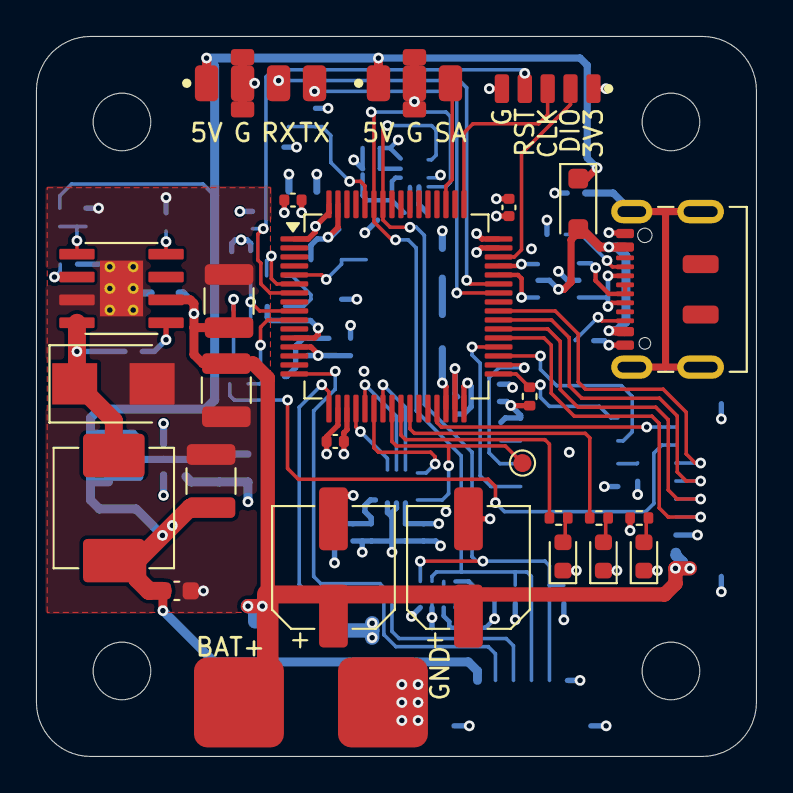
[picture p46: board Flight Controller.kicad_pcb from above]

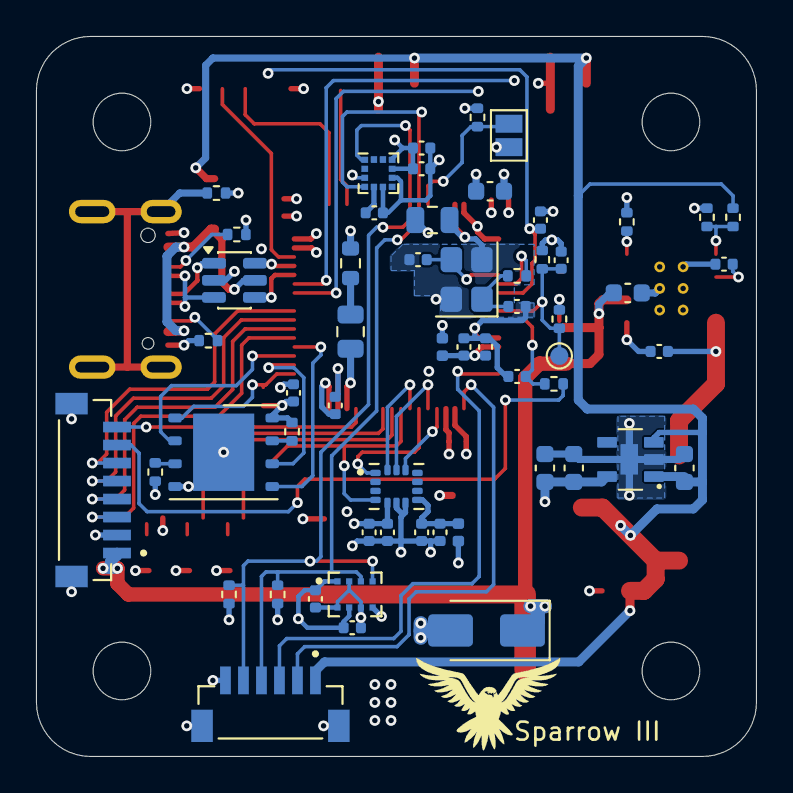
[picture p47: board Flight Controller.kicad_pcb from below]

Board: 4 copper layers, 40.0 x 40.0 mm, 89 parts (58 on the bottom side), 60 nets.

Parts:
C_3V3_BULK1, C_5V_BULK1: 10uF; C_0603_1608Metric
C_B1, C_B5: 47uF; CP_Elec_6.3x5.8
C_BARO1, C_BARO2: 100nF; C_0402_1005Metric
C_BUCK_BOOT1: 100nF; C_0402_1005Metric
C_BUCK_IN1, C_BUCK_IN2: 4.7uF; C_1210_3225Metric
C_BUCK_IN3: 100nF; C_0603_1608Metric
C_BUCK_OUT1: 100uF; C_1210_3225Metric
C_BUCK_SS1: 22nF; C_0402_1005Metric
C_CURR_F1: 1uF; C_0402_1005Metric
C_FLASH1: 100nF; C_0402_1005Metric
C_HSE1, C_HSE2: 12pF; C_0402_1005Metric
C_IMU_VDD1: 2.2uF; C_0402_1005Metric
C_IMU_VDD2: 100nF; C_0402_1005Metric
C_IMU_VIO1: 100nF; C_0402_1005Metric
C_IMU_VIO2: 10nF; C_0402_1005Metric
C_LDO_IN1: 2.2uF; C_0603_1608Metric
C_LDO_OUT1: 2.2uF; C_0603_1608Metric
C_MAG_BULK1: 22uF; C_0805_2012Metric
C_MAG_SET1: 220nF; C_0402_1005Metric
C_MAG_VDD1: 100nF; C_0402_1005Metric
C_MAG_VIO1: 100nF; C_0402_1005Metric
C_NRST1: 100nF; C_0402_1005Metric
C_VBAT_ADC1: 100nF; C_0402_1005Metric
C_VCAP1: 4.7uF; C_0805_2012Metric
C_VDD1, C_VDD2, C_VDD3, C_VDD4: 100nF; C_0402_1005Metric
C_VDDA1: 1uF; C_0402_1005Metric
C_VDDA_HF1: 100nF; C_0402_1005Metric
C_VDD_BULK1: 4.7uF; C_0603_1608Metric
D_BUCK1: STPS3H100U; D_SMB
D_TVS1: SMAJ26A; D_SMA
D_USB_VBUS1: PMEG2010AEH; D_SOD-123F
FB_IMU1: 600R @ 100MHz; L_0402_1005Metric
FB_VDDA1: 100R @ 100MHz; L_0402_1005Metric
H_MNT1, H_MNT2, H_MNT3, H_MNT4: MountingHole 3.2mm_M3; MountingHole_3.2mm_M3
JP_BOOT0: Jumper2; SolderJumper-2_P1.3mm_Open_Pad1.0x1.5mm
J_BAT1: Conn_01x02; VBAT_SolderPad_2x_5x5mm
J_ESC1: BM08B-SRSS-TB_LF__SN_; JST_BM08B-SRSS-TB_LF__SN_
J_GPS1: BM06B-SRSS-TB_LF__SN_; JST_BM06B-SRSS-TB_LF__SN_
J_RX1: RX Pads; SolderPads_RX_1x04
J_SWD1: SWD Pads; SolderPads_SWD_1x05
J_USB1: DX07S016JA1R1500; USB_C_Receptacle_JAE_DX07S016JA1R1500
J_VTX2: VTX: 5V / GND / SA; SolderPads_VTX_1x03
LED_PWR1: LED Green 0603; LED_0603_1608Metric
LED_STAT1: LED Blue 0603; LED_0603_1608Metric
LED_STAT2: LED Red 0603; LED_0603_1608Metric
LOGO1: Sparrowhawk_Logo
L_BUCK1: 6.8uH; L_Vishay_IHLP-2525CZ-01
R_BOOT0: 10k; R_0402_1005Metric
R_BUCK_FB1: 100k; R_0402_1005Metric
R_BUCK_FB2: 17.8k; R_0402_1005Metric
R_BUCK_RT1: 49.9k; R_0402_1005Metric
R_CC1, R_CC2: 5.1k; R_0402_1005Metric
R_CURR_F1: 1k; R_0402_1005Metric
R_FLASH_CS1: 10k; R_0402_1005Metric
R_FLASH_HD1: 10k; R_0402_1005Metric
R_FLASH_WP1: 10k; R_0402_1005Metric
R_HSE2: 0R; R_0402_1005Metric
R_I2C_SCL1, R_I2C_SDA1: 4.7k; R_0402_1005Metric
R_LED1, R_LED2, R_LED3: 1k; R_0402_1005Metric
R_USB_SH1: 0R; R_0402_1005Metric
R_VBAT_D1: 100k; R_0402_1005Metric
R_VBAT_D2: 10k; R_0402_1005Metric
R_VCAP_ESR1: 0.15R; R_0603_1608Metric
TP_IMU_INT_0: Test Point; TestPoint_Pad_D1.0mm
TP_VBAT_ADC_0: Test Point; TestPoint_Pad_D1.0mm
U_BARO1: DPS368; XDCR_DPS310
U_BUCK1: LMR14030SDDAR; SOIC127P600X170-9N_SparrowIII
U_ESD1: USBLC6-2SC6; SOT-23-6
U_FLASH1: W25Q128JVPIQ; WSON-8-1EP_6x5mm_P1.27mm_EP3.4x4.3mm
U_IMU1: ICM-42688-P; PQFN50P300X250X97-14N
U_LDO1: TLV75533PDYDR; SOT-23-5_ThermalPad_TI_DYD0005A
U_MAG1: LIS2MDLTR; LGA-12_2x2mm_P0.5mm
U_MCU1: STM32F722RETx; LQFP-64_10x10mm_P0.5mm
Y_HSE1: 8MHz; Crystal_SMD_3225-4Pin_3.2x2.5mm

Connections:
+3V3: C_3V3_BULK1.1, C_BARO1.1, C_BARO2.1, C_FLASH1.1, C_IMU_VIO1.1, C_IMU_VIO2.1, C_LDO_OUT1.1, C_MAG_BULK1.1, C_MAG_VDD1.1, C_MAG_VIO1.1, C_VDD1.1, C_VDD2.1, C_VDD3.1, C_VDD4.1, C_VDD_BULK1.1, FB_IMU1.2, FB_VDDA1.1, JP_BOOT0.1 (A), J_SWD1.1, R_FLASH_CS1.1, R_FLASH_HD1.1, R_FLASH_WP1.1, R_I2C_SCL1.1, R_I2C_SDA1.2, R_LED1.1, U_BARO1.2 (~CSB), U_BARO1.6 (VDDIO), U_BARO1.8 (VDD), U_FLASH1.8 (VCC), U_IMU1.5 (VDDIO), U_LDO1.5 (VOUT), U_MAG1.3 (~CS), U_MAG1.9 (Vdd), U_MAG1.10 (Vdd_IO), U_MCU1.1 (VBAT), U_MCU1.19 (VDD), U_MCU1.32 (VDD), U_MCU1.48 (VDD), U_MCU1.64 (VDD)
+5V: C_5V_BULK1.1, C_BUCK_OUT1.1, C_LDO_IN1.1, D_USB_VBUS1.1 (K), J_GPS1.1, J_RX1.1, J_VTX2.1, L_BUCK1.2, R_BUCK_FB1.1, U_LDO1.1 (VIN), U_LDO1.3 (EN)
/Interfaces&IO/+5V_USB: D_USB_VBUS1.2 (A), J_USB1.A4 (VBUS), J_USB1.A9 (VBUS), J_USB1.B4 (VBUS), J_USB1.B9 (VBUS), U_ESD1.5 (VBUS)
/Interfaces&IO/ESC_CURR: C_CURR_F1.1, R_CURR_F1.1, U_MCU1.10 (PC2)
/Interfaces&IO/ESC_CURR_IN: J_ESC1.7, R_CURR_F1.2
/Interfaces&IO/ESC_TEL: J_ESC1.8, U_MCU1.29 (PB11)
/Interfaces&IO/GPS_RX: J_GPS1.2, U_MCU1.17 (PA3)
/Interfaces&IO/GPS_TX: J_GPS1.3, U_MCU1.16 (PA2)
/Interfaces&IO/M1: J_ESC1.3, U_MCU1.37 (PC6)
/Interfaces&IO/M2: J_ESC1.4, U_MCU1.38 (PC7)
/Interfaces&IO/M3: J_ESC1.5, U_MCU1.39 (PC8)
/Interfaces&IO/M4: J_ESC1.6, U_MCU1.40 (PC9)
/Interfaces&IO/RC_RX: J_RX1.3, U_MCU1.43 (PA10)
/Interfaces&IO/RC_TX: J_RX1.4, U_MCU1.42 (PA9)
/Interfaces&IO/USB_C_DN: J_USB1.A7 (D-), J_USB1.B7 (D-), U_ESD1.3 (I/O2)
/Interfaces&IO/USB_C_DP: J_USB1.A6 (D+), J_USB1.B6 (D+), U_ESD1.1 (I/O1)
/Interfaces&IO/USB_DN: U_ESD1.4 (I/O2), U_MCU1.44 (PA11)
/Interfaces&IO/USB_DP: U_ESD1.6 (I/O1), U_MCU1.45 (PA12)
/Interfaces&IO/VTX_TX: J_VTX2.3, U_MCU1.51 (PC10)
/MCU Core/FLASH_CS: R_FLASH_CS1.2, U_FLASH1.1 (~CS), U_MCU1.33 (PB12)
/MCU Core/I2C1_SCL: J_GPS1.5, R_I2C_SCL1.2, U_BARO1.4 (SCK), U_MAG1.1 (SCL/SPC), U_MCU1.58 (PB6)
/MCU Core/I2C1_SDA: J_GPS1.4, R_I2C_SDA1.1, U_BARO1.3 (SDI), U_MAG1.4 (SDA/SDI/SDO), U_MCU1.59 (PB7)
/MCU Core/IMU_CS: U_IMU1.12 (AP_CS), U_MCU1.20 (PA4)
/MCU Core/IMU_INT: TP_IMU_INT_0.1 (1_1), U_IMU1.4 (INT1/INT), U_MCU1.24 (PC4)
/MCU Core/LED_STAT1: R_LED2.1, U_MCU1.25 (PB0)
/MCU Core/LED_STAT2: R_LED3.1, U_MCU1.26 (PB1)
/MCU Core/NRST: C_NRST1.1, J_SWD1.4, U_MCU1.7 (NRST)
/MCU Core/RCC_OSC_IN: C_HSE2.2, U_MCU1.5 (PH0), Y_HSE1.3
/MCU Core/RCC_OSC_OUT: R_HSE2.2, U_MCU1.6 (PH1)
/MCU Core/SPI1_MISO: U_IMU1.1 (AP_SDO/AP_AD0), U_MCU1.22 (PA6)
/MCU Core/SPI1_MOSI: U_IMU1.14 (AP_SDA/AP_SDIO/AP_SDI), U_MCU1.23 (PA7)
/MCU Core/SPI1_SCK: U_IMU1.13 (AP_SCL/AP_SCLK), U_MCU1.21 (PA5)
/MCU Core/SPI2_MISO: U_FLASH1.2 (DO/IO_{1}), U_MCU1.35 (PB14)
/MCU Core/SPI2_MOSI: U_FLASH1.5 (DI/IO_{0}), U_MCU1.36 (PB15)
/MCU Core/SPI2_SCK: U_FLASH1.6 (CLK), U_MCU1.34 (PB13)
/MCU Core/SWCLK: J_SWD1.3, U_MCU1.49 (PA14)
/MCU Core/SWDIO: J_SWD1.2, U_MCU1.46 (PA13)
/MCU Core/VBAT_ADC: C_VBAT_ADC1.1, R_VBAT_D1.1, R_VBAT_D2.2, TP_VBAT_ADC_0.1 (1_1), U_MCU1.9 (PC1)
/MCU Core/VCAP_RETURN: C_VCAP1.2, R_VCAP_ESR1.1
/Sensors/MAG_C1: C_MAG_SET1.1, U_MAG1.5 (C1)
GND: C_3V3_BULK1.2, C_5V_BULK1.2, C_B1.2, C_B5.2, C_BARO1.2, C_BARO2.2, C_BUCK_IN1.2, C_BUCK_IN2.2, C_BUCK_IN3.2, C_BUCK_OUT1.2, C_BUCK_SS1.2, C_CURR_F1.2, C_FLASH1.2, C_HSE1.1, C_HSE2.1, C_IMU_VDD1.2, C_IMU_VDD2.2, C_IMU_VIO1.2, C_IMU_VIO2.2, C_LDO_IN1.2, C_LDO_OUT1.2, C_MAG_BULK1.2, C_MAG_SET1.2, C_MAG_VDD1.2, C_MAG_VIO1.2, C_NRST1.2, C_VBAT_ADC1.2, C_VDD1.2, C_VDD2.2, C_VDD3.2, C_VDD4.2, C_VDDA1.2, C_VDDA_HF1.2, C_VDD_BULK1.2, D_BUCK1.2 (A), D_TVS1.2 (A2), J_BAT1.2, J_ESC1.2, J_ESC1.S1 (SHIELD), J_ESC1.S2 (SHIELD), J_GPS1.6, J_GPS1.S1 (SHIELD), J_GPS1.S2 (SHIELD), J_RX1.2, J_RX1.S1 (SHIELD), J_RX1.S2 (SHIELD), J_SWD1.5, J_USB1.A1 (GND), J_USB1.A12 (GND), J_USB1.B1 (GND), J_USB1.B12 (GND), J_VTX2.2, LED_PWR1.1 (K), LED_STAT1.1 (K), LED_STAT2.1 (K), R_BOOT0.1, R_BUCK_FB2.2, R_BUCK_RT1.2, R_CC1.2, R_CC2.2, R_USB_SH1.2, R_VBAT_D2.1, R_VCAP_ESR1.2, U_BARO1.1 (GND), U_BARO1.5 (SDO), U_BARO1.7 (GND), U_BUCK1.7 (GND), U_BUCK1.9 (GND), U_BUCK1.V1 (GND), U_BUCK1.V2 (GND), U_BUCK1.V3 (GND), U_BUCK1.V4 (GND), U_BUCK1.V5 (GND), U_BUCK1.V6 (GND), U_ESD1.2 (GND), U_FLASH1.4 (GND), U_FLASH1.9 (EP), U_IMU1.6 (GND), U_IMU1.7 (RESV_7), U_LDO1.2 (GND), U_LDO1.6 (EP), U_MAG1.6 (GND), U_MAG1.8 (GND), U_MCU1.12 (VSSA), U_MCU1.18 (VSS), U_MCU1.31 (VSS), U_MCU1.47 (VSS), U_MCU1.63 (VSS), Y_HSE1.2 (G), Y_HSE1.4 (G)
unnamed: C_HSE1.2, R_HSE2.1, Y_HSE1.1
unnamed: C_BUCK_BOOT1.2, D_BUCK1.1 (K), L_BUCK1.1, U_BUCK1.8 (SW)
unnamed: JP_BOOT0.2 (B), R_BOOT0.2, U_MCU1.60 (BOOT0)
unnamed: J_USB1.A5 (CC1), R_CC1.1
unnamed: J_USB1.B5 (CC2), R_CC2.1
unnamed: J_USB1.SH (SHIELD), R_USB_SH1.1
unnamed: LED_PWR1.2 (A), R_LED1.2
unnamed: LED_STAT1.2 (A), R_LED2.2
unnamed: LED_STAT2.2 (A), R_LED3.2
unnamed: C_BUCK_BOOT1.1, U_BUCK1.1 (BOOT)
unnamed: R_BUCK_FB1.2, R_BUCK_FB2.1, U_BUCK1.5 (FB)
unnamed: R_BUCK_RT1.1, U_BUCK1.4 (RT/SYNC)
unnamed: C_BUCK_SS1.1, U_BUCK1.6 (SS)
unnamed: R_FLASH_HD1.2, U_FLASH1.7 (~HOLD/~RESET/IO_{3})
unnamed: R_FLASH_WP1.2, U_FLASH1.3 (~WP/IO_{2})
unnamed: C_IMU_VDD1.1, C_IMU_VDD2.1, FB_IMU1.1, U_IMU1.8 (VDD)
unnamed: C_VCAP1.1, U_MCU1.30 (VCAP_1)
unnamed: C_VDDA1.1, C_VDDA_HF1.1, FB_VDDA1.2, U_MCU1.13 (VDDA)
VBAT: C_B1.1, C_B5.1, C_BUCK_IN1.1, C_BUCK_IN2.1, C_BUCK_IN3.1, D_TVS1.1 (A1), J_BAT1.1, J_ESC1.1, R_VBAT_D1.2, U_BUCK1.2 (VIN)
