benwys/SparrowHawk/hardware/Sparrow-I/Flight Controller - carrier board.kicad_pcb

## KiCad design hardware/Sparrow-I/Flight Controller - carrier board.kicad_pcb (2026-09-14)

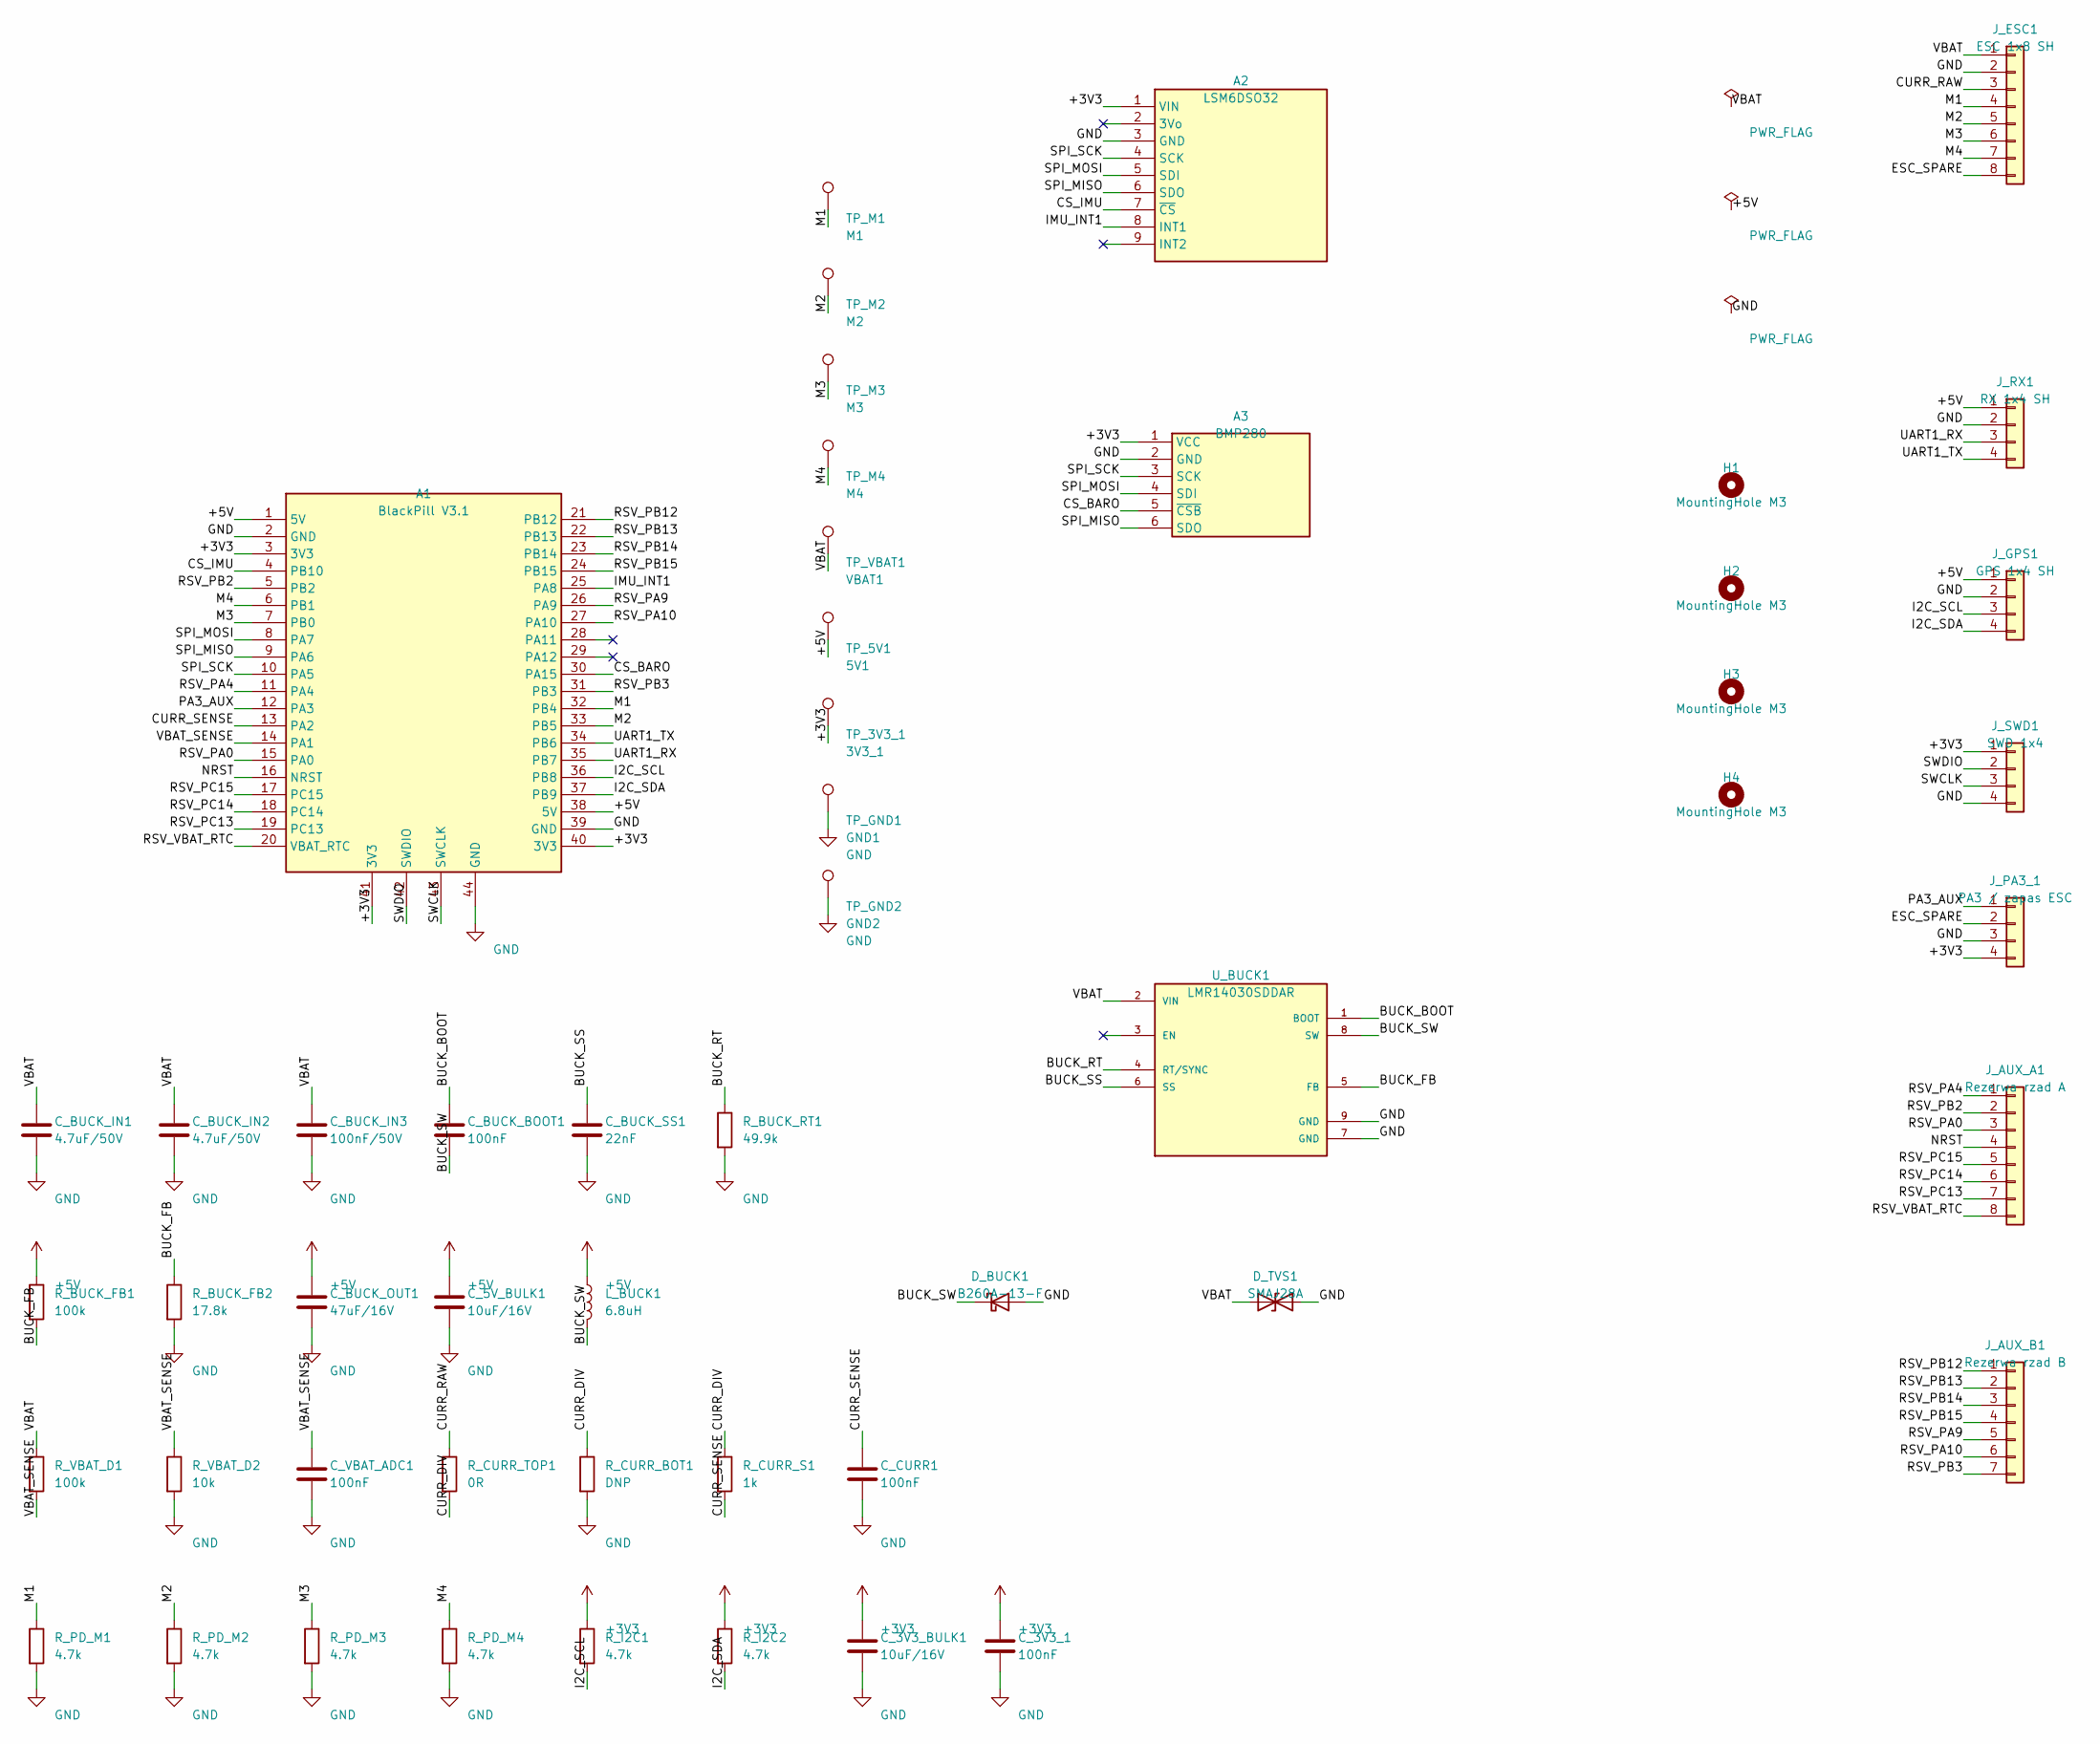
[picture p48: schematic Flight Controller - carrier board.kicad_sch, Sparrow-I - carrier board]

Parts:
A1: BlackPill V3.1; Module_BlackPill_STM32F411_WeAct_V31
A2: LSM6DSO32; Module_LSM6DSO32_Adafruit_4692
A3: BMP280; Module_BMP280_6pin
C_3V3_1: 100nF; C_0402_1005Metric
C_3V3_BULK1, C_5V_BULK1: 10uF/16V; C_0805_2012Metric
C_BUCK_BOOT1: 100nF; C_0402_1005Metric
C_BUCK_IN1, C_BUCK_IN2: 4.7uF/50V; C_1210_3225Metric
C_BUCK_IN3: 100nF/50V; C_0402_1005Metric
C_BUCK_OUT1: 47uF/16V; C_1210_3225Metric
C_BUCK_SS1: 22nF; C_0402_1005Metric
C_CURR1: 100nF; C_0402_1005Metric
C_VBAT_ADC1: 100nF; C_0402_1005Metric
D_BUCK1: B260A-13-F; D_SMA
D_TVS1: SMAJ28A; D_SMA
H1, H2, H3, H4: MountingHole M3; MountingHole_3.2mm_M3
J_AUX_A1: Rezerwa rzad A; PinHeader_1x08_P2.54mm_Vertical
J_AUX_B1: Rezerwa rzad B; PinHeader_1x07_P2.54mm_Vertical
J_ESC1: ESC 1x8 SH; JST_SH_SM08B-SRSS-TB_1x08-1MP_P1.00mm_Horizontal
J_GPS1: GPS 1x4 SH; JST_SH_SM04B-SRSS-TB_1x04-1MP_P1.00mm_Horizontal
J_PA3_1: PA3 / zapas ESC; PinHeader_1x04_P2.54mm_Vertical
J_RX1: RX 1x4 SH; JST_SH_SM04B-SRSS-TB_1x04-1MP_P1.00mm_Horizontal
J_SWD1: SWD 1x4; PinHeader_1x04_P2.54mm_Vertical
L_BUCK1: 6.8uH; L_Sunlord_SWPA6028S
R_BUCK_FB1: 100k; R_0402_1005Metric
R_BUCK_FB2: 17.8k; R_0402_1005Metric
R_BUCK_RT1: 49.9k; R_0402_1005Metric
R_CURR_BOT1: DNP; R_0402_1005Metric
R_CURR_S1: 1k; R_0402_1005Metric
R_CURR_TOP1: 0R; R_0402_1005Metric
R_I2C1, R_I2C2: 4.7k; R_0402_1005Metric
R_PD_M1, R_PD_M2, R_PD_M3, R_PD_M4: 4.7k; R_0402_1005Metric
R_VBAT_D1: 100k; R_0402_1005Metric
R_VBAT_D2: 10k; R_0402_1005Metric
TP_3V3_1: 3V3_1; TestPoint_Pad_D1.5mm
TP_5V1: 5V1; TestPoint_Pad_D1.5mm
TP_GND1: GND1; TestPoint_Pad_D1.5mm
TP_GND2: GND2; TestPoint_Pad_D1.5mm
TP_M1: M1; TestPoint_Pad_D1.5mm
TP_M2: M2; TestPoint_Pad_D1.5mm
TP_M3: M3; TestPoint_Pad_D1.5mm
TP_M4: M4; TestPoint_Pad_D1.5mm
TP_VBAT1: VBAT1; TestPoint_Pad_D1.5mm
U_BUCK1: LMR14030SDDAR; SOIC127P600X170-9N

Connections:
+3V3: A1.3 (3V3), A1.40 (3V3), A1.41 (3V3), A2.1 (VIN), A3.1 (VCC), C_3V3_1.1, C_3V3_BULK1.1, J_PA3_1.4, J_SWD1.1, R_I2C1.1, R_I2C2.1, TP_3V3_1.1 (1_1)
+5V: A1.1 (5V), A1.38 (5V), C_5V_BULK1.1, C_BUCK_OUT1.1, J_GPS1.1, J_RX1.1, L_BUCK1.1, R_BUCK_FB1.1, TP_5V1.1 (1_1)
/BUCK_BOOT: C_BUCK_BOOT1.1, U_BUCK1.1 (BOOT)
/BUCK_FB: R_BUCK_FB1.2, R_BUCK_FB2.1, U_BUCK1.5 (FB)
/BUCK_RT: R_BUCK_RT1.1, U_BUCK1.4 (RT/SYNC)
/BUCK_SS: C_BUCK_SS1.1, U_BUCK1.6 (SS)
/BUCK_SW: C_BUCK_BOOT1.2, D_BUCK1.1 (K), L_BUCK1.2, U_BUCK1.8 (SW)
/CS_BARO: A1.30 (PA15), A3.5 (~CSB)
/CS_IMU: A1.4 (PB10), A2.7 (~CS)
/CURR_DIV: R_CURR_BOT1.1, R_CURR_S1.1, R_CURR_TOP1.2
/CURR_RAW: J_ESC1.3, R_CURR_TOP1.1
/CURR_SENSE: A1.13 (PA2), C_CURR1.1, R_CURR_S1.2
/ESC_SPARE: J_ESC1.8, J_PA3_1.2
/I2C_SCL: A1.36 (PB8), J_GPS1.3, R_I2C1.2
/I2C_SDA: A1.37 (PB9), J_GPS1.4, R_I2C2.2
/IMU_INT1: A1.25 (PA8), A2.8 (INT1)
/M1: A1.32 (PB4), J_ESC1.4, R_PD_M1.1, TP_M1.1 (1_1)
/M2: A1.33 (PB5), J_ESC1.5, R_PD_M2.1, TP_M2.1 (1_1)
/M3: A1.7 (PB0), J_ESC1.6, R_PD_M3.1, TP_M3.1 (1_1)
/M4: A1.6 (PB1), J_ESC1.7, R_PD_M4.1, TP_M4.1 (1_1)
/NRST: A1.16 (NRST), J_AUX_A1.4
/PA3_AUX: A1.12 (PA3), J_PA3_1.1
/RSV_PA0: A1.15 (PA0), J_AUX_A1.3
/RSV_PA4: A1.11 (PA4), J_AUX_A1.1
/RSV_PA9: A1.26 (PA9), J_AUX_B1.5
/RSV_PA10: A1.27 (PA10), J_AUX_B1.6
/RSV_PB2: A1.5 (PB2), J_AUX_A1.2
/RSV_PB3: A1.31 (PB3), J_AUX_B1.7
/RSV_PB12: A1.21 (PB12), J_AUX_B1.1
/RSV_PB13: A1.22 (PB13), J_AUX_B1.2
/RSV_PB14: A1.23 (PB14), J_AUX_B1.3
/RSV_PB15: A1.24 (PB15), J_AUX_B1.4
/RSV_PC13: A1.19 (PC13), J_AUX_A1.7
/RSV_PC14: A1.18 (PC14), J_AUX_A1.6
/RSV_PC15: A1.17 (PC15), J_AUX_A1.5
/RSV_VBAT_RTC: A1.20 (VBAT_RTC), J_AUX_A1.8
/SPI_MISO: A1.9 (PA6), A2.6 (SDO), A3.6 (SDO)
/SPI_MOSI: A1.8 (PA7), A2.5 (SDI), A3.4 (SDI)
/SPI_SCK: A1.10 (PA5), A2.4 (SCK), A3.3 (SCK)
/SWCLK: A1.43 (SWCLK), J_SWD1.3
/SWDIO: A1.42 (SWDIO), J_SWD1.2
/UART1_RX: A1.35 (PB7), J_RX1.3
/UART1_TX: A1.34 (PB6), J_RX1.4
/VBAT: C_BUCK_IN1.1, C_BUCK_IN2.1, C_BUCK_IN3.1, D_TVS1.1 (A1), J_ESC1.1, R_VBAT_D1.1, TP_VBAT1.1 (1_1), U_BUCK1.2 (VIN)
/VBAT_SENSE: A1.14 (PA1), C_VBAT_ADC1.1, R_VBAT_D1.2, R_VBAT_D2.1
GND: A1.2 (GND), A1.39 (GND), A1.44 (GND), A2.3 (GND), A3.2 (GND), C_3V3_1.2, C_3V3_BULK1.2, C_5V_BULK1.2, C_BUCK_IN1.2, C_BUCK_IN2.2, C_BUCK_IN3.2, C_BUCK_OUT1.2, C_BUCK_SS1.2, C_CURR1.2, C_VBAT_ADC1.2, D_BUCK1.2 (A), D_TVS1.2 (A2), J_ESC1.2, J_GPS1.2, J_PA3_1.3, J_RX1.2, J_SWD1.4, R_BUCK_FB2.2, R_BUCK_RT1.2, R_CURR_BOT1.2, R_PD_M1.2, R_PD_M2.2, R_PD_M3.2, R_PD_M4.2, R_VBAT_D2.2, TP_GND1.1 (1_1), TP_GND2.1 (1_1), U_BUCK1.7 (GND), U_BUCK1.9 (GND), U_BUCK1.V1 (GND), U_BUCK1.V2 (GND), U_BUCK1.V3 (GND), U_BUCK1.V4 (GND), U_BUCK1.V5 (GND), U_BUCK1.V6 (GND)

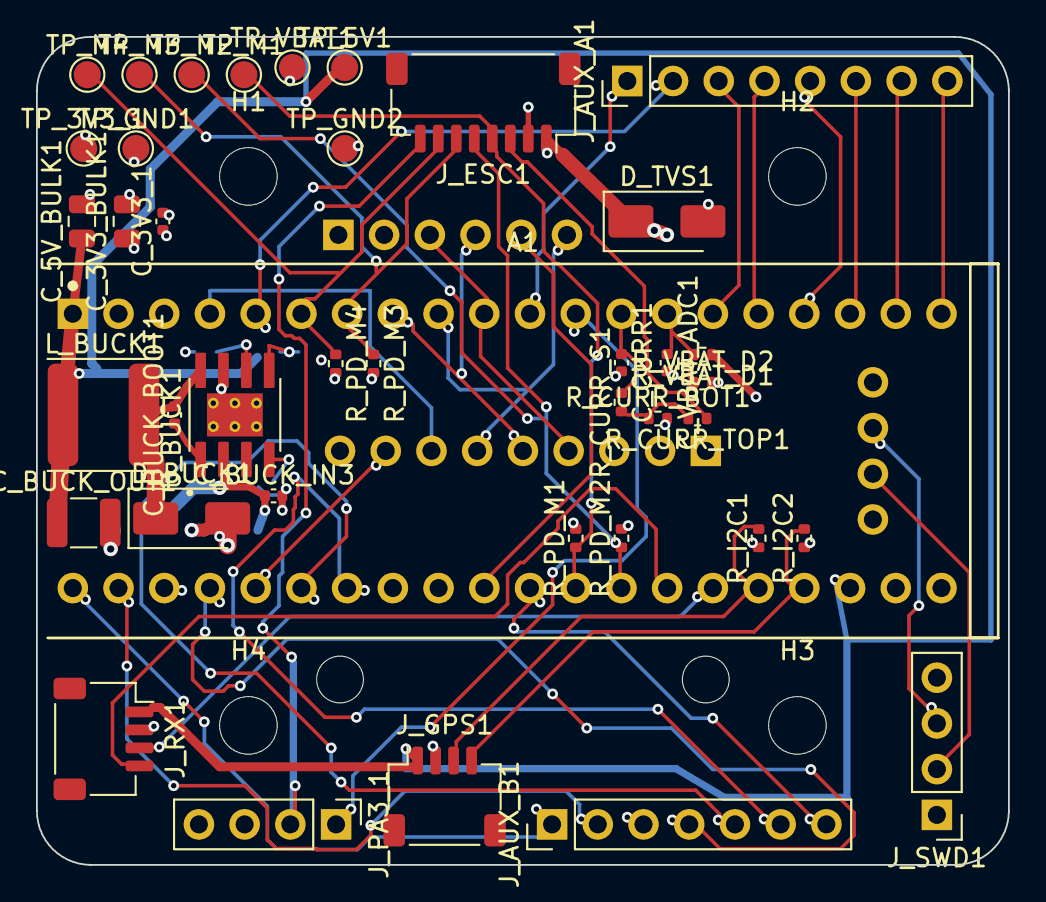
[picture p49: board Flight Controller - carrier board.kicad_pcb from above]

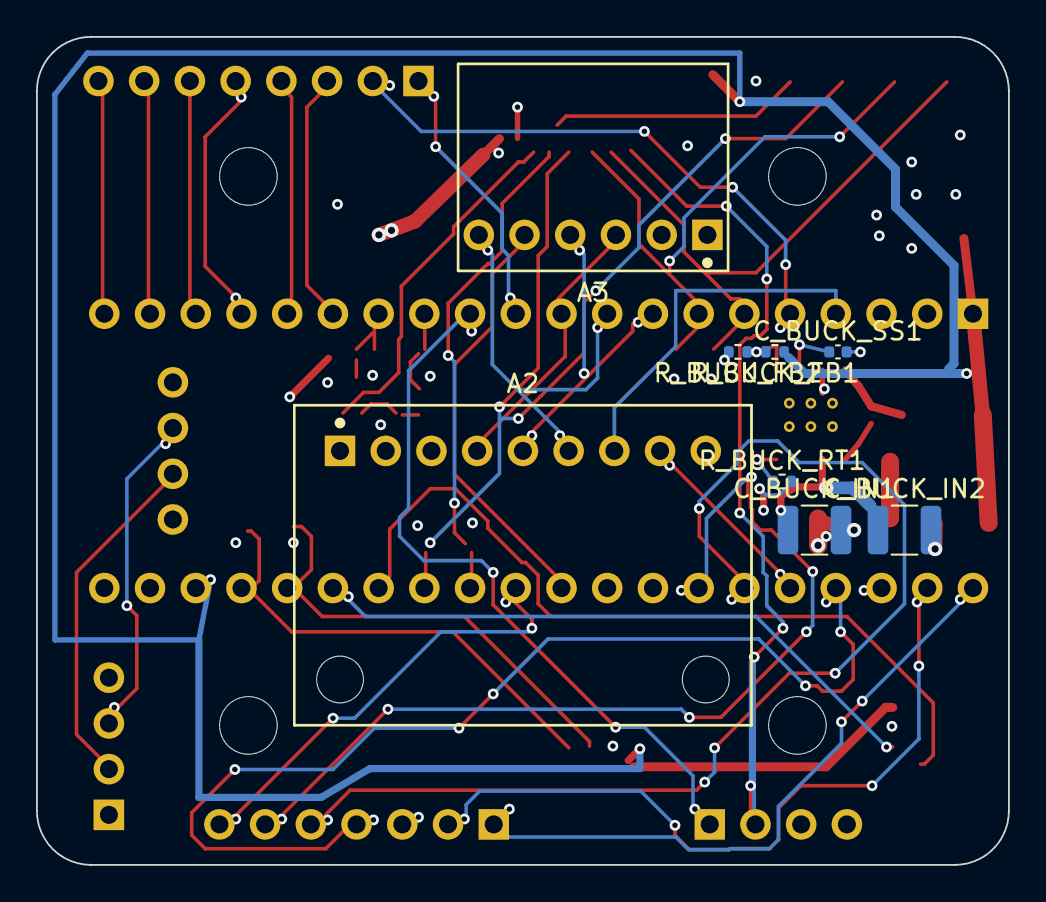
[picture p50: board Flight Controller - carrier board.kicad_pcb from below]

Board: 4 copper layers, 54.0 x 46.0 mm, 52 parts (8 on the bottom side), 46 nets.
