benwys/SparrowHawk/hardware/Sparrow-II/STM32 Pin Map/STM32 Pin Map.ioc

Mcu.UserName=STM32F722RETx
PA10.GPIO_Label=RC_RX
PA10.Signal=USART1_RX
PA11.Signal=USB_OTG_FS_DM
PA12.Signal=USB_OTG_FS_DP
PA13.Signal=SYS_JTMS-SWDIO
PA14.Signal=SYS_JTCK-SWCLK
PA2.GPIO_Label=GPS_TX
PA2.Signal=USART2_TX
PA3.GPIO_Label=GPS_RX
PA3.Signal=USART2_RX
PA4.GPIO_Label=IMU_CS
PA4.Signal=GPIO_Output
PA5.Signal=SPI1_SCK
PA6.Signal=SPI1_MISO
PA7.Signal=SPI1_MOSI
PA9.GPIO_Label=RC_TX
PA9.Signal=USART1_TX
PB0.GPIO_Label=LED_STAT1
PB0.Signal=GPIO_Output
PB1.GPIO_Label=LED_STAT1
PB1.Signal=GPIO_Output
PB10.GPIO_Label=ESC_TEL
PB10.Signal=USART3_TX
PB11.Signal=USART3_RX
PB12.GPIO_Label=FLASH_CS
PB12.Signal=GPIO_Output
PB13.Signal=SPI2_SCK
PB14.Signal=SPI2_MISO
PB15.Signal=SPI2_MOSI
PB2.GPIO_Label=OSD_CS
PB2.Signal=GPIO_Output
PB3.Signal=SPI3_SCK
PB4.Signal=SPI3_MISO
PB5.Signal=SPI3_MOSI
PB6.Signal=I2C1_SCL
PB7.Signal=I2C1_SDA
PC1.Signal=ADCx_IN11
PC10.Signal=UART4_TX
PC13.GPIO_Label=BUZZER_CTRL
PC13.Signal=GPIO_Output
PC2.Signal=ADCx_IN12
PC4.GPIO_Label=IMU_INT
PC4.Signal=GPXTI4
PC6.Signal=S_TIM3_CH1
PC7.Signal=S_TIM3_CH2
PC8.Signal=S_TIM3_CH3
PC9.Signal=S_TIM3_CH4
PH0-OSC_IN.Signal=RCC_OSC_IN
PH1-OSC_OUT.Signal=RCC_OSC_OUT
