benwys/SparrowHawk/(commit log)

2026-08-07 PCB schematic; Board outline
    [Flight Controller.kicad_pcb, Flight Controller.kicad_sch, Interfaces&IO.kicad_sch, MCU Core.kicad_sch, MCU.kicad_sch, Power.kicad_sch, Sensors.kicad_sch, Video&OSD.kicad_sch]
2026-08-07 hardware: fixes connected to ERC errors 1/2
    [Flight Controller.kicad_pcb, Interfaces&IO.kicad_sch, Power.kicad_sch, Sensors.kicad_sch, Video&OSD.kicad_sch]
2026-08-07 hardware: fixes connected to ERC errors 2/2
    [Interfaces&IO.kicad_sch, MCU.kicad_sch, Video&OSD.kicad_sch]
2026-08-07 hardware: OSD quick fixes
    [Power.kicad_sch, Video&OSD.kicad_sch]
2026-08-08 hardware: VDD pins fix; OSD floating pin
    [MCU.kicad_sch, Sensors.kicad_sch, Video&OSD.kicad_sch]
2026-08-09 hardware: change in oscilator values
    [MCU.kicad_sch, Sensors.kicad_sch, Video&OSD.kicad_sch]
2026-08-09 hardware: SPARROW II v1.0
    [Flight Controller.kicad_pcb, MCU.kicad_sch]
2026-08-10 hardware: first layout and optimalizations
    [Flight Controller.kicad_pcb]
2026-08-10 hardware: BOM actualization and second layout
    [Flight Controller.kicad_pcb, Flight Controller.kicad_sch, Interfaces&IO.kicad_sch, MCU.kicad_sch, Power.kicad_sch, Sensors.kicad_sch, Video&OSD.kicad_sch]
2026-08-11 hardware: BOM file for SPARROW II
    [sparrow-ii-bom.csv]
2026-08-12 hardware: Layout improvement
    [Flight Controller.kicad_pcb, Flight Controller.kicad_sch, Interfaces&IO.kicad_sch, MCU.kicad_sch, Power.kicad_sch, Sensors.kicad_sch, Video&OSD.kicad_sch]
2026-08-13 hardware: Fixes in layout
    [Flight Controller.kicad_pcb, Flight Controller.kicad_sch]
2026-08-13 hardware: Capacitors change
    [Flight Controller.kicad_pcb]
2026-08-13 hardware: layout checkpoint 1
    [Flight Controller.kicad_pcb]
2026-08-17 hardware: layout checkpoint 3 - fixed DRC
    [Flight Controller.kicad_pcb, Flight Controller.kicad_sch, Interfaces&IO.kicad_sch, MCU.kicad_sch, Video&OSD.kicad_sch]
2026-08-18 hardware: decoupling capacitors route
    [Flight Controller.kicad_pcb, Video&OSD.kicad_sch]
2026-08-19 hardware: mcu routed & buck in progress
    [Flight Controller.kicad_pcb]
2026-08-24 hardware: buck, baro, blackbox, osd routed
    [Flight Controller.kicad_pcb]
2026-08-24 hardware: checkpoint - 1 unrouted track
    [Flight Controller.kicad_pcb]
2026-08-24 hardware: checkpoint - all routed
    [Flight Controller.kicad_pcb]
2026-08-25 hardware: Sparrow II routed
    [Flight Controller.kicad_pcb, Flight Controller.kicad_sch, Interfaces&IO.kicad_sch, MCU.kicad_sch, Power.kicad_sch, Sensors.kicad_sch, Video&OSD.kicad_sch]
2026-08-25 hardware: finished board with sparrowhawk silkscreen
    [Flight Controller-B_Cu.gbl, Flight Controller-B_Mask.gbs, Flight Controller-B_Paste.gbp, Flight Controller-B_Silkscreen.gbo, Flight Controller-Edge_Cuts.gm1, Flight Controller-F_Cu.gtl, Flight Controller-F_Mask.gts, Flight Controller-F_Paste.gtp]
2026-08-26 hardware: renaming production folder
    [Flight Controller-B_Cu.gbl, Flight Controller-B_Mask.gbs, Flight Controller-B_Paste.gbp, Flight Controller-B_Silkscreen.gbo, Flight Controller-Edge_Cuts.gm1, Flight Controller-F_Cu.gtl, Flight Controller-F_Mask.gts, Flight Controller-F_Paste.gtp]
2026-09-11 hardware: Sparrow III symbols and footprints
2026-09-12 hardware: Sparrow I libraries and schematic
2026-09-14 hardware: Sparrow I carrier board layout
2026-09-15 hardware: Sparrow III LGA-12 footprint pad fix
2026-09-17 hardware: Sparrow III Vishay IHLP-2525 inductor footprint
2026-09-19 hardware: Sparrow III power sheet rework
2026-09-21 hardware: Sparrow III sensors sheet rework
2026-09-25 hardware: Sparrow III root schematic update
2026-09-26 hardware: Sparrow III RX solder pad footprint
2026-09-27 hardware: Sparrow III SWD solder pad footprint
2026-09-28 hardware: Sparrow III VTX solder pad footprint
2026-09-30 hardware: Sparrow III SOT-23-5 DYD LDO footprint
2026-10-01 hardware: Sparrow III USB-C receptacle footprint fix
2026-10-02 hardware: Sparrow III VBAT solder pads update
2026-10-03 hardware: Sparrow III gerbers and drill files
2026-10-03 hardware: Sparrow III BOM, CPL and polarity check
2026-10-03 hardware: Sparrow III assembly drawings and order notes
2026-10-04 hardware: Sparrow III board for manual assembly
2026-10-05 hardware: add MicoAir AM32 4in1 ESC board
2026-10-06 hardware: Sparrow III gerbers for Y6 order
2026-10-06 hardware: ESC 3D models and render
2026-10-07 docs: consolidated BOM and docs cleanup
2026-10-08 hardware: 5 inch frame STEP parts
2026-10-09 hardware: 5 inch frame STL exports
2026-10-10 hardware: 5 inch frame renders
2026-10-11 hardware: 5 inch frame assembly STEP
